andrew1593571/RCETLaserArcade/Documentation/Fall_2024/Images/IMG_5609.PNG

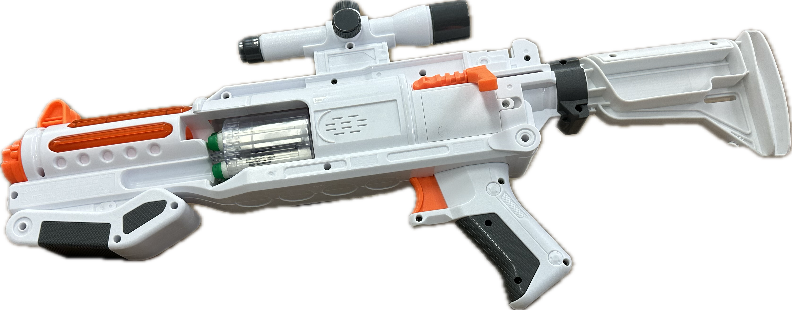
Documentation/Fall_2024/Images/IMG_5609.PNG
