andrew1593571/RCETLaserArcade/Documentation/Fall_2024/Images/Nerf Arcade.jpg

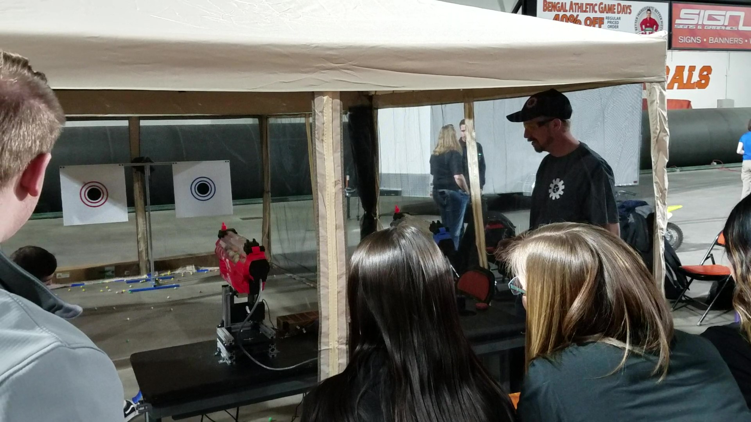
Documentation/Fall_2024/Images/Nerf Arcade.jpg
