andrew1593571/RCETLaserArcade/README.md

# Laser-Arcade-Project
All documentation of the Laser Arcade Project
