andrew1593571/RCETLaserArcade/KiCad/Target_Master/Target Back.png

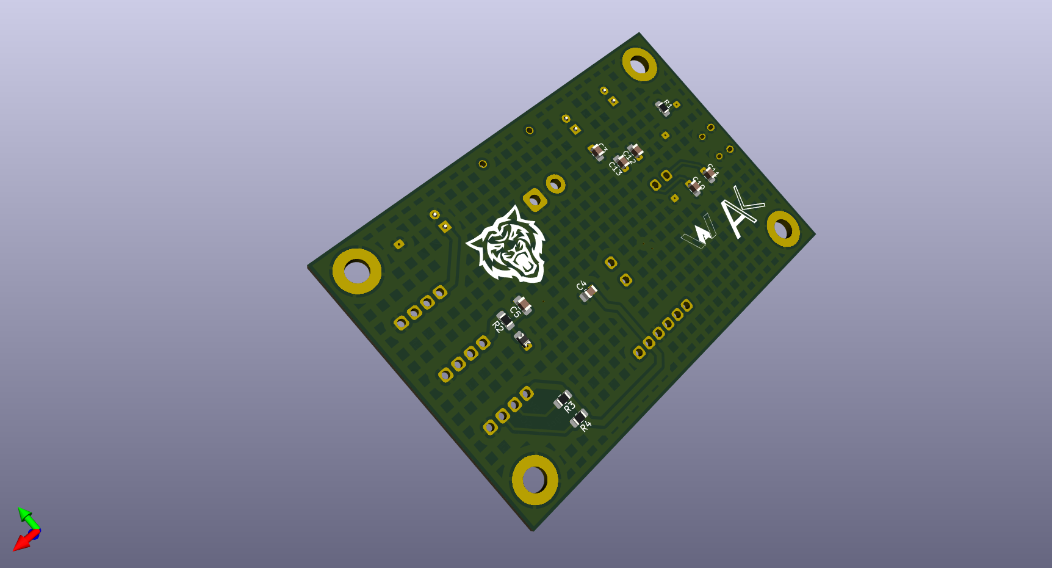
KiCad/Target_Master/Target Back.png
