andrew1593571/RCETLaserArcade/KiCad/Target_Master/Target.png

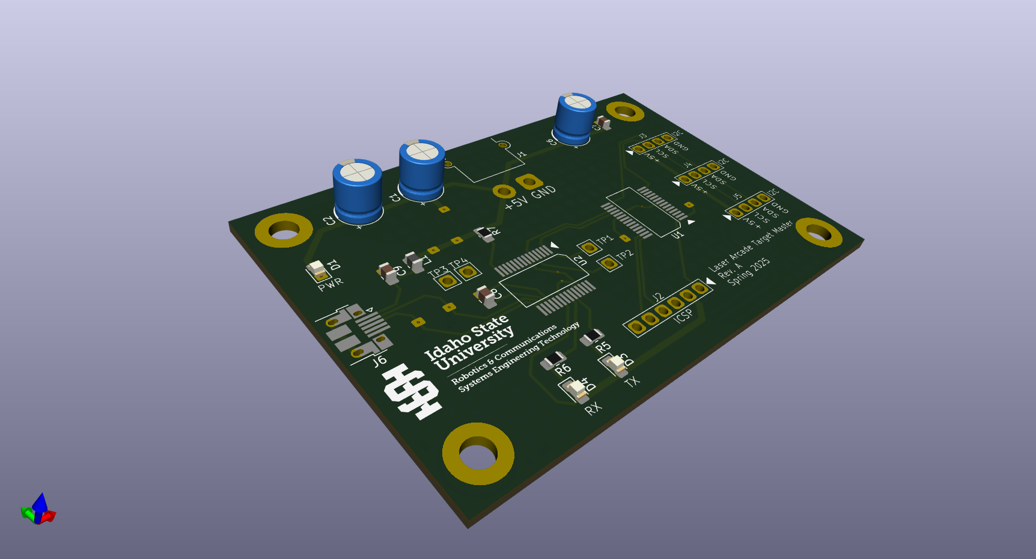
KiCad/Target_Master/Target.png
