andrew1593571/RCETLaserArcade/VBArcadeControl/VBArcadeControl/Resources/serial-port.png

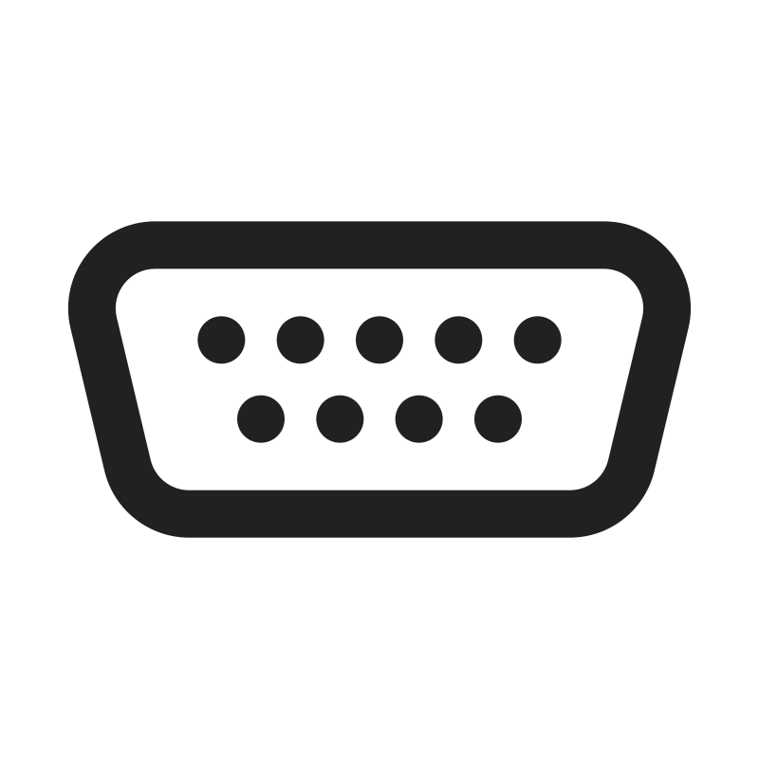
VBArcadeControl/VBArcadeControl/Resources/serial-port.png
