andrew1593571/RCETLaserArcade/Documentation/Fall_2024/Project BOMs.xlsx

Sheet: Blaster
Item Number | Quantity | Component Type | Value | Project Component(s) Included: | Package | Supplier | Part Number | Cost/Part(based on 100 QTY) | Cost for 100 PCB | Cost/PCB | Component Type | Value | Quantity | Part Number | Cost/Part(based on 100 QTY) | Cost/PCB
1 | 2 | Capacitor | 10uF | C1,C2 | 0805 | Mouser | 187-CL21A106MQFNNNE (https://www.mouser.com/ProductDetail/Samsung-Electro-Mechanics/CL21A106MQFNNNE) | $0.022 | $4.40 | $0.044 | Capacitor | 10uF | 2 | 187-CL21A106MQFNNNE (https://www.mouser.com/ProductDetail/Samsung-Electro-Mechanics/CL21A106MQFNNNE) | $0.022 | 0.044
2 | 3 | Capacitor | 1uF | C3,C5,C6 | 0805 | Mouser | 581-KAF21KR71E105KL (https://www.mouser.com/ProductDetail/KYOCERA-AVX/KAF21KR71E105KL) | $0.12 | $36.00 | $0.36 | Capacitor | 1uF | 3 | 581-KAF21KR71E105KL (https://www.mouser.com/ProductDetail/KYOCERA-AVX/KAF21KR71E105KL) | $0.12 | 0.36
3 | 1 | Capacitor | 50pF | C4 | 0805 | Mouser | 791-0805N500J250CT (https://www.mouser.com/ProductDetail/Walsin/0805N500J250CT?qs=ZrPdAQfJ6DN5LhW6Du3x9A%3D%3D) | $0.023 | $2.30 | $0.023 | Capacitor | 50pF | 1 | 791-0805N500J250CT (https://www.mouser.com/ProductDetail/Walsin/0805N500J250CT?qs=ZrPdAQfJ6DN5LhW6Du3x9A%3D%3D) | $0.023 | 0.023
4 | 1 | LED | Green | D1 | 0805 | Mouser | 710-150080GS75000 (https://www.mouser.com/ProductDetail/Wurth-Elektronik/150080GS75000?qs=2kOmHSv6VfQRoTEZVk1mGA%3D%3D) | $0.151 | $15.10 | $0.151 | LED | Green | 1 | 710-150080GS75000 (https://www.mouser.com/ProductDetail/Wurth-Elektronik/150080GS75000?qs=2kOmHSv6VfQRoTEZVk1mGA%3D%3D) | $0.151 | 0.151
5 | 1 | Diode | 1N4148 | D2 | SOD-123F | Mouser | 637-1N4148W (https://www.mouser.com/ProductDetail/Diotec-Semiconductor/1N4148W?qs=OlC7AqGiEDmsbkbAeXQtXg%3D%3D) | $0.031 | $3.10 | $0.031 | Diode | 1N4148 | 1 | 637-1N4148W (https://www.mouser.com/ProductDetail/Diotec-Semiconductor/1N4148W?qs=OlC7AqGiEDmsbkbAeXQtXg%3D%3D) | $0.031 | 0.031
6 | 1 | Pin Header | 1x5 | J1 | 1x5 Vertical Pin Header (P2.54mm) | Mouser | M20-9990546 (https://www.mouser.com/ProductDetail/Harwin/M20-9990546?qs=ulE8k0yEMYY8EKyDN9ic6A%3D%3D) | $0.133 | $13.30 | $0.133 | Pin Header | 1x5 | 1 | M20-9990546 (https://www.mouser.com/ProductDetail/Harwin/M20-9990546?qs=ulE8k0yEMYY8EKyDN9ic6A%3D%3D) | $0.133 | 0.133
7 | 2 | Pin Header | 1x2 | LD1/S1 | 1x2 Vertical Pin Header (P2.54mm) | Mouser | M20-9990246 (https://www.mouser.com/ProductDetail/Harwin/M20-9990246?qs=Jph8NoUxIfWjw4WmyRvzag%3D%3D) | $0.062 | $12.40 | $0.124 | Pin Header | 1x2 | 2 | M20-9990246 (https://www.mouser.com/ProductDetail/Harwin/M20-9990246?qs=Jph8NoUxIfWjw4WmyRvzag%3D%3D) | $0.062 | 0.124
8 | 1 | Laser | Laser Diode | LD1 | N/A | eBay | N/A (https://www.ebay.com/itm/134783770111?chn=ps&google_free_listing_action=view_item) | $3.001 | $300.10 | $3.001 | Laser | Laser Diode | 1 | N/A (https://www.ebay.com/itm/134783770111?chn=ps&google_free_listing_action=view_item) | $3.001 | 3.001
9 | 2 | Transistor | 2N3904 | Q1,Q2 | TO-92 | Mouser | 512-2N3904TA (https://www.mouser.com/ProductDetail/onsemi-Fairchild/2N3904TA?qs=ljbEvF4DwOOn1Ev%2FzRYaoA%3D%3D) | $0.064 | $12.80 | $0.128 | Transistor | 2N3904 | 2 | 512-2N3904TA (https://www.mouser.com/ProductDetail/onsemi-Fairchild/2N3904TA?qs=ljbEvF4DwOOn1Ev%2FzRYaoA%3D%3D) | $0.064 | 0.128
10 | 1 | Transistor | TIP41 | Q3 | TO-220 | Mouser | 511-TIP41C (https://www.mouser.com/ProductDetail/STMicroelectronics/TIP41C?qs=ljbEvF4DwOPALsfJVTZHww%3D%3D) | $0.449 | $44.90 | $0.449 | Transistor | TIP41 | 1 | 511-TIP41C (https://www.mouser.com/ProductDetail/STMicroelectronics/TIP41C?qs=ljbEvF4DwOPALsfJVTZHww%3D%3D) | $0.449 | 0.449
11 | 1 | Resistor | 2.2KΩ | R1 | 0805 | Mouser | 71-CRCW080522K0JNEAC (https://www.mouser.com/ProductDetail/Vishay-Dale/CRCW080522K0JNEAC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) | $0.01 | $1.00 | $0.01 | Resistor | 2.2KΩ | 1 | 71-CRCW080522K0JNEAC (https://www.mouser.com/ProductDetail/Vishay-Dale/CRCW080522K0JNEAC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) | $0.01 | 0.01
12 | 4 | Resistor | 330Ω | R2,R3,R4,R5 | 0805 | Mouser | 603-RC0805JR-13330RL (https://www.mouser.com/ProductDetail/YAGEO/RC0805JR-13330RL) | $0.009 | $3.60 | $0.036 | Resistor | 330Ω | 4 | 603-RC0805JR-13330RL (https://www.mouser.com/ProductDetail/YAGEO/RC0805JR-13330RL) | $0.009 | 0.036
13 | 1 | Resistor | 1kΩ | R6 | 0805 | Mouser | 667-ERA-6APB102V (https://www.mouser.com/ProductDetail/Panasonic/ERA-6APB102V?qs=sGAEpiMZZMtlubZbdhIBIJiMSTY83nT4MhkwRno9TZY%3D) | $0.266 | $26.60 | $0.266 | Resistor | 1kΩ | 1 | 667-ERA-6APB102V (https://www.mouser.com/ProductDetail/Panasonic/ERA-6APB102V?qs=sGAEpiMZZMtlubZbdhIBIJiMSTY83nT4MhkwRno9TZY%3D) | $0.266 | 0.266
14 | 1 | Resistor | 40kΩ | R7 | 0805 | Mouser | 71-CRCW080540K0FKEA (https://www.mouser.com/ProductDetail/Vishay-Dale/CRCW080540K0FKEA) | $0.018 | $1.80 | $0.018 | Resistor | 40kΩ | 1 | 71-CRCW080540K0FKEA (https://www.mouser.com/ProductDetail/Vishay-Dale/CRCW080540K0FKEA) | $0.018 | 0.018
15 | 1 | Resistor | 10kΩ | R8 | 0805 | Mouser | 791-RMC1/10K1002FTP (https://www.mouser.com/ProductDetail/Kamaya/RMC1-10K1002FTP) | $0.008 | $0.80 | $0.008 | Resistor | 10kΩ | 1 | 791-RMC1/10K1002FTP (https://www.mouser.com/ProductDetail/Kamaya/RMC1-10K1002FTP) | $0.008 | 0.008
16 | 1 | Solenoid | 12V | S1 | N/A | Amazon | BM-0530B (https://www.amazon.com/Baomain-Solenoid-Electromagnet-JF-0530B-PushPull/dp/B01K41EZAU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) | $7.49 | $749.00 | $7.49 | Solenoid | 12V | 1 | BM-0530B (https://www.amazon.com/Baomain-Solenoid-Electromagnet-JF-0530B-PushPull/dp/B01K41EZAU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) | $7.49 | 7.49
17 | 1 | Switch | Momentary | SW1 | N/A | Amazon | TS-D001 (https://www.amazon.com/Momentary-Pushbutton-Switches-Breadboard-Electronic/dp/B09R47N37H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) | $0.05 | $5.00 | $0.05 | Switch | Momentary | 1 | TS-D001 (https://www.amazon.com/Momentary-Pushbutton-Switches-Breadboard-Electronic/dp/B09R47N37H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) | $0.05 | 0.05
18 | 1 | Switch | Toggle | SW2 | N/A | Mouser | 612-EG1215AA (https://www.mouser.com/ProductDetail/E-Switch/EG1215AA?qs=lc2O%252BfHJPVZHH%2F6aw0qQrA%3D%3D&mgh=1) | $0.683 | $68.30 | $0.683 | Switch | Toggle | 1 | 612-EG1215AA (https://www.mouser.com/ProductDetail/E-Switch/EG1215AA?qs=lc2O%252BfHJPVZHH%2F6aw0qQrA%3D%3D&mgh=1) | $0.683 | 0.683
19 | 1 | Switch | SP3T | SW3 | N/A | Jameco | 2236244 (https://www.jameco.com/z/SR2513-43NS-Taiwan-Alpha-4-Poles-3-Positions-Rotary-Switch-300mA-125VAC-Non-Shorting_2236244.html) | $0.35 | $35.00 | $0.35 | Switch | SP3T | 1 | 2236244 (https://www.jameco.com/z/SR2513-43NS-Taiwan-Alpha-4-Poles-3-Positions-Rotary-Switch-300mA-125VAC-Non-Shorting_2236244.html) | $0.35 | 0.35
20 | 1 | Voltage Regulator | AMS1117-5.0 | U1 | SOT-223 | Mouser | 926-LM1117MPX5.0NOPB (https://www.mouser.com/ProductDetail/Texas-Instruments/LM1117MPX-5.0-NOPB?qs=X1J7HmVL2ZE1O12Qsl7F9g%3D%3D) | $0.543 | $54.30 | $0.543 | Voltage Regulator | AMS1117-5.0 | 1 | 926-LM1117MPX5.0NOPB (https://www.mouser.com/ProductDetail/Texas-Instruments/LM1117MPX-5.0-NOPB?qs=X1J7HmVL2ZE1O12Qsl7F9g%3D%3D) | $0.543 | 0.543
21 | 1 | Microcontroller | PIC16F1788 | U2 | SSOP-28 | Mouser | 579-PIC16F1788T-I/SS (https://www.mouser.com/ProductDetail/Microchip-Technology/PIC16F1788T-I-SS?qs=7DhvGWG6CteZbh5vjho%2Fqg%3D%3D) | $2.25 | $225.00 | $2.25 | Microcontroller | PIC16F1788 | 1 | 579-PIC16F1788T-I/SS (https://www.mouser.com/ProductDetail/Microchip-Technology/PIC16F1788T-I-SS?qs=7DhvGWG6CteZbh5vjho%2Fqg%3D%3D) | $2.25 | 2.25
 |  |  |  |  |  |  |  |  | Total: | $16.15 |  |  |  |  | Total: | $16.15
 |  |  |  |  |  |  |  |  | Total per 100: | $1614.80

Sheet: Master
Item Number | Quantity | Component Type | Value | Project Component(s) Included: | Package | Supplier | Part Number | Cost/Part(based on 100 QTY) | Cost for 100 PCB | Cost/PCB | Component Type | Value | Quantity | Part Number | Cost/Part(based on 100 QTY) | Cost/PCB
1 | 2 | Capacitor | 10uF | C1,C2 | 0805 | Mouser | 187-CL21A106MQFNNNE (https://www.mouser.com/ProductDetail/Samsung-Electro-Mechanics/CL21A106MQFNNNE) | $0.022 | $4.40 | $0.04 | Capacitor | 10uF | 2 | 187-CL21A106MQFNNNE (https://www.mouser.com/ProductDetail/Samsung-Electro-Mechanics/CL21A106MQFNNNE) | $0.022 | $0.04
2 | 3 | Capacitor | 1uF | C3,C4,C5 | 0805 | Mouser | 581-KAF21KR71E105KL (https://www.mouser.com/ProductDetail/KYOCERA-AVX/KAF21KR71E105KL) | $0.12 | $36.00 | $0.36 | Capacitor | 1uF | 3 | 581-KAF21KR71E105KL (https://www.mouser.com/ProductDetail/KYOCERA-AVX/KAF21KR71E105KL) | $0.12 | $0.36
3 | 1 | LED | Green | D1 | 0805 | Mouser | 710-150080GS75000 (https://www.mouser.com/ProductDetail/Wurth-Elektronik/150080GS75000?qs=2kOmHSv6VfQRoTEZVk1mGA%3D%3D) | $0.151 | $15.10 | $0.151 | LED | Green | 1 | 710-150080GS75000 (https://www.mouser.com/ProductDetail/Wurth-Elektronik/150080GS75000?qs=2kOmHSv6VfQRoTEZVk1mGA%3D%3D) | $0.151 | $0.15
4 | 1 | Diode | 1N4148 | D2 | SOD-123F | Mouser | 637-1N4148W (https://www.mouser.com/ProductDetail/Diotec-Semiconductor/1N4148W?qs=OlC7AqGiEDmsbkbAeXQtXg%3D%3D) | $0.031 | $3.10 | $0.031 | Diode | 1N4148 | 1 | 637-1N4148W (https://www.mouser.com/ProductDetail/Diotec-Semiconductor/1N4148W?qs=OlC7AqGiEDmsbkbAeXQtXg%3D%3D) | $0.031 | $0.03
5 | 1 | LCD Display | LK204-25 | DS1 | N/A | Mouser | 891-LK204-25-E (https://www.mouser.com/ProductDetail/Matrix-Orbital/LK204-25-E?qs=sBNdiSg%2FL5WqFSFQuSy%2FbQ%3D%3D) | $67.72 | $6772.00 | $67.72 | LCD Display | LK204-25 | 1 | 891-LK204-25-E (https://www.mouser.com/ProductDetail/Matrix-Orbital/LK204-25-E?qs=sBNdiSg%2FL5WqFSFQuSy%2FbQ%3D%3D) | $67.72 | $67.72
6 | 1 | Connector | RJ11 Header | J1 | Female | Mouser | 649-54601-906001WPLF (https://www.mouser.com/ProductDetail/Amphenol-FCI/54601-906001WPLF?qs=A%252Bwkq3FTowXIf3bXQPL90g%3D%3D) | $0.104 | $10.40 | $0.104 | Connector | RJ11 Header | 1 | 649-54601-906001WPLF (https://www.mouser.com/ProductDetail/Amphenol-FCI/54601-906001WPLF?qs=A%252Bwkq3FTowXIf3bXQPL90g%3D%3D) | $0.104 | $0.10
7 | 1 | Pin Header | 1x5 | J2 | 1x5 Vertical Pin Header (P2.54mm) | Mouser | M20-9990546 (https://www.mouser.com/ProductDetail/Harwin/M20-9990546?qs=ulE8k0yEMYY8EKyDN9ic6A%3D%3D) | $0.133 | $13.30 | $0.133 | Pin Header | 1x5 | 1 | M20-9990546 (https://www.mouser.com/ProductDetail/Harwin/M20-9990546?qs=ulE8k0yEMYY8EKyDN9ic6A%3D%3D) | $0.133 | $0.13
8 | 1 | Resistor | 2.2KΩ | R1 | 0805 | Mouser | 71-CRCW080522K0JNEAC (https://www.mouser.com/ProductDetail/Vishay-Dale/CRCW080522K0JNEAC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) | $0.01 | $1.00 | $0.01 | Resistor | 2.2KΩ | 1 | 71-CRCW080522K0JNEAC (https://www.mouser.com/ProductDetail/Vishay-Dale/CRCW080522K0JNEAC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) | $0.01 | $0.01
9 | 1 | Resistor | 10kΩ | R2 | 0805 | Mouser | 791-RMC1/10K1002FTP (https://www.mouser.com/ProductDetail/Kamaya/RMC1-10K1002FTP) | $0.008 | $0.80 | $0.008 | Resistor | 10kΩ | 1 | 791-RMC1/10K1002FTP (https://www.mouser.com/ProductDetail/Kamaya/RMC1-10K1002FTP) | $0.008 | $0.01
10 | 2 | Resistor | 4.7kΩ | R3,R4 | 0805 | Mouser | 603-AC0805DR-074K7L (https://www.mouser.com/ProductDetail/YAGEO/AC0805DR-074K7L) | $0.023 | $4.60 | $0.05 | Resistor | 4.7kΩ | 2 | 603-AC0805DR-074K7L (https://www.mouser.com/ProductDetail/YAGEO/AC0805DR-074K7L) | $0.023 | $0.05
11 | 1 | Voltage Regulator | AMS1117-5.0 | U1 | SOT-223 | Mouser | 926-LM1117MPX5.0NOPB (https://www.mouser.com/ProductDetail/Texas-Instruments/LM1117MPX-5.0-NOPB?qs=X1J7HmVL2ZE1O12Qsl7F9g%3D%3D) | $0.543 | $54.30 | $0.543 | Voltage Regulator | AMS1117-5.0 | 1 | 926-LM1117MPX5.0NOPB (https://www.mouser.com/ProductDetail/Texas-Instruments/LM1117MPX-5.0-NOPB?qs=X1J7HmVL2ZE1O12Qsl7F9g%3D%3D) | $0.543 | $0.54
12 | 1 | Microcontroller | PIC16F1788 | U2 | SSOP-28 | Mouser | 579-PIC16F1788T-I/SS (https://www.mouser.com/ProductDetail/Microchip-Technology/PIC16F1788T-I-SS?qs=7DhvGWG6CteZbh5vjho%2Fqg%3D%3D) | $2.25 | $225.00 | $2.25 | Microcontroller | PIC16F1788 | 1 | 579-PIC16F1788T-I/SS (https://www.mouser.com/ProductDetail/Microchip-Technology/PIC16F1788T-I-SS?qs=7DhvGWG6CteZbh5vjho%2Fqg%3D%3D) | $2.25 | $2.25
 |  |  |  |  |  |  |  |  | Total: | $71.40 |  |  |  |  | Total: | $71.40 | $0.00 | $0.00
 |  |  |  |  |  |  |  |  | Total per 100: | $7140.00

Sheet: Slave
Item Number | Quantity | Component Type | Value | Project Component(s) Included: | Package | Supplier | Part Number | Cost/Part(based on 100 QTY) | Cost for 100 PCB | Cost/PCB
1 | 4 | Capacitor | 1uF | C1,C2,C3,C4 | 0805 | Mouser | 581-KAF21KR71E105KL (https://www.mouser.com/ProductDetail/KYOCERA-AVX/KAF21KR71E105KL) | $0.12 | $48.00 | $0.48
2 | 1 | Diode | 1N4148 | D1 | SOD-123F | Mouser | 637-1N4148W (https://www.mouser.com/ProductDetail/Diotec-Semiconductor/1N4148W?qs=OlC7AqGiEDmsbkbAeXQtXg%3D%3D) | $0.031 | $3.10 | $0.031
3 | 16 | LED | Red | D2,D3,D4,D5,D6,D7,D8,D9,D10,D11,D12,D13,D14,D15,D16,D17 | 0805 | Mouser | 710-150080RS75000 (https://www.mouser.com/ProductDetail/Wurth-Elektronik/150080RS75000?qs=LlUlMxKIyB2jdCo7bnfgew%3D%3D) | $0.151 | $241.60 | $2.416
4 | 1 | Pin Header | 1x5 | J1 | 1x5 Vertical Pin Header (P2.54mm) | Mouser | M20-9990546 (https://www.mouser.com/ProductDetail/Harwin/M20-9990546?qs=ulE8k0yEMYY8EKyDN9ic6A%3D%3D) | $0.133 | $13.30 | $0.133
5 | 2 | Connector | RJ11 Header | J2,J3 | Female | Mouser | 649-54601-906001WPLF (https://www.mouser.com/ProductDetail/Amphenol-FCI/54601-906001WPLF?qs=A%252Bwkq3FTowXIf3bXQPL90g%3D%3D) | $0.104 | $20.80 | $0.208
6 | 1 | Transistor | STN851 | Q1 | SOT-223-4 | Mouser | 511-STN851-A (https://www.mouser.com/ProductDetail/STMicroelectronics/STN851-A?qs=ZGWq6n3A68IcJvqLg9%252BYsA%3D%3D) | $0.453 | $45.30 | $0.453
7 | 1 | Resistor | 10kΩ | R1 | 0805 | Mouser | 791-RMC1/10K1002FTP (https://www.mouser.com/ProductDetail/Kamaya/RMC1-10K1002FTP) | $0.008 | $0.80 | $0.008
8 | 16 | Resistor | 330Ω | R2,R3,R4,R5,R6,R7,R8,R10,R11,R12,R13,R14,R15,R16,R17,R18 | 0805 | Mouser | 603-RC0805JR-13330RL (https://www.mouser.com/ProductDetail/YAGEO/RC0805JR-13330RL) | $0.009 | $14.40 | $0.144
9 | 1 | Resistor | 4.7kΩ | R9 | 0805 | Mouser | 603-AC0805DR-074K7L (https://www.mouser.com/ProductDetail/YAGEO/AC0805DR-074K7L) | $0.023 | $2.30 | $0.023 | Component Type | Value | Quantity | Part Number | Cost/Part(based on 100 QTY) | Cost/PCB | Cost/PCB
10 | 1 | IR Receiver | TSOP32238 | U1 | N/A | Mouser | 782-TSOP32238 (https://www.mouser.com/ProductDetail/Vishay-Semiconductors/TSOP32238?qs=EABMROi2%2FsKT2FOMevD8qg%3D%3D) | $0.549 | $54.90 | $0.55 | Capacitor | 1uF | 4 | 581-KAF21KR71E105KL (https://www.mouser.com/ProductDetail/KYOCERA-AVX/KAF21KR71E105KL) | $0.12 | $0.48 | $0.48
11 | 1 | IR Receiver | TSOP53456 | U2 | N/A | Mouser | 78-TSOP53456 (https://www.mouser.com/ProductDetail/Vishay-Semiconductors/TSOP53456?qs=Zedt2TSEyhhZyPG8LSxNcg%3D%3D) | $0.39 | $39.40 | $0.394 | Diode | 1N4148 | 1 | 637-1N4148W (https://www.mouser.com/ProductDetail/Diotec-Semiconductor/1N4148W?qs=OlC7AqGiEDmsbkbAeXQtXg%3D%3D) | $0.031 | $0.03 | $0.03
12 | 1 | Microcontroller | PIC16F1788 | U3 | SSOP-28 | Mouser | 579-PIC16F1788T-I/SS (https://www.mouser.com/ProductDetail/Microchip-Technology/PIC16F1788T-I-SS?qs=7DhvGWG6CteZbh5vjho%2Fqg%3D%3D) | $2.25 | $225.00 | $2.25 | LED | Red | 16 | 710-150080RS75000 (https://www.mouser.com/ProductDetail/Wurth-Elektronik/150080RS75000?qs=LlUlMxKIyB2jdCo7bnfgew%3D%3D) | $0.151 | $2.42 | $2.42
 |  |  |  |  |  |  |  |  |  |  | Pin Header | 1x5 | 1 | M20-9990546 (https://www.mouser.com/ProductDetail/Harwin/M20-9990546?qs=ulE8k0yEMYY8EKyDN9ic6A%3D%3D) | $0.133 | $0.13 | $0.13
 |  |  |  |  |  |  |  |  | Total: | $7.09 | Connector | RJ11 Header | 2 | 649-54601-906001WPLF (https://www.mouser.com/ProductDetail/Amphenol-FCI/54601-906001WPLF?qs=A%252Bwkq3FTowXIf3bXQPL90g%3D%3D) | $0.104 | $0.21 | $0.21
 |  |  |  |  |  |  |  |  | Total per 100: | $701.00 | Transistor | STN851 | 1 | 511-STN851-A (https://www.mouser.com/ProductDetail/STMicroelectronics/STN851-A?qs=ZGWq6n3A68IcJvqLg9%252BYsA%3D%3D) | $0.453 | $0.45 | $0.45
 |  |  |  |  |  |  |  |  |  |  | Resistor | 10kΩ | 1 | 791-RMC1/10K1002FTP (https://www.mouser.com/ProductDetail/Kamaya/RMC1-10K1002FTP) | $0.008 | $0.01 | $0.01
 |  |  | Component Type | Value | Quantity | Cost/Part(based on 100 QTY) | Cost for 100 PCB | Cost/PCB |  |  | Resistor | 330Ω | 16 | 603-RC0805JR-13330RL (https://www.mouser.com/ProductDetail/YAGEO/RC0805JR-13330RL) | $0.009 | $0.14 | $0.14
 |  |  | Capacitor | 1uF | 4 | $0.12 | $12.00 | $0.12 |  |  | Resistor | 4.7kΩ | 1 | 603-AC0805DR-074K7L (https://www.mouser.com/ProductDetail/YAGEO/AC0805DR-074K7L) | $0.023 | $0.02 | $0.02
 |  |  | Diode | 1N4148 | 1 | $0.031 | $3.10 | $0.031 |  |  | IR Receiver | TSOP32238 | 1 | 782-TSOP32238 (https://www.mouser.com/ProductDetail/Vishay-Semiconductors/TSOP32238?qs=EABMROi2%2FsKT2FOMevD8qg%3D%3D) | $0.549 | $0.55 | $0.55
 |  |  | LED | Red | 16 | $0.151 | $15.10 | $0.151 |  |  | IR Receiver | TSOP53456 | 1 | 78-TSOP53456 (https://www.mouser.com/ProductDetail/Vishay-Semiconductors/TSOP53456?qs=Zedt2TSEyhhZyPG8LSxNcg%3D%3D) | $0.39 | $0.39 | $0.39
 |  |  | Pin Header | 1x5 | 1 | $0.133 | $13.30 | $0.133 |  |  | Microcontroller | PIC16F1788 | 1 | 579-PIC16F1788T-I/SS (https://www.mouser.com/ProductDetail/Microchip-Technology/PIC16F1788T-I-SS?qs=7DhvGWG6CteZbh5vjho%2Fqg%3D%3D) | $2.25 | $2.25 | $2.25
 |  |  | Connector | RJ11 Header | 2 | $0.104 | $10.40 | $0.104
 |  |  | Transistor | STN851 | 1 | $0.453 | $45.30 | $0.453 |  |  |  |  |  |  | Total: | $7.09 | $7.09 | Total: | $0.00
 |  |  | Resistor | 10kΩ | 1 | $0.008 | $0.80 | $0.008 |  |  |  |  |  |  |  |  |  | Total per 100: | $701.00
 |  |  | Resistor | 330Ω | 16 | $0.009 | $0.90 | $0.009
 |  |  | Resistor | 4.7kΩ | 1 | $0.023 | $2.30 | $0.023
 |  |  | IR Receiver | TSOP32238 | 1 | $0.549 | $54.90 | $0.55
 |  |  | IR Receiver | TSOP53456 | 1 | $0.39 | $39.40 | $0.394
 |  |  | Microcontroller | PIC16F1788 | 1 | $2.25 | $225.00 | $2.25
