andrew1593571/RCETLaserArcade/Documentation/Fall_2024/Project.xlsx

Reference | Value | Datasheet | Footprint | Qty | DNP
BT1 | 12V | ~ |  | 1
C1,C2 | 10uF | ~ | Capacitor_SMD:C_0805_2012Metric_Pad1.18x1.45mm_HandSolder | 2
C3,C5,C6 | 1uF | ~ | Capacitor_SMD:C_0805_2012Metric_Pad1.18x1.45mm_HandSolder | 3
C4 | 50pF | ~ | Capacitor_SMD:C_0805_2012Metric_Pad1.18x1.45mm_HandSolder | 1
D1 | LED | ~ | LED_SMD:LED_0805_2012Metric_Pad1.15x1.40mm_HandSolder | 1
D2 | 1N4148 | https://assets.nexperia.com/documents/data-sheet/1N4148_1N4448.pdf | Diode_SMD:D_0805_2012Metric_Pad1.15x1.40mm_HandSolder | 1
J1 | ~ |  | Connector_PinHeader_2.54mm:PinHeader_1x05_P2.54mm_Vertical | 1
LD1 | Laser Diode | ~ | Connector_PinHeader_2.54mm:PinHeader_1x02_P2.54mm_Vertical | 1
Q1,Q2 | 2N3904 | https://www.onsemi.com/pub/Collateral/2N3903-D.PDF | Package_TO_SOT_THT:TO-92_Inline | 2
Q3 | TIP41 | https://www.centralsemi.com/get_document.php?cmp=1&mergetype=pd&mergepath=pd&pdf_id=tip41.PDF | Package_TO_SOT_THT:TO-220-3_Vertical | 1
R1 | 2.2KΩ | ~ | Resistor_SMD:R_0805_2012Metric_Pad1.20x1.40mm_HandSolder | 1
R1-R4,R2,R3,R4 | 330Ω | ~ | Resistor_SMD:R_0805_2012Metric_Pad1.20x1.40mm_HandSolder | 4
R5 | 1kΩ | ~ | Resistor_SMD:R_0805_2012Metric_Pad1.20x1.40mm_HandSolder | 1
R6 | 40kΩ | ~ | Resistor_SMD:R_0805_2012Metric_Pad1.20x1.40mm_HandSolder | 1
R7 | 10kΩ | ~ | Resistor_SMD:R_0805_2012Metric_Pad1.20x1.40mm_HandSolder | 1
S1 | Solenoid |  | Connector_PinHeader_2.54mm:PinHeader_1x02_P2.54mm_Vertical | 1
SW1 | SW_Push | ~ |  | 1
SW2 | SW_DIP_x01 | ~ |  | 1
SW3 | SW_SP3T | ~ |  | 1
TP1,TP2,TP3,TP4,TP5,TP6,TP7,TP8 | TestPoint | ~ | AlexWheelockFootprintLibrary:Test Point | 8
U1 | AMS1117-5 | http://www.advanced-monolithic.com/pdf/ds1117.pdf | Package_TO_SOT_SMD:SOT-223-3_TabPin2 | 1
U2 | PIC16F1788-IP |  |  | 1
