andrew1593571/RCETLaserArcade/3D_Models/Blaster/Laser_Arcade_Blaster_Barrel_v2.3mf

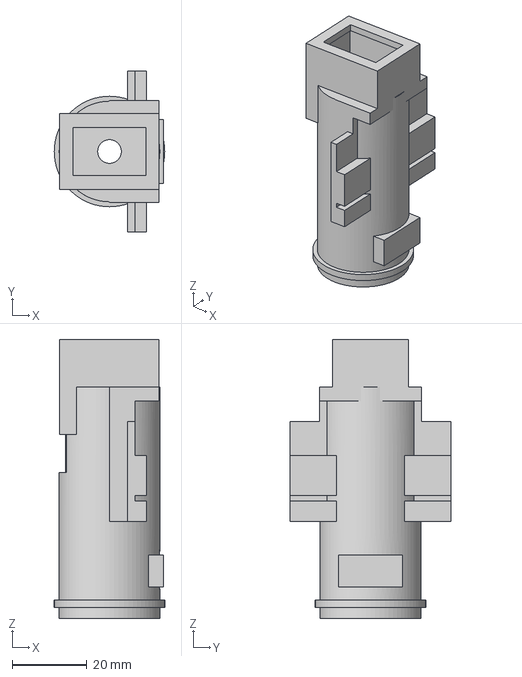
[picture p8: CAD file, 2025-04-29]
3D_Models/Blaster/Laser_Arcade_Blaster_Barrel_v2.3mf
29.6 x 43.1 x 74.7 mm
