andrew1593571/RCETLaserArcade/3D_Models/Targets/LA_4inTarget.stl

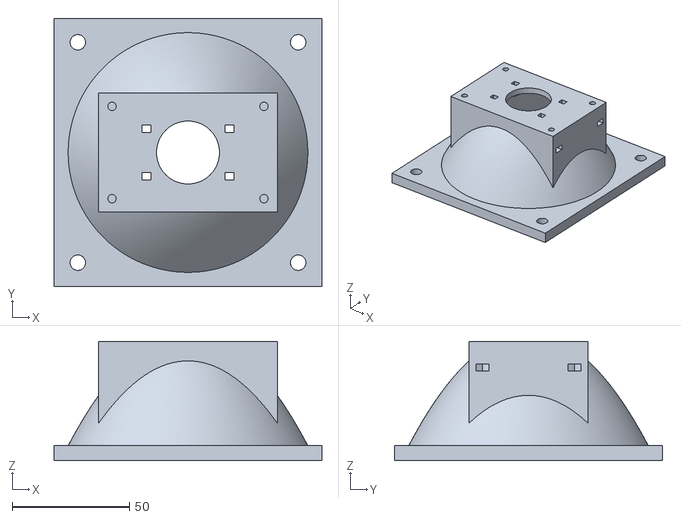
[picture p9: CAD file, 2025-05-08]
3D_Models/Targets/LA_4inTarget.stl
114.3 x 114.3 x 50.8
