andrew1593571/RCETLaserArcade/3D_Models/Blaster/Laser_Arcade_Blaster_Rear_Hook_v2.3mf

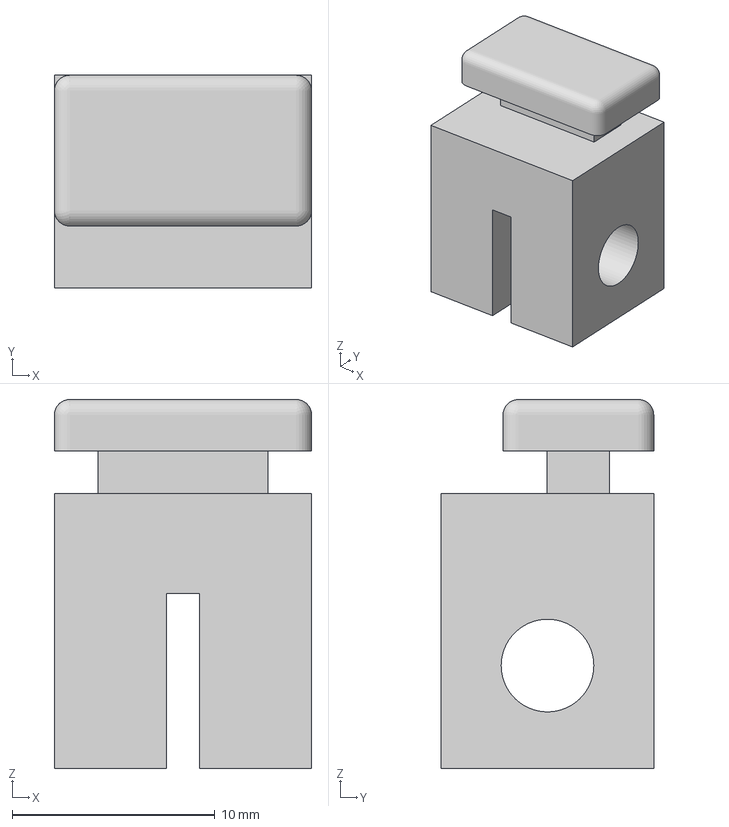
[picture p10: CAD file, 2025-04-29]
3D_Models/Blaster/Laser_Arcade_Blaster_Rear_Hook_v2.3mf
12.7 x 10.5 x 18.2 mm
