andrew1593571/RCETLaserArcade/3D_Models/Targets/LA_DIN Rail Mount.stl

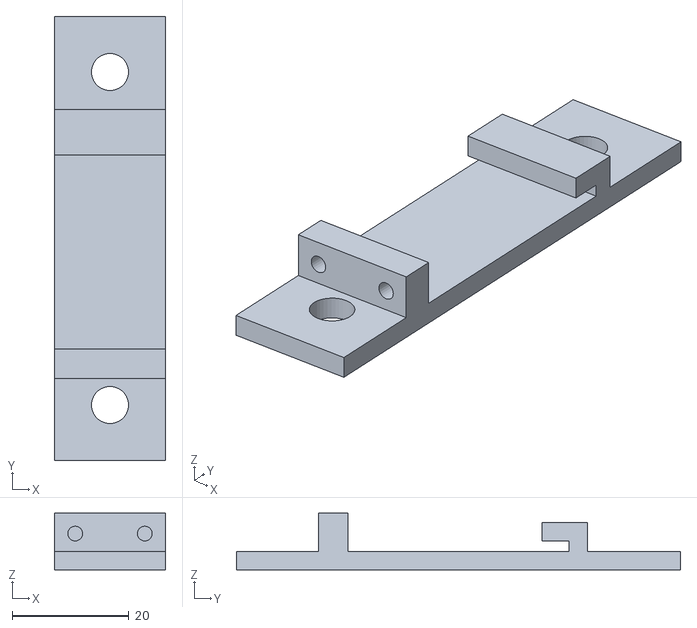
[picture p11: CAD file, 2025-05-08]
3D_Models/Targets/LA_DIN Rail Mount.stl
19.0 x 76.2 x 9.72
