andrew1593571/RCETLaserArcade/3D_Models/Targets/LA_Master DIN Rail Mount.stl

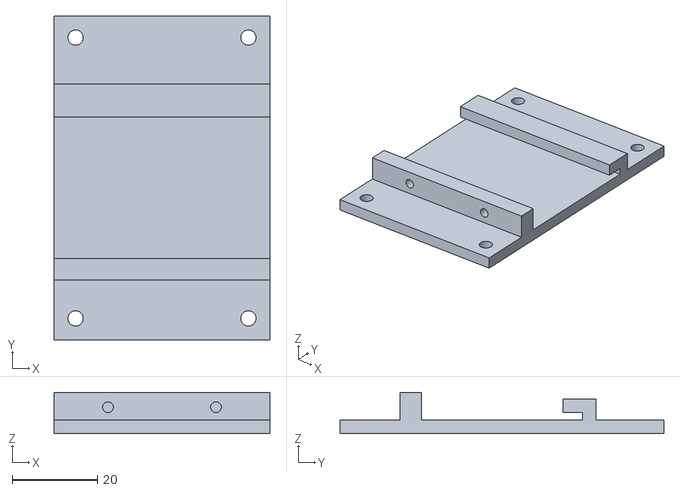
[picture p12: CAD file, 2025-05-08]
3D_Models/Targets/LA_Master DIN Rail Mount.stl
50.8 x 76.2 x 9.72
