andrew1593571/RCETLaserArcade/3D_Models/Blaster/Laser_Arcade_Blaster_Solenoid_Mount_v3.3mf

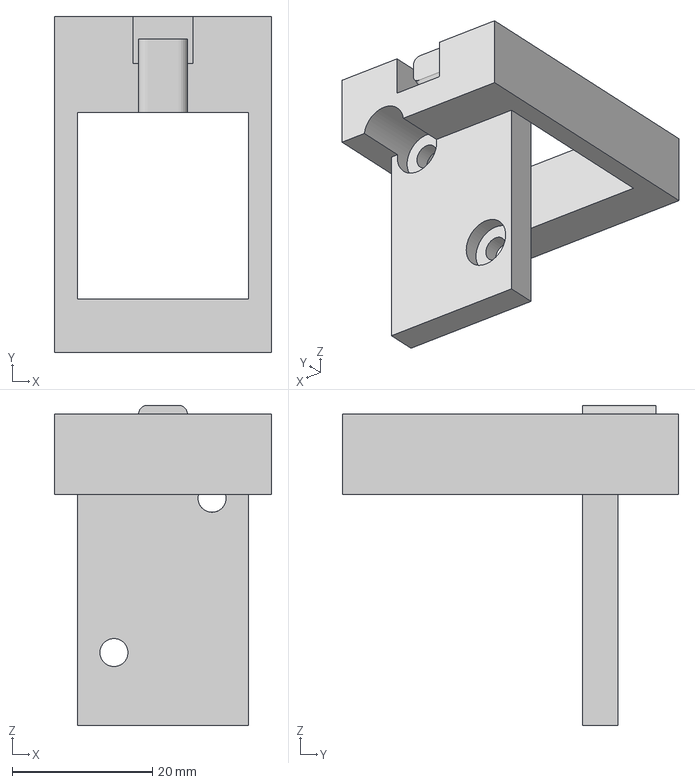
[picture p13: CAD file, 2025-04-29]
3D_Models/Blaster/Laser_Arcade_Blaster_Solenoid_Mount_v3.3mf
31.0 x 47.9 x 45.7 mm
