andrew1593571/RCETLaserArcade/3D_Models/Blaster/Laser_Arcade_Blaster_Speaker_Box_v2.3mf

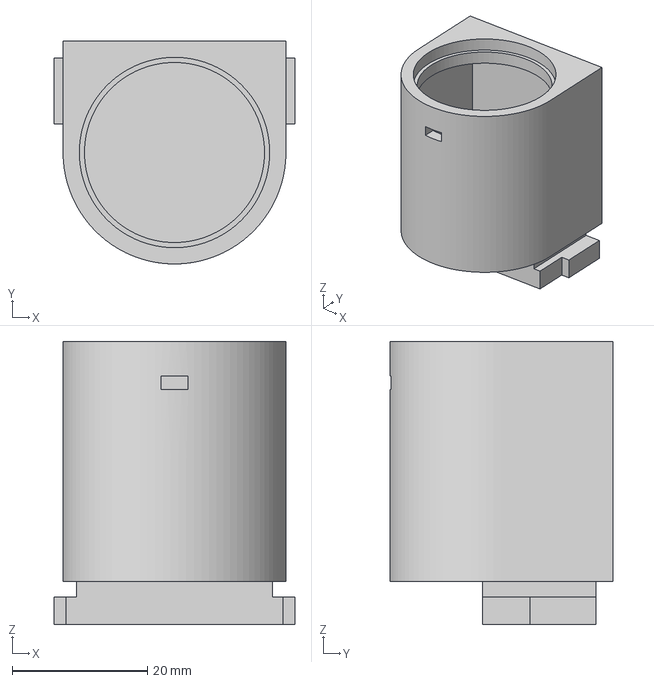
[picture p14: CAD file, 2025-04-24]
3D_Models/Blaster/Laser_Arcade_Blaster_Speaker_Box_v2.3mf
35.7 x 33.0 x 41.9 mm
