andrew1593571/RCETLaserArcade/3D_Models/Blaster/Laser_Arcade_Blaster_Solenoid_Mount_v2.3mf

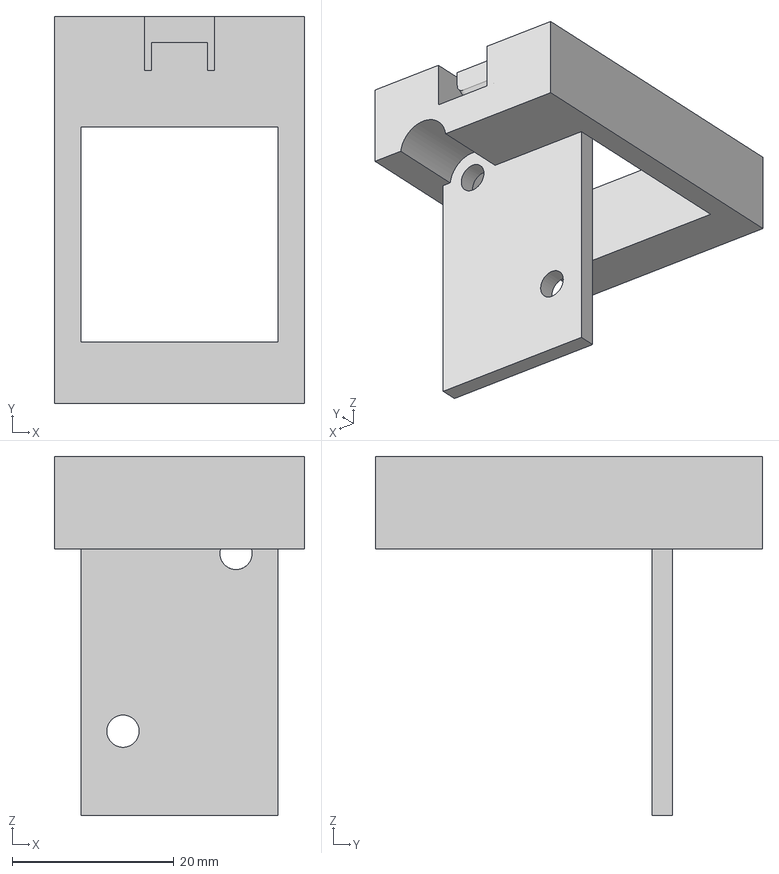
[picture p15: CAD file, 2025-04-29, an earlier design]
3D_Models/Blaster/Laser_Arcade_Blaster_Solenoid_Mount_v2.3mf
31.0 x 47.9 x 44.4 mm
