andrew1593571/RCETLaserArcade/KiCad/Target_Master/Laser Arcade Master Schematic.pdf

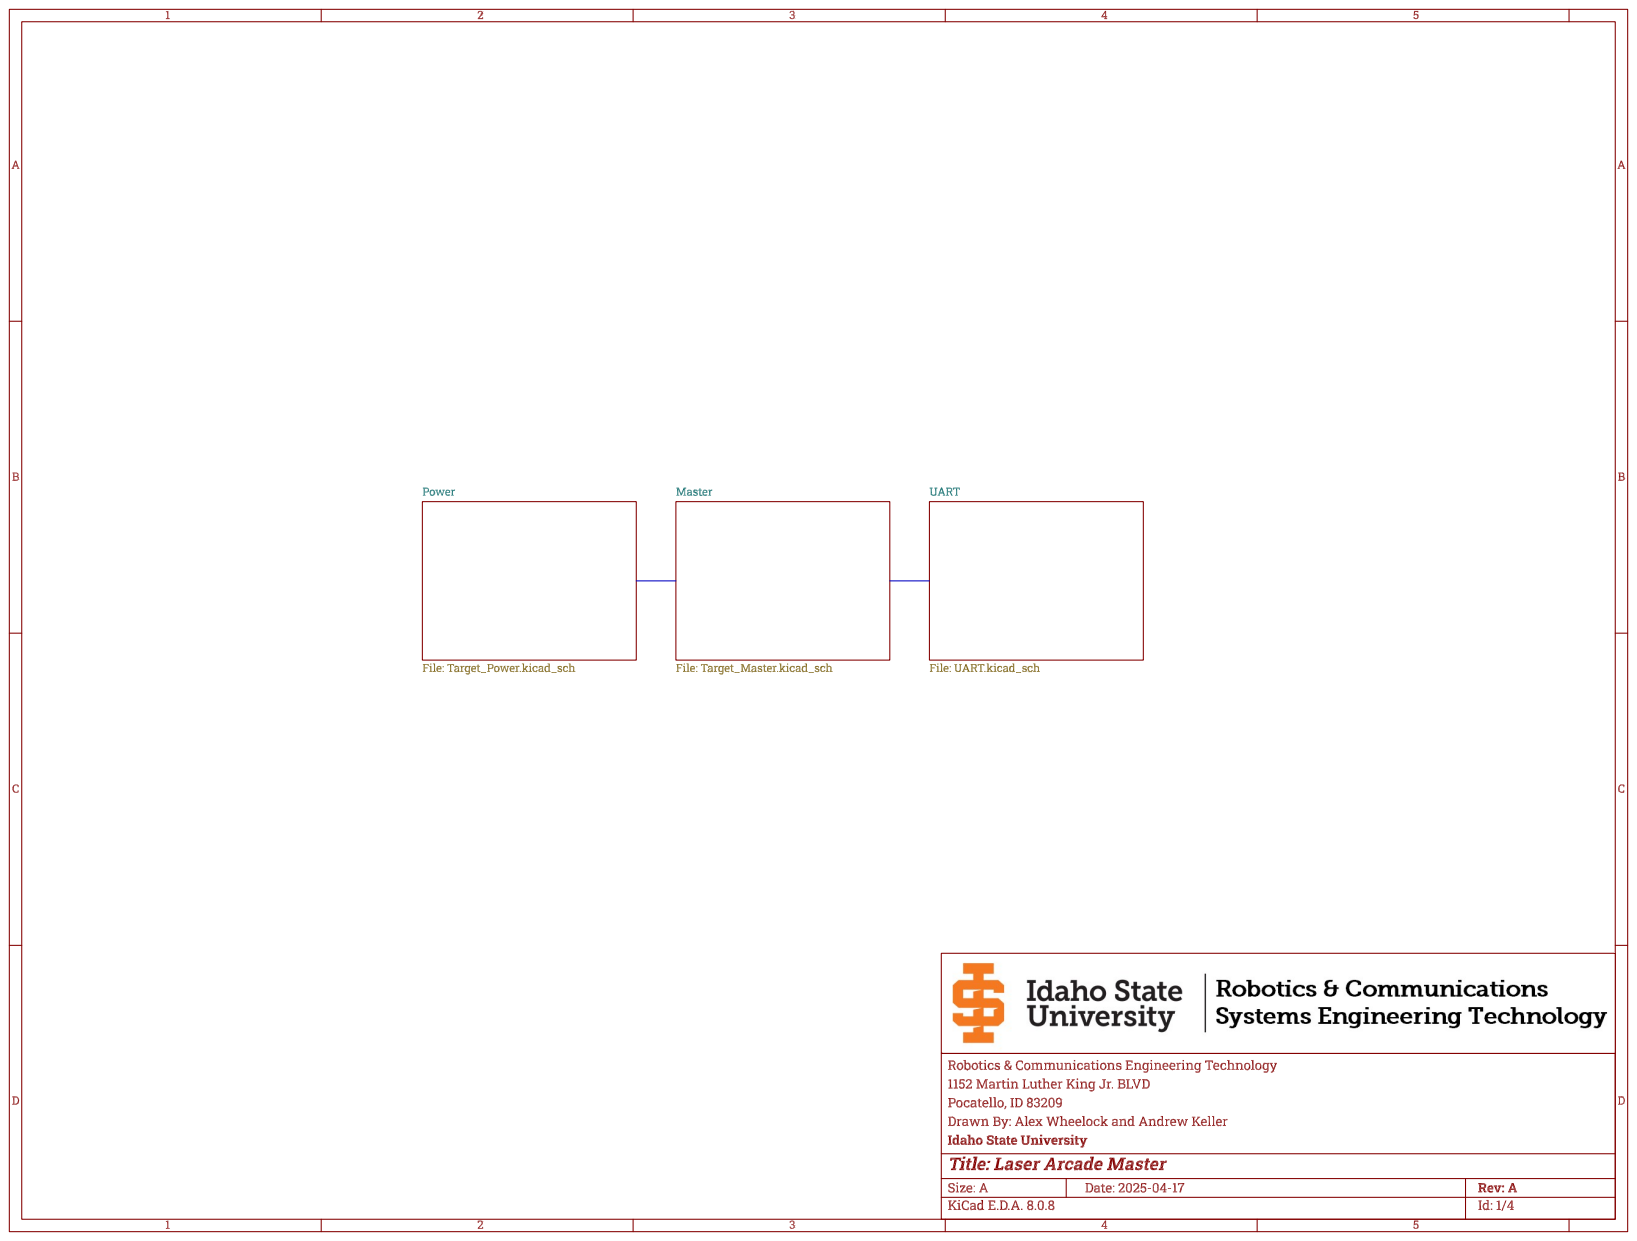
[picture p16: page 1]

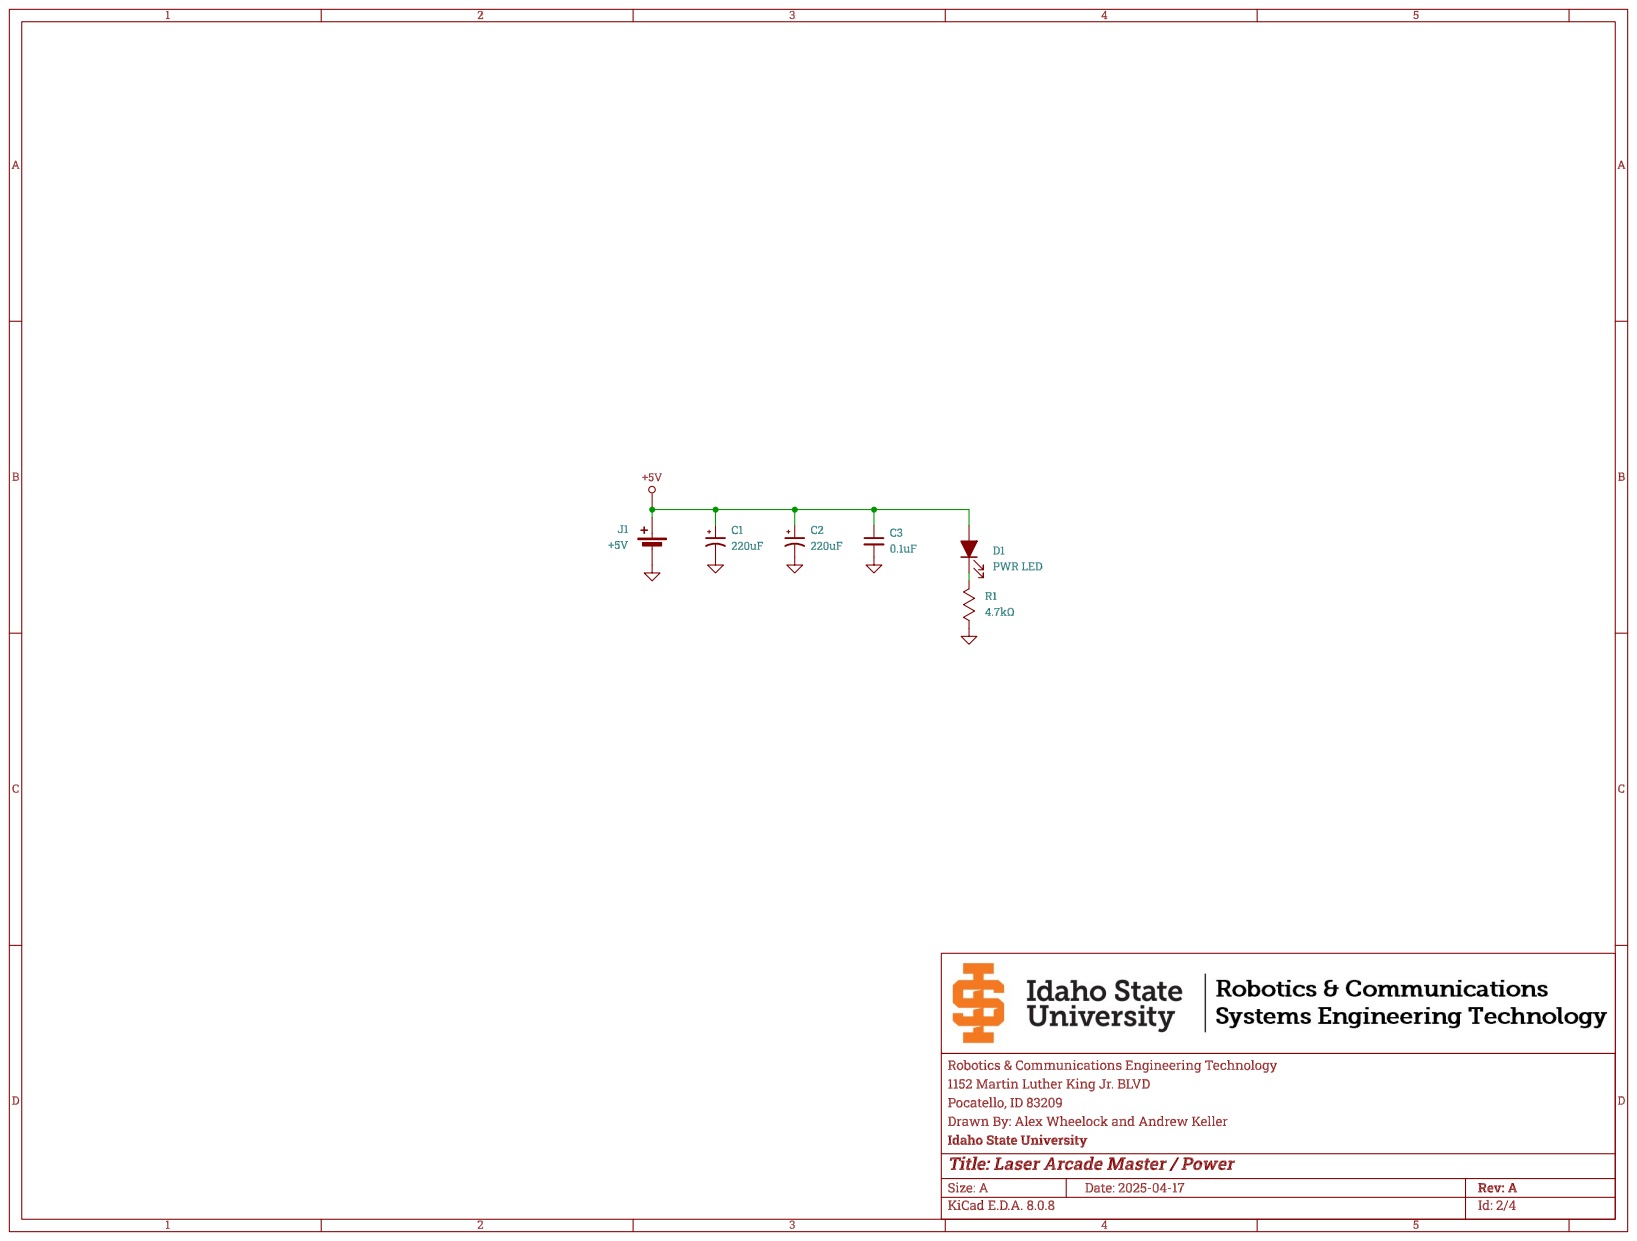
[picture p17: page 2]

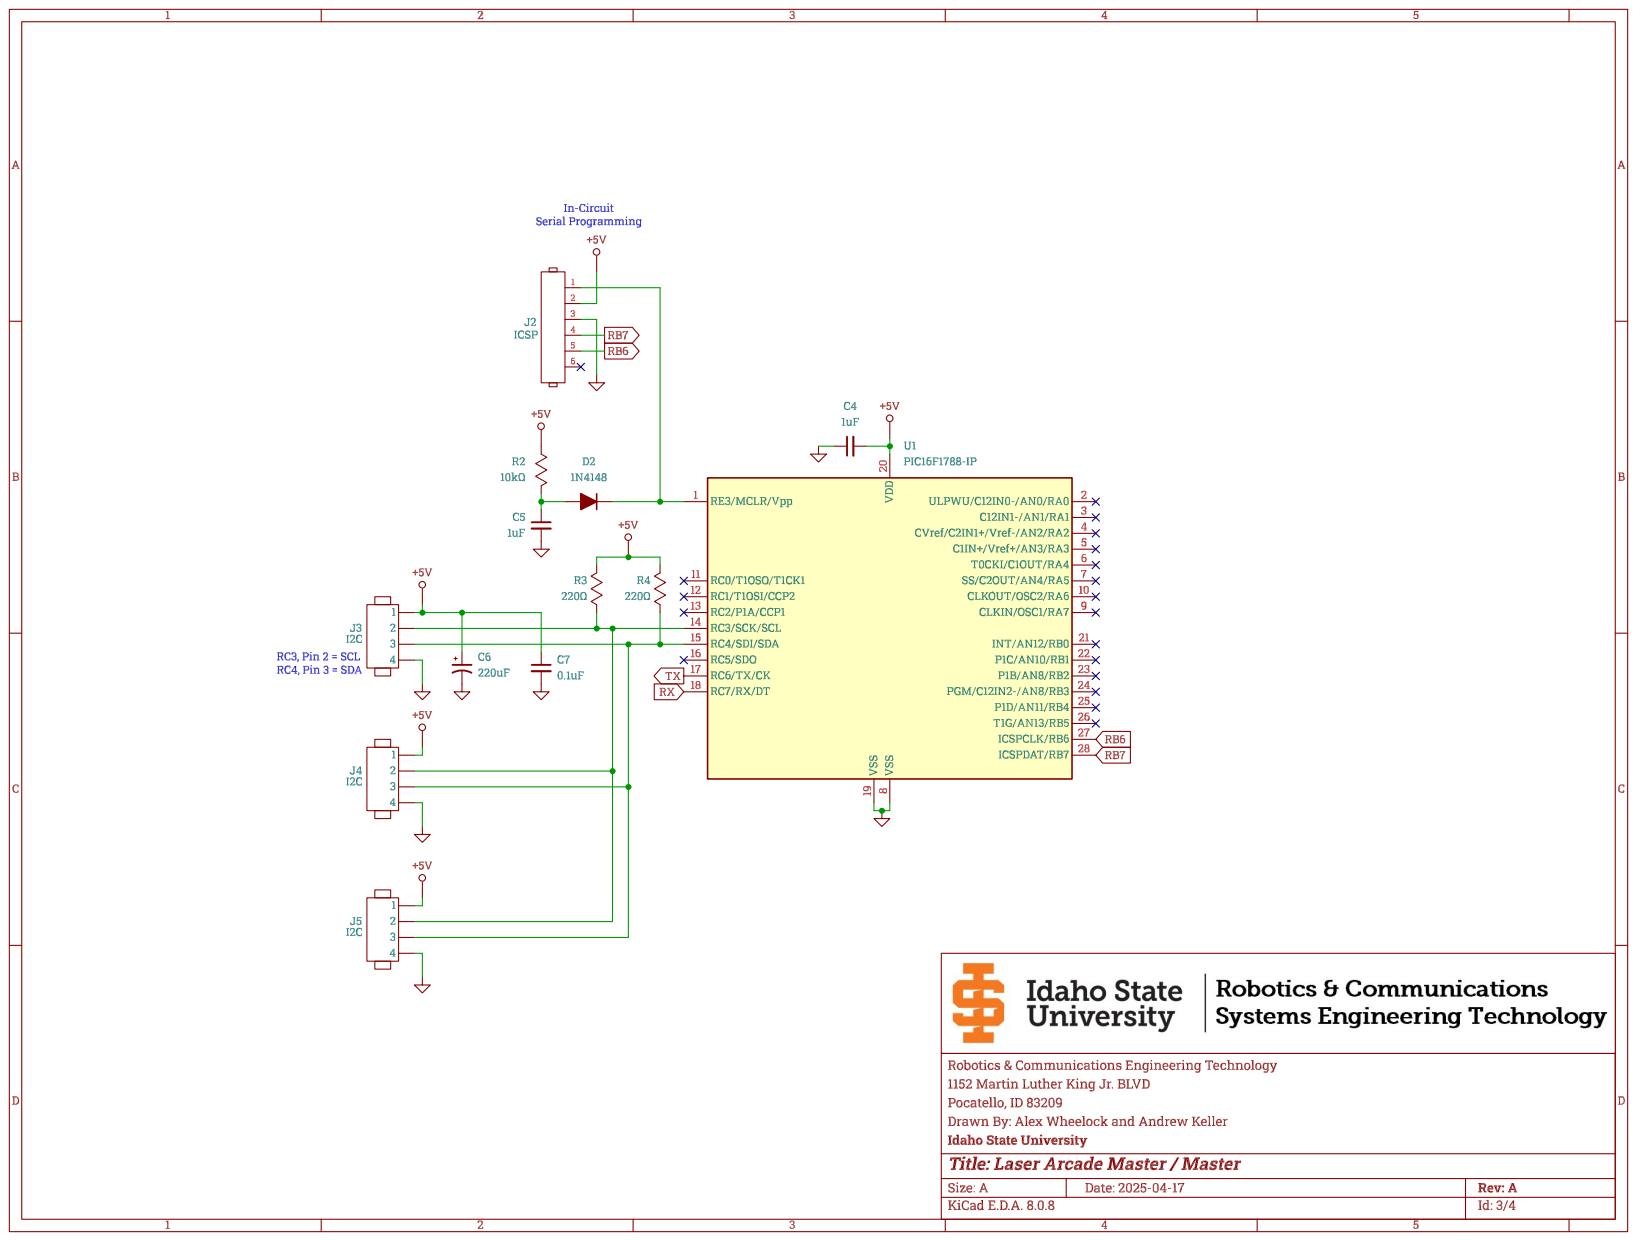
[picture p18: page 3]

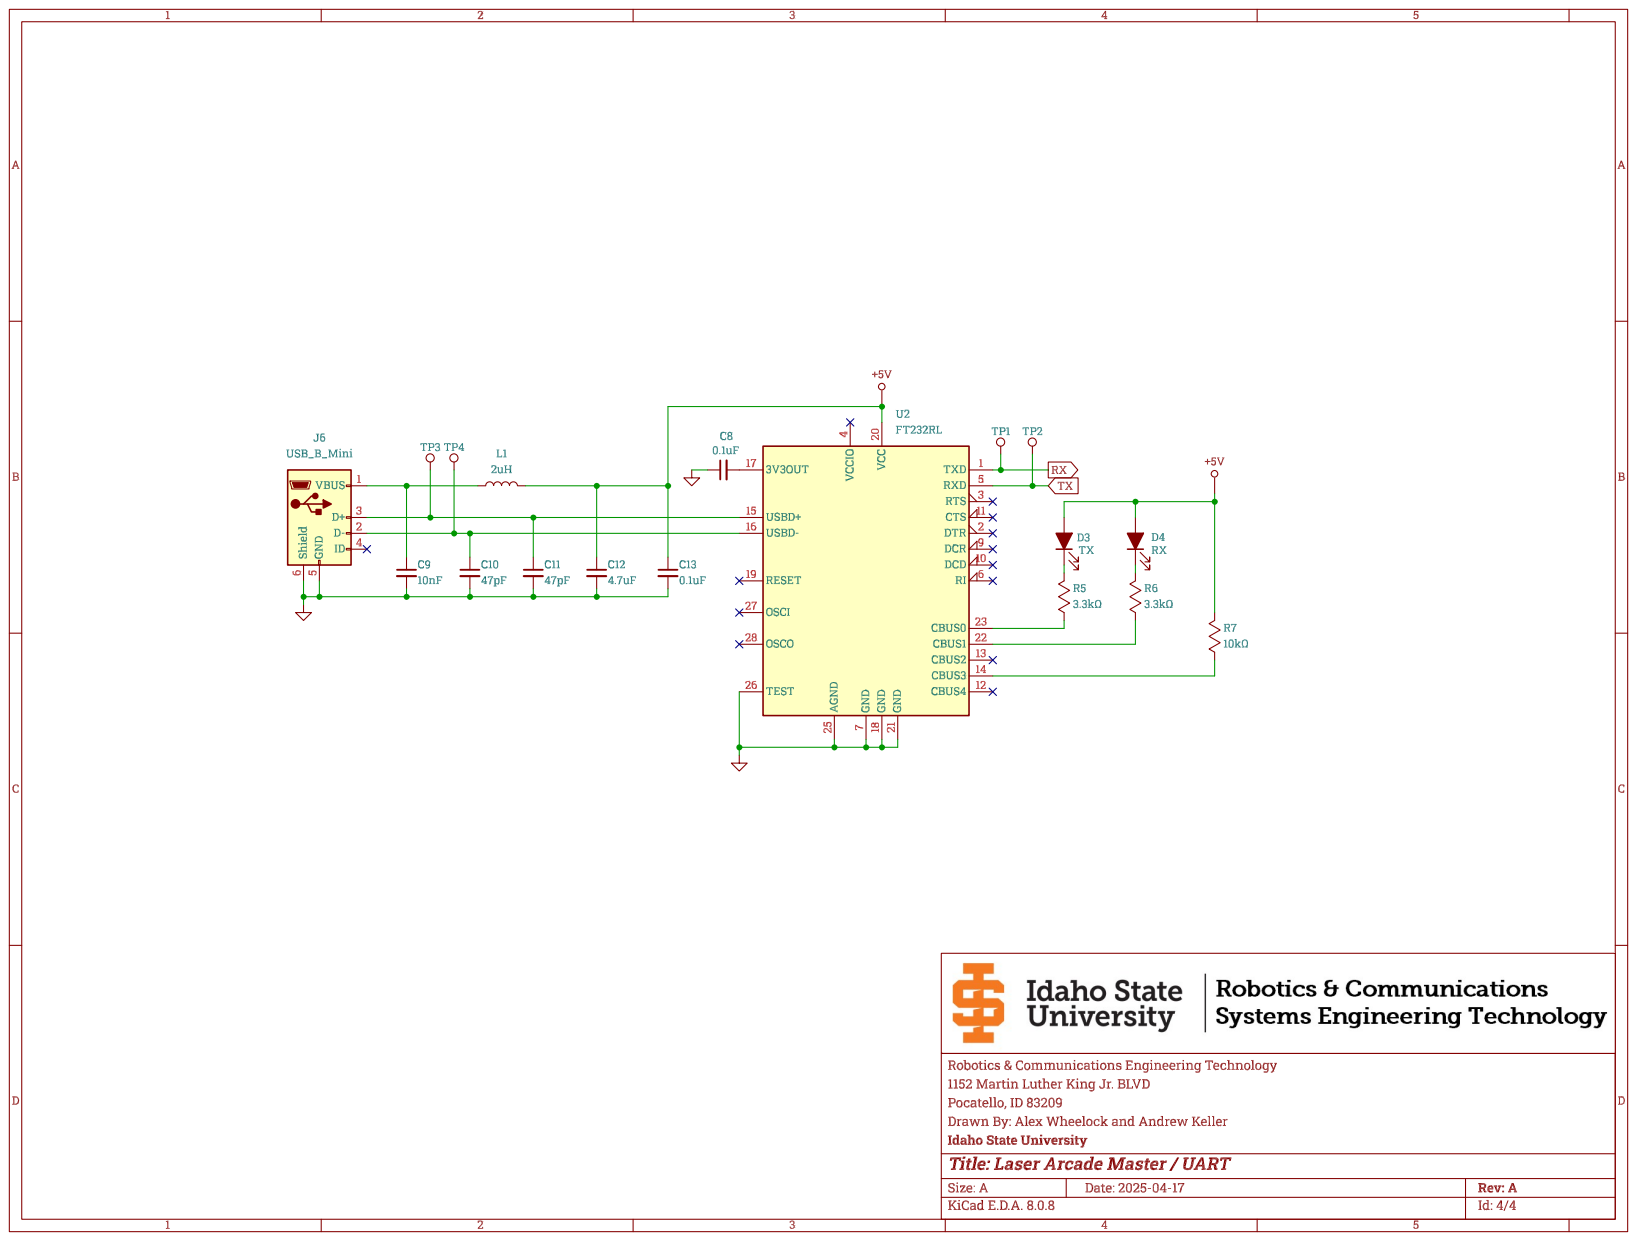
[picture p19: page 4]
