andrew1593571/RCETLaserArcade/KiCad/Target_Slave/Target_Slave_RevB/LA_TargetSlave_RevB_Schematic.pdf

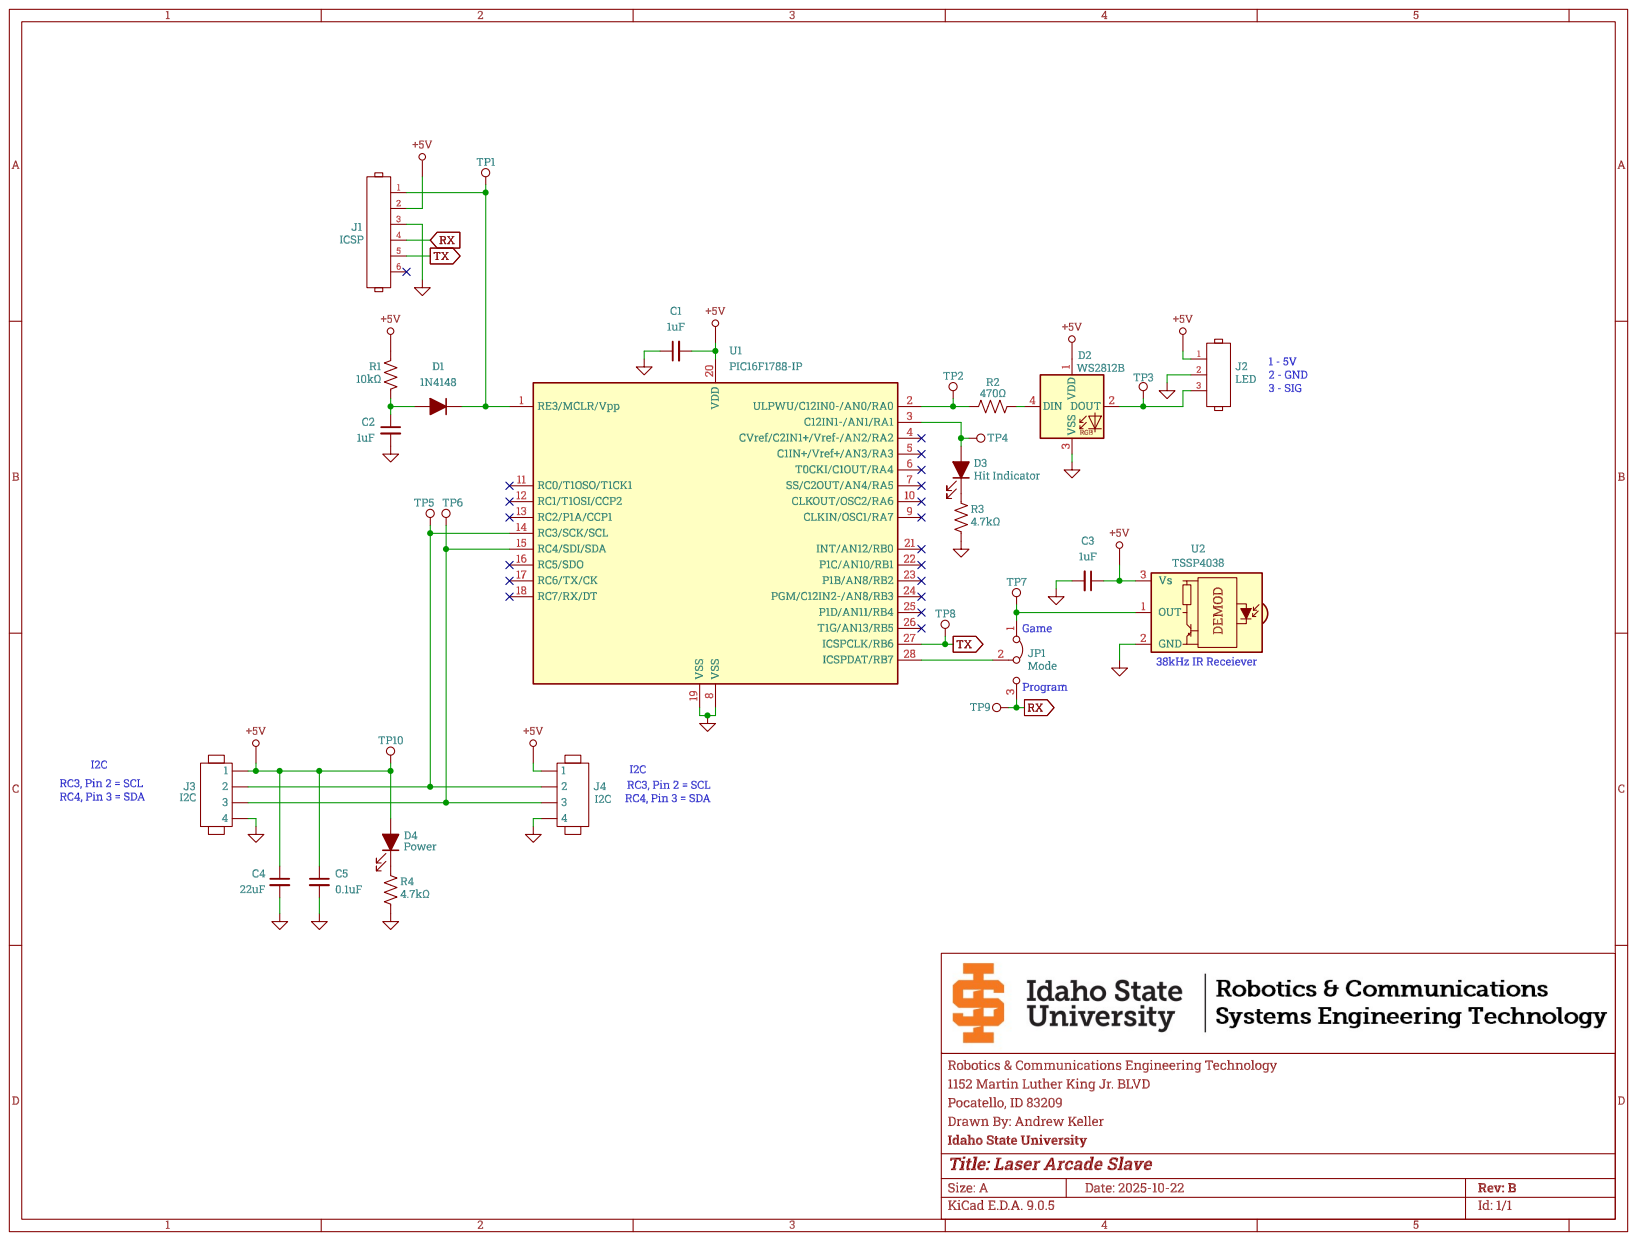
[picture p20: page 1]
