andrew1593571/RCETLaserArcade/KiCad/Blaster/LA_Blaster_RevA/Blaster PCB Mechanical.pdf

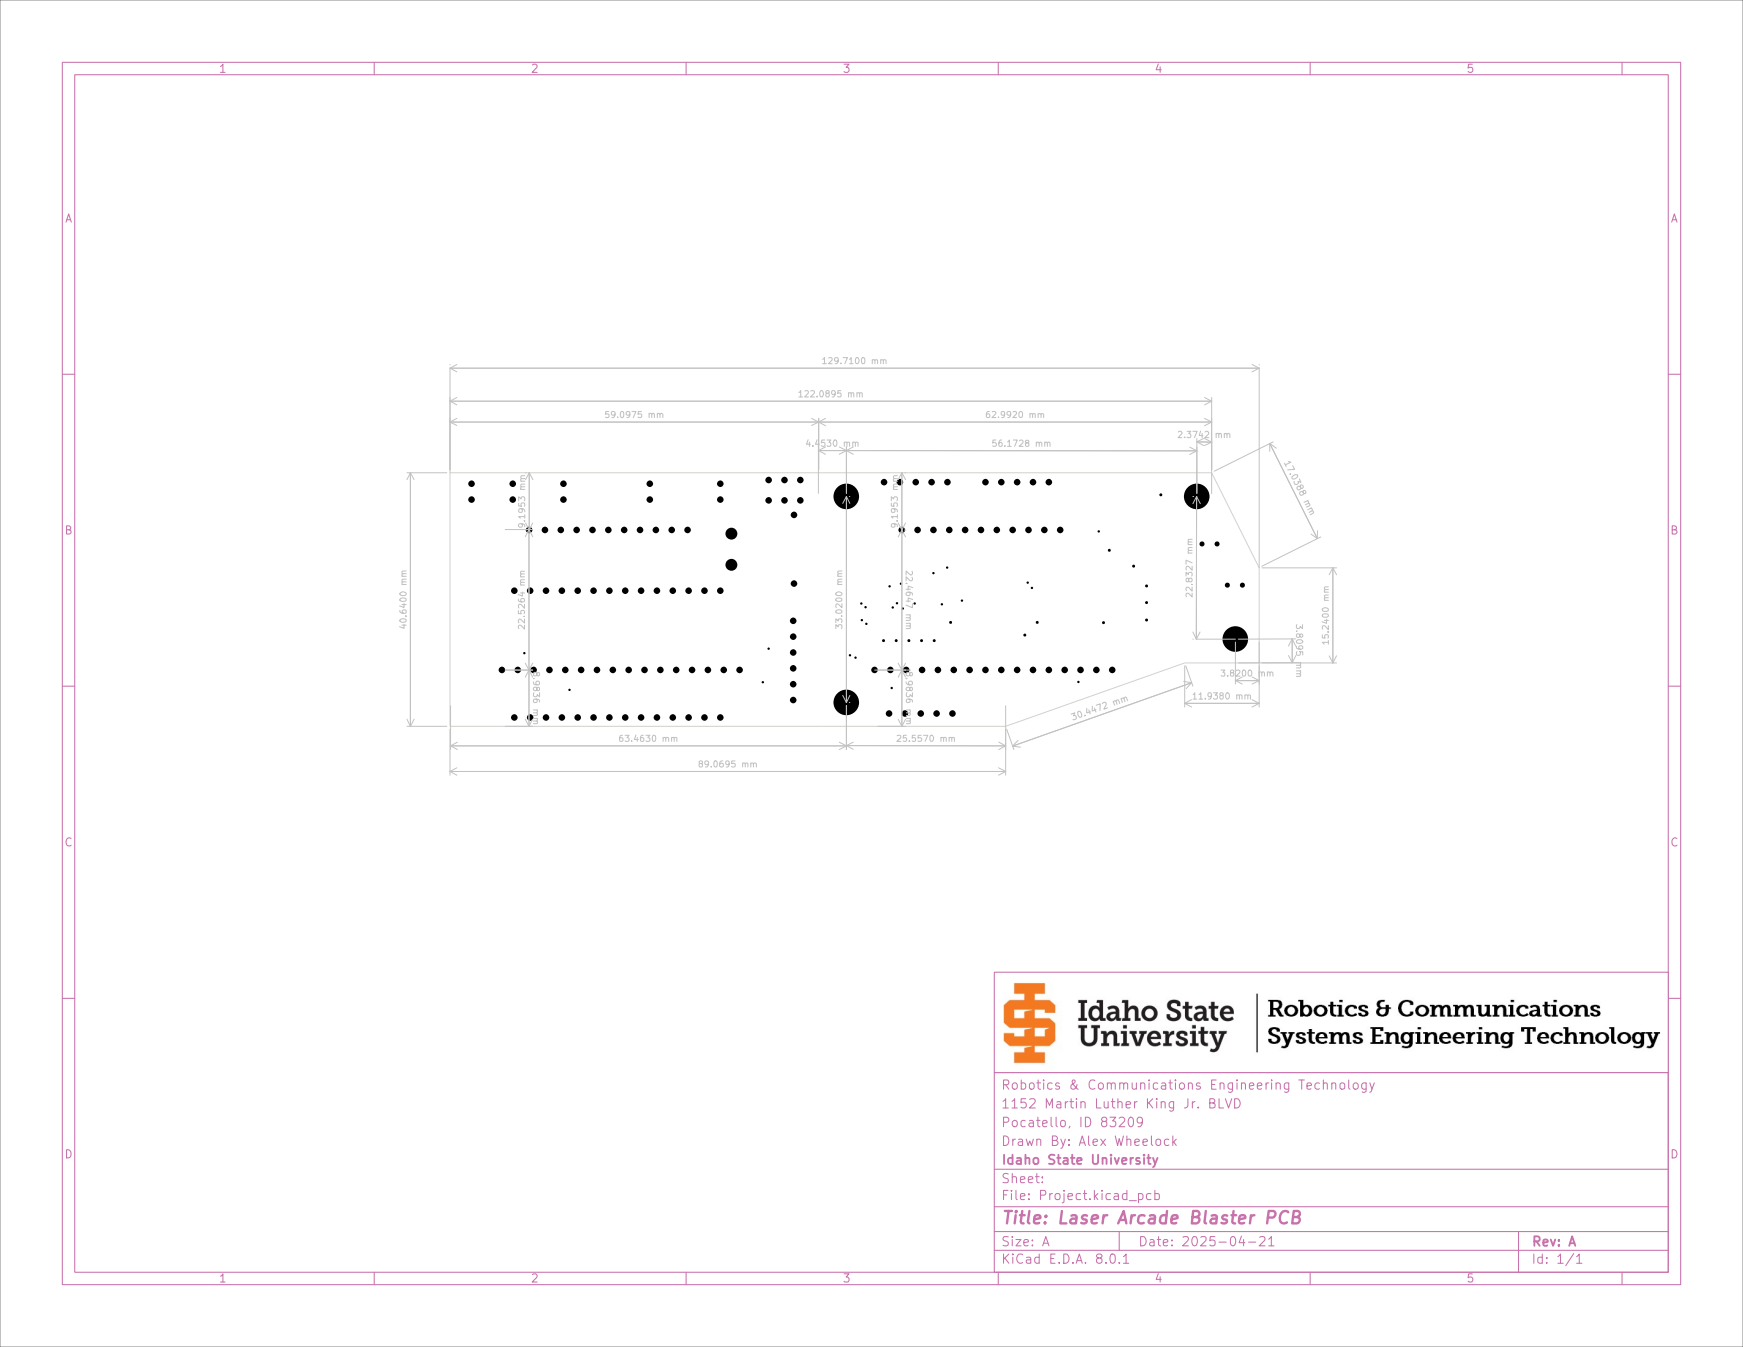
[picture p21: page 1]
