andrew1593571/RCETLaserArcade/KiCad/Blaster/LA_Blaster_RevA/Blaster Schematic.pdf

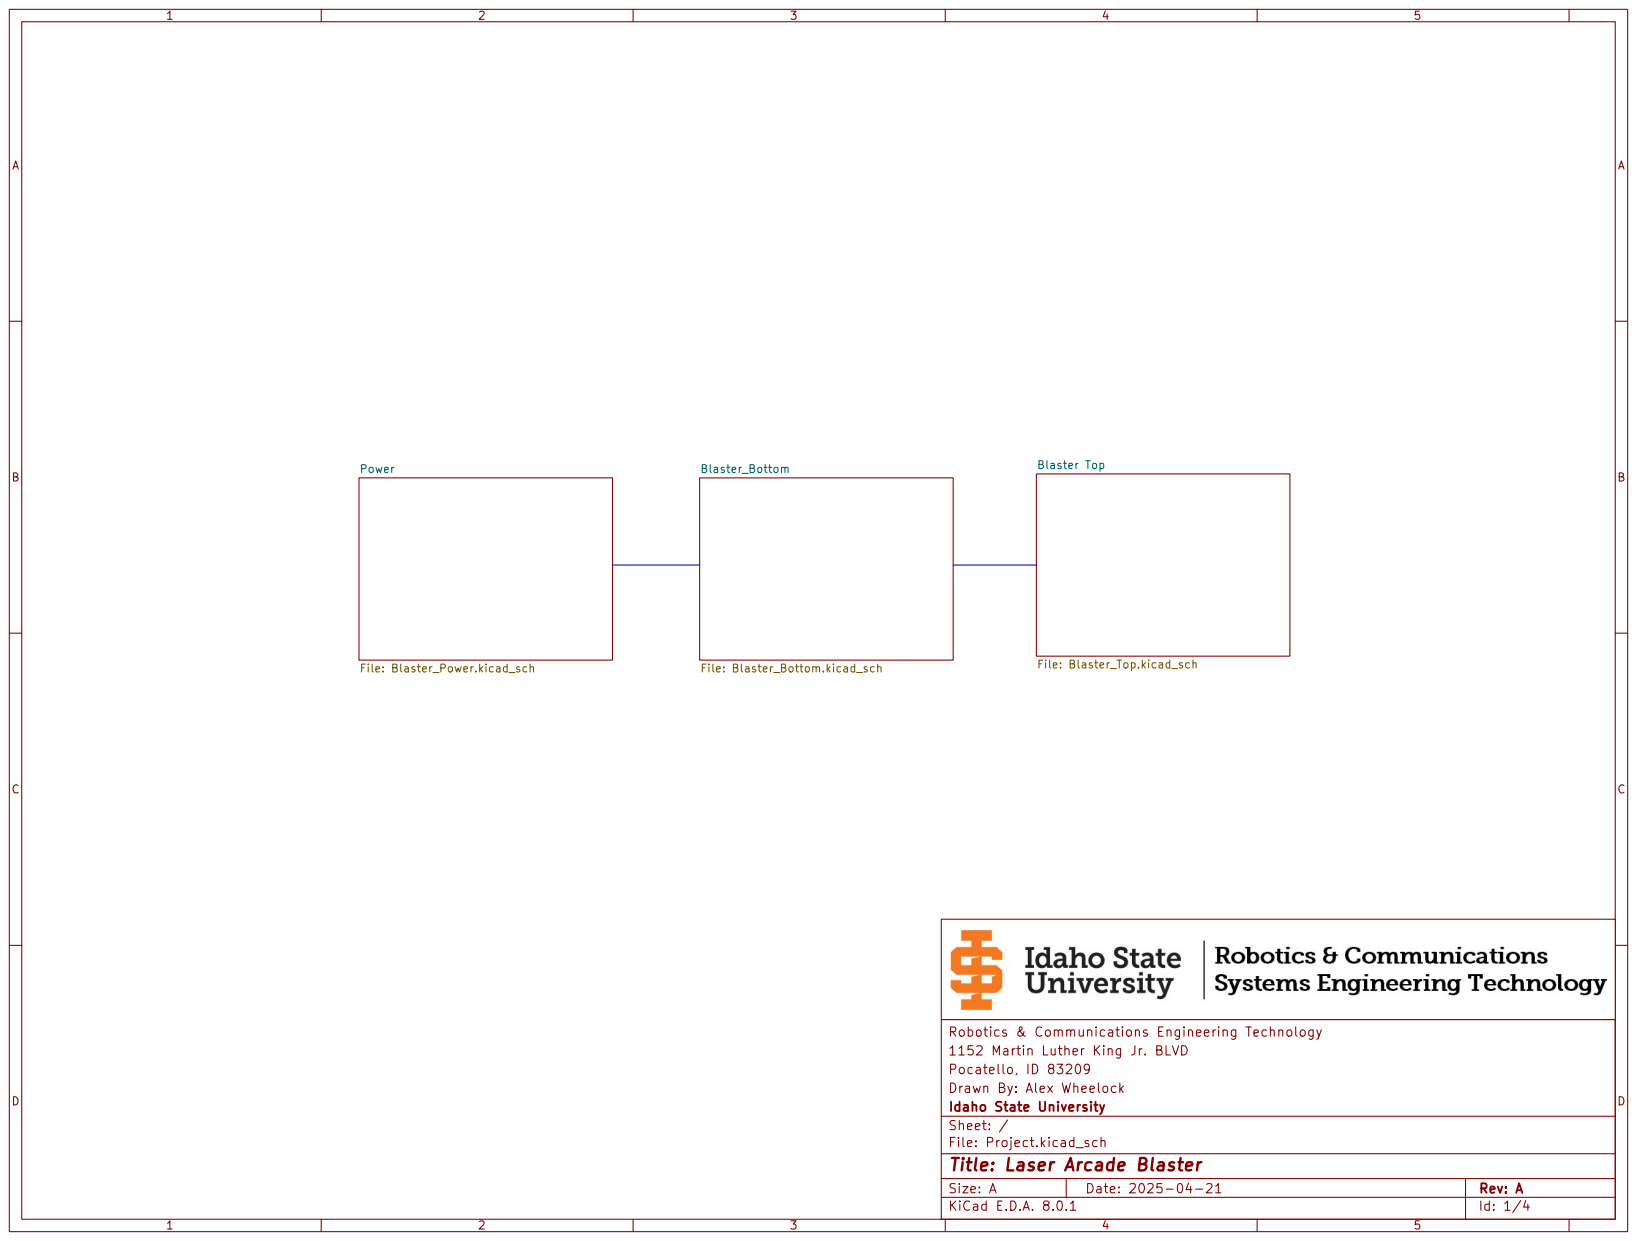
[picture p22: page 1]

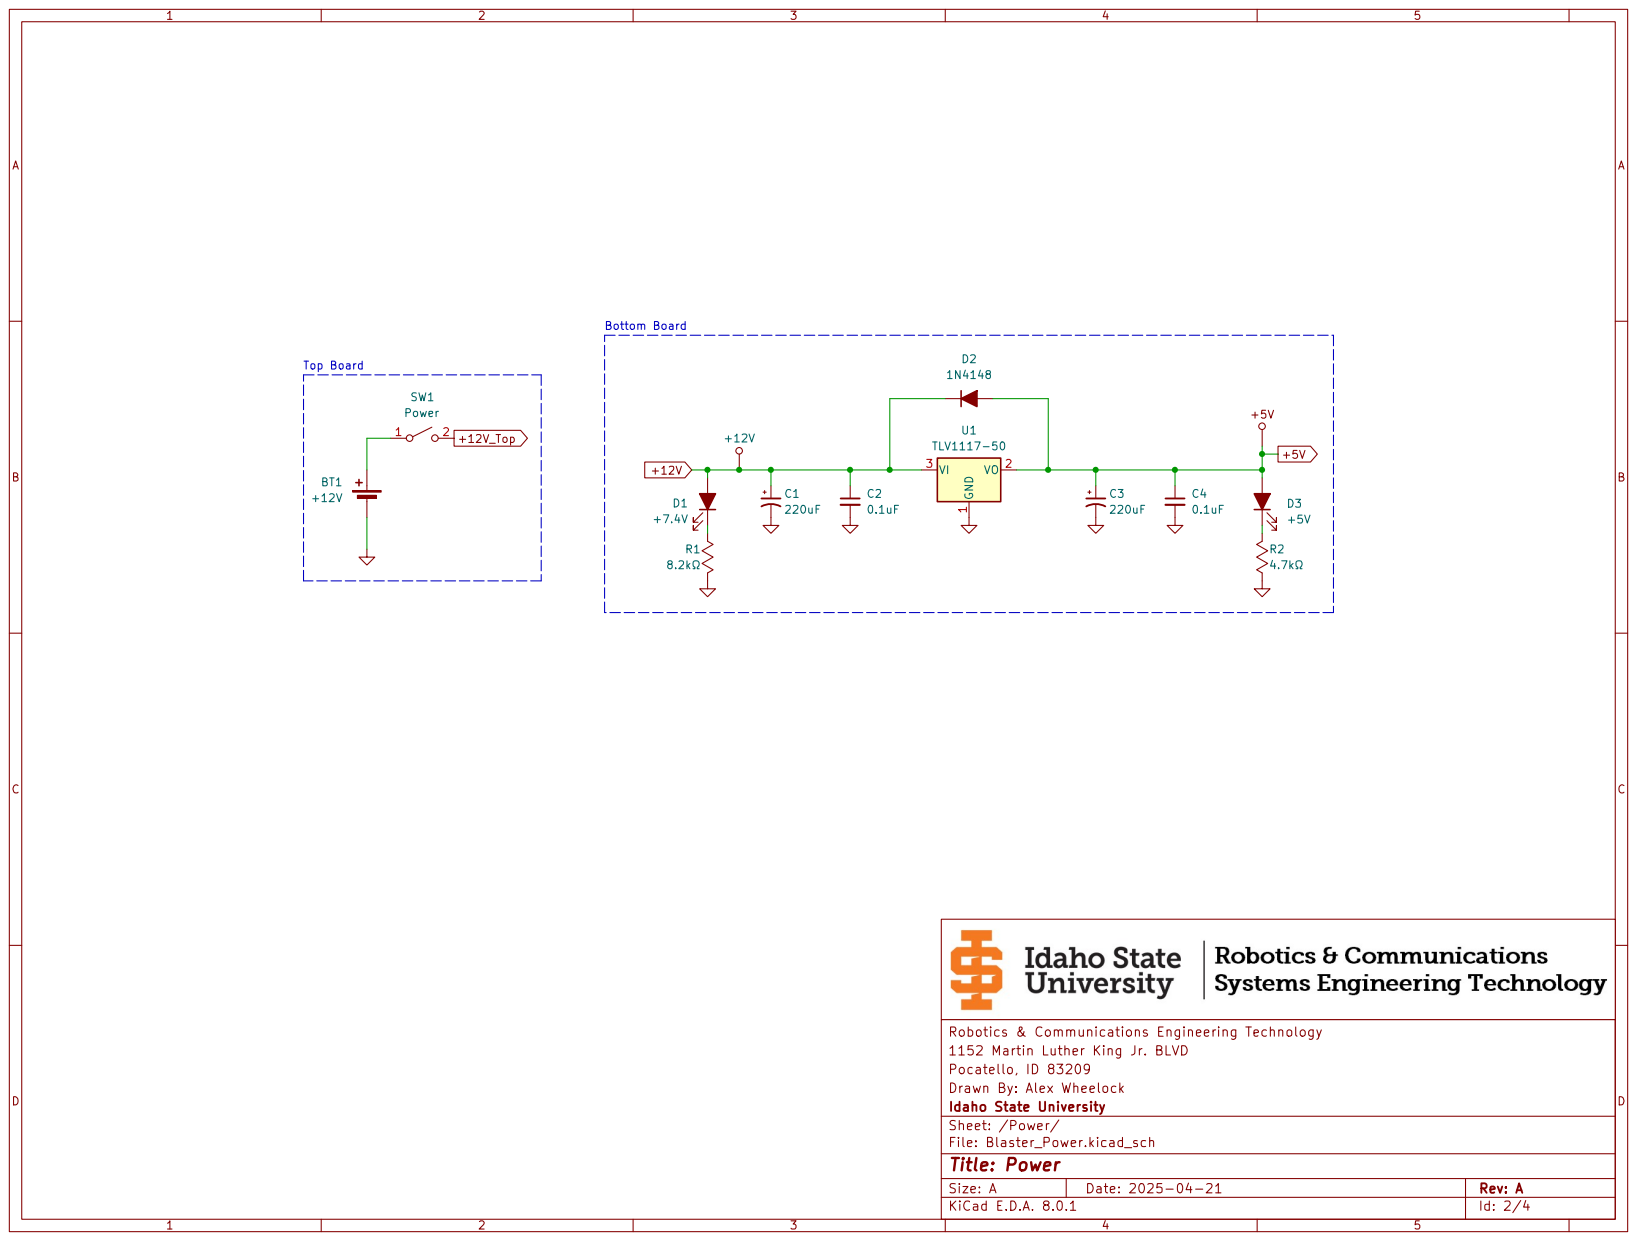
[picture p23: page 2]

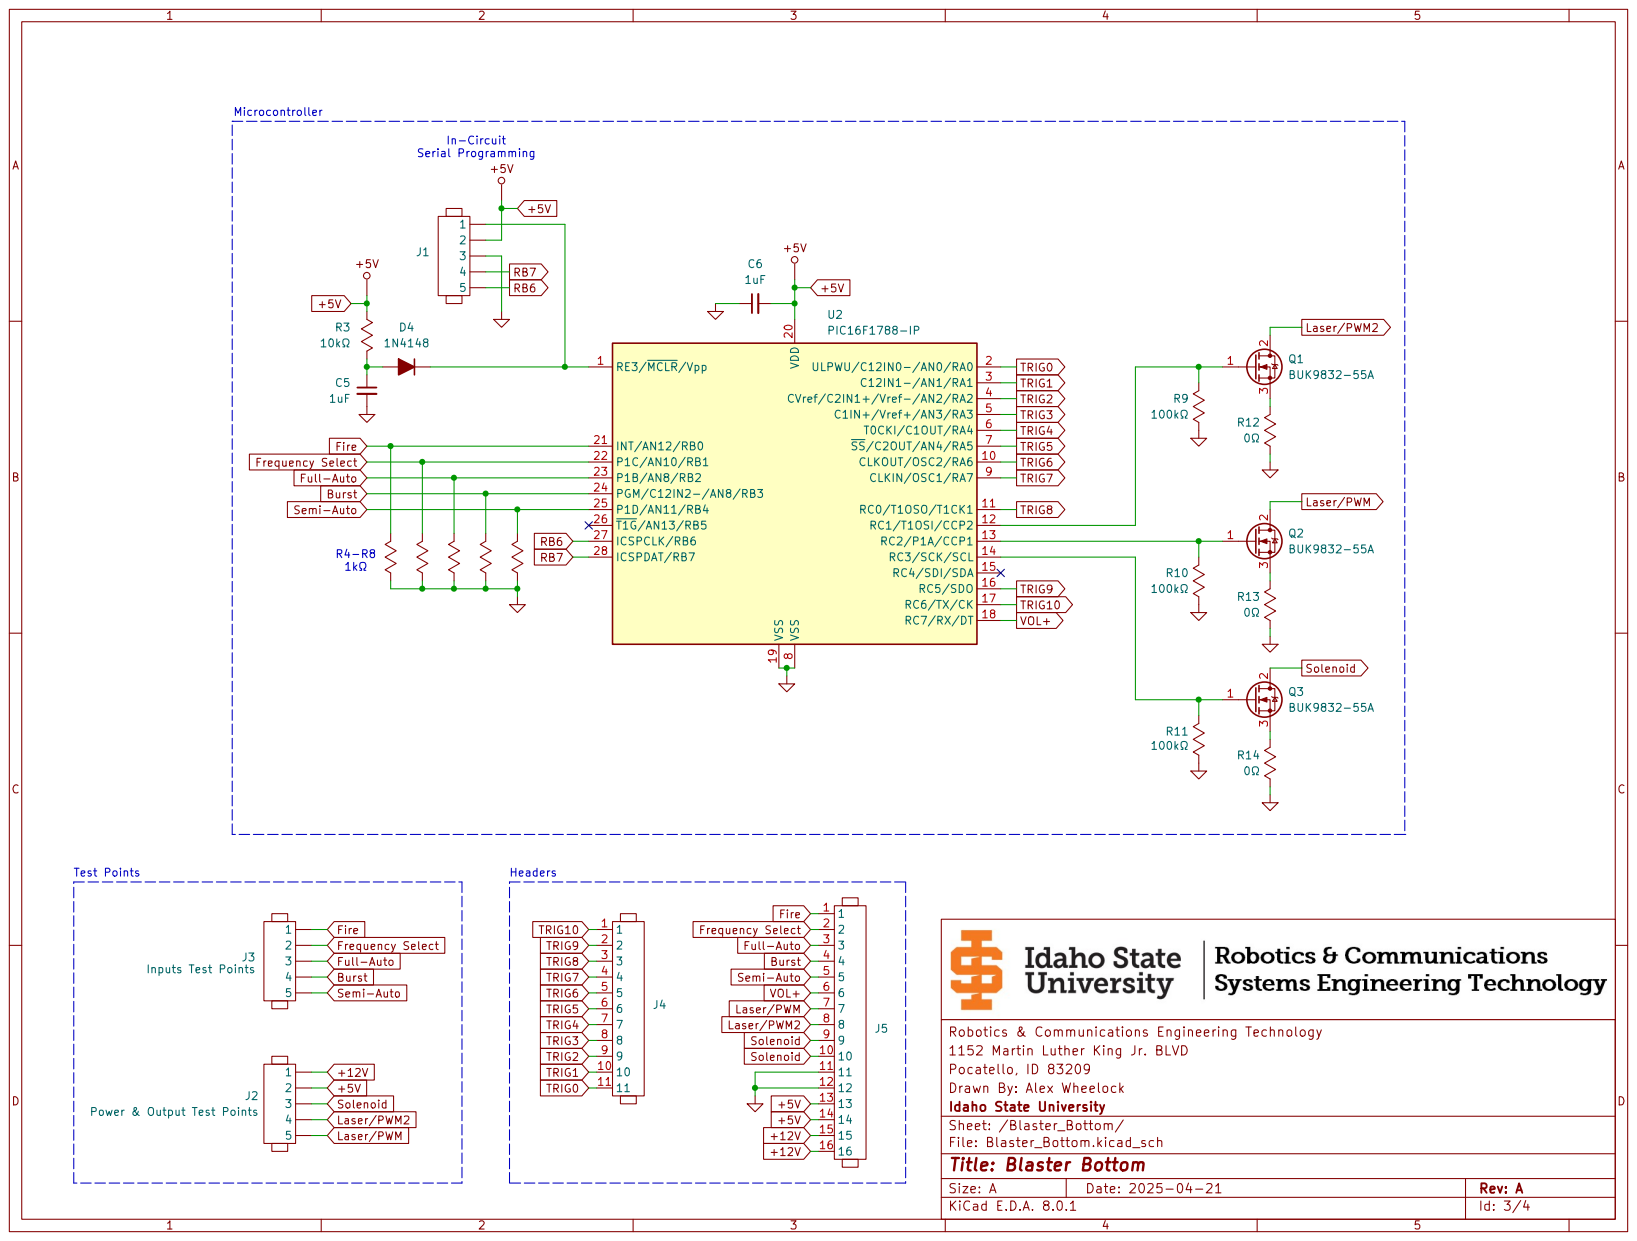
[picture p24: page 3]

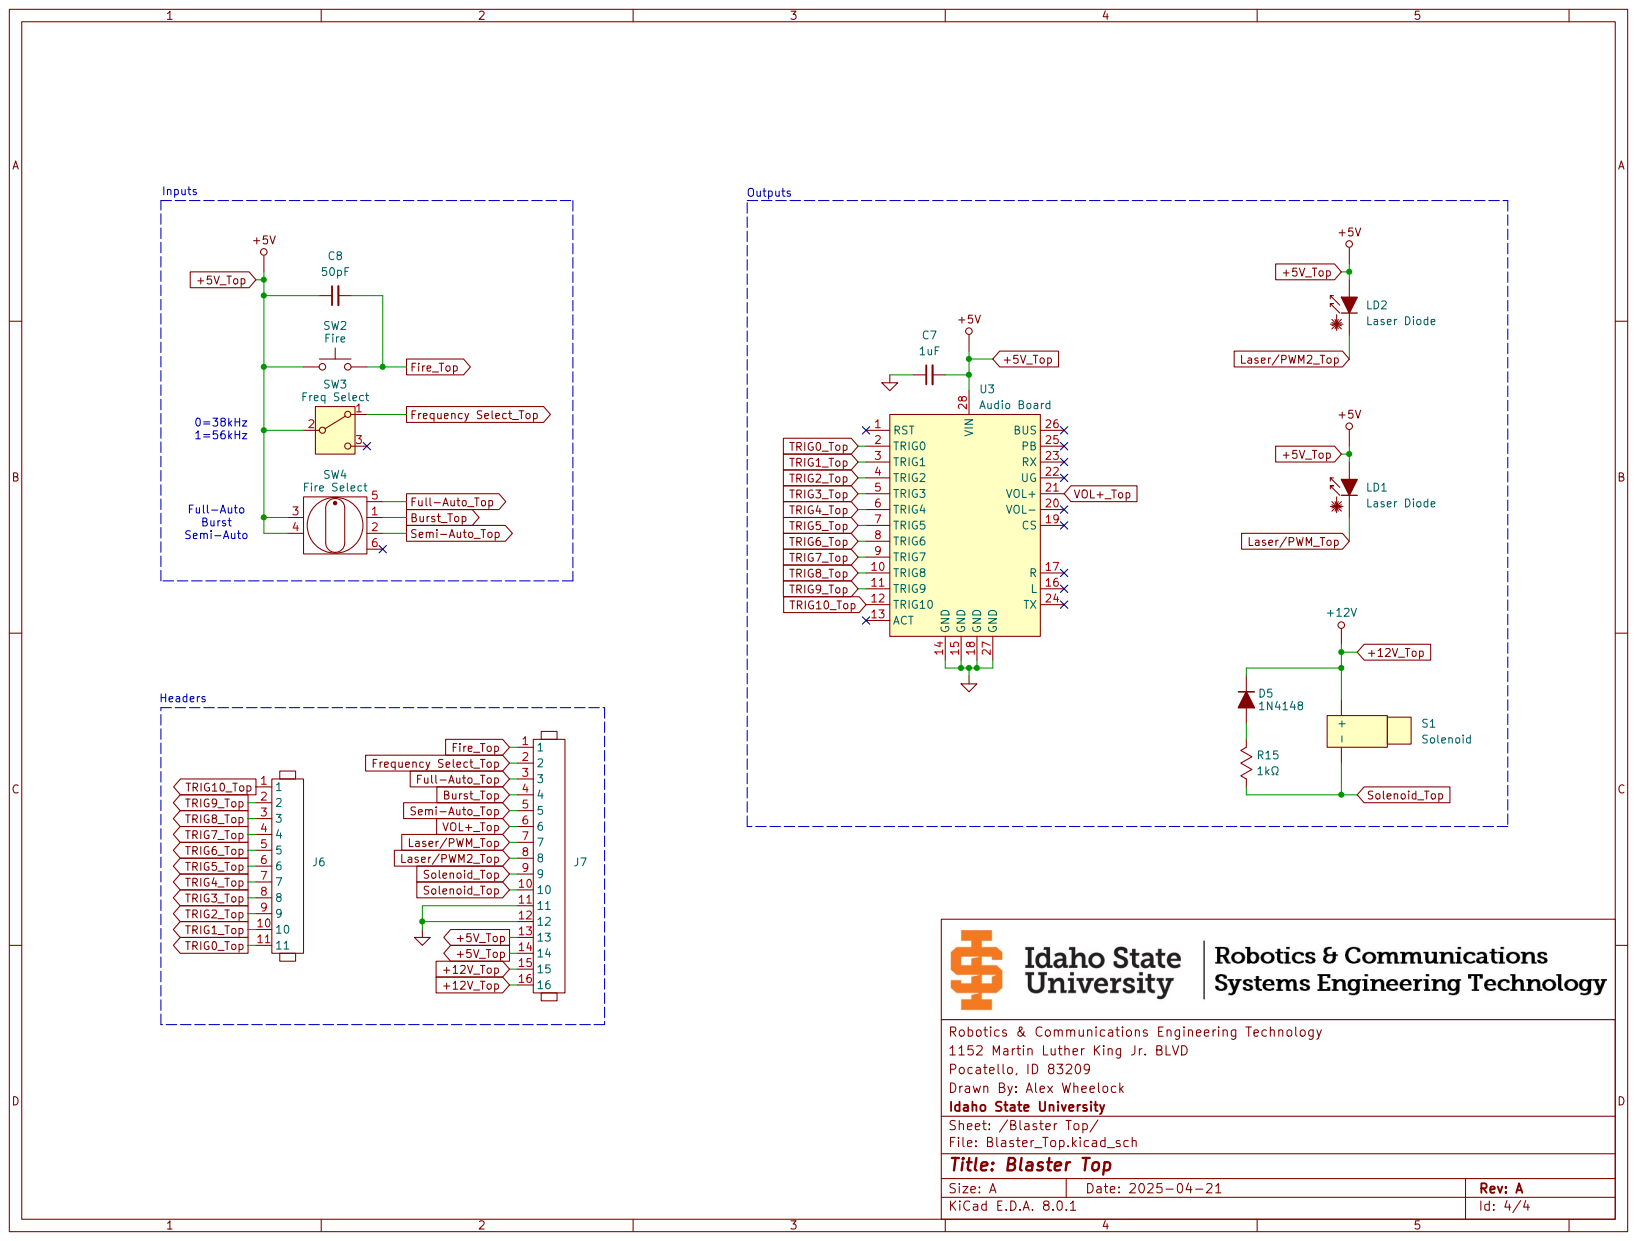
[picture p25: page 4]
