andrew1593571/RCETLaserArcade/KiCad/Target_Master/LA_Master Back Copper.pdf

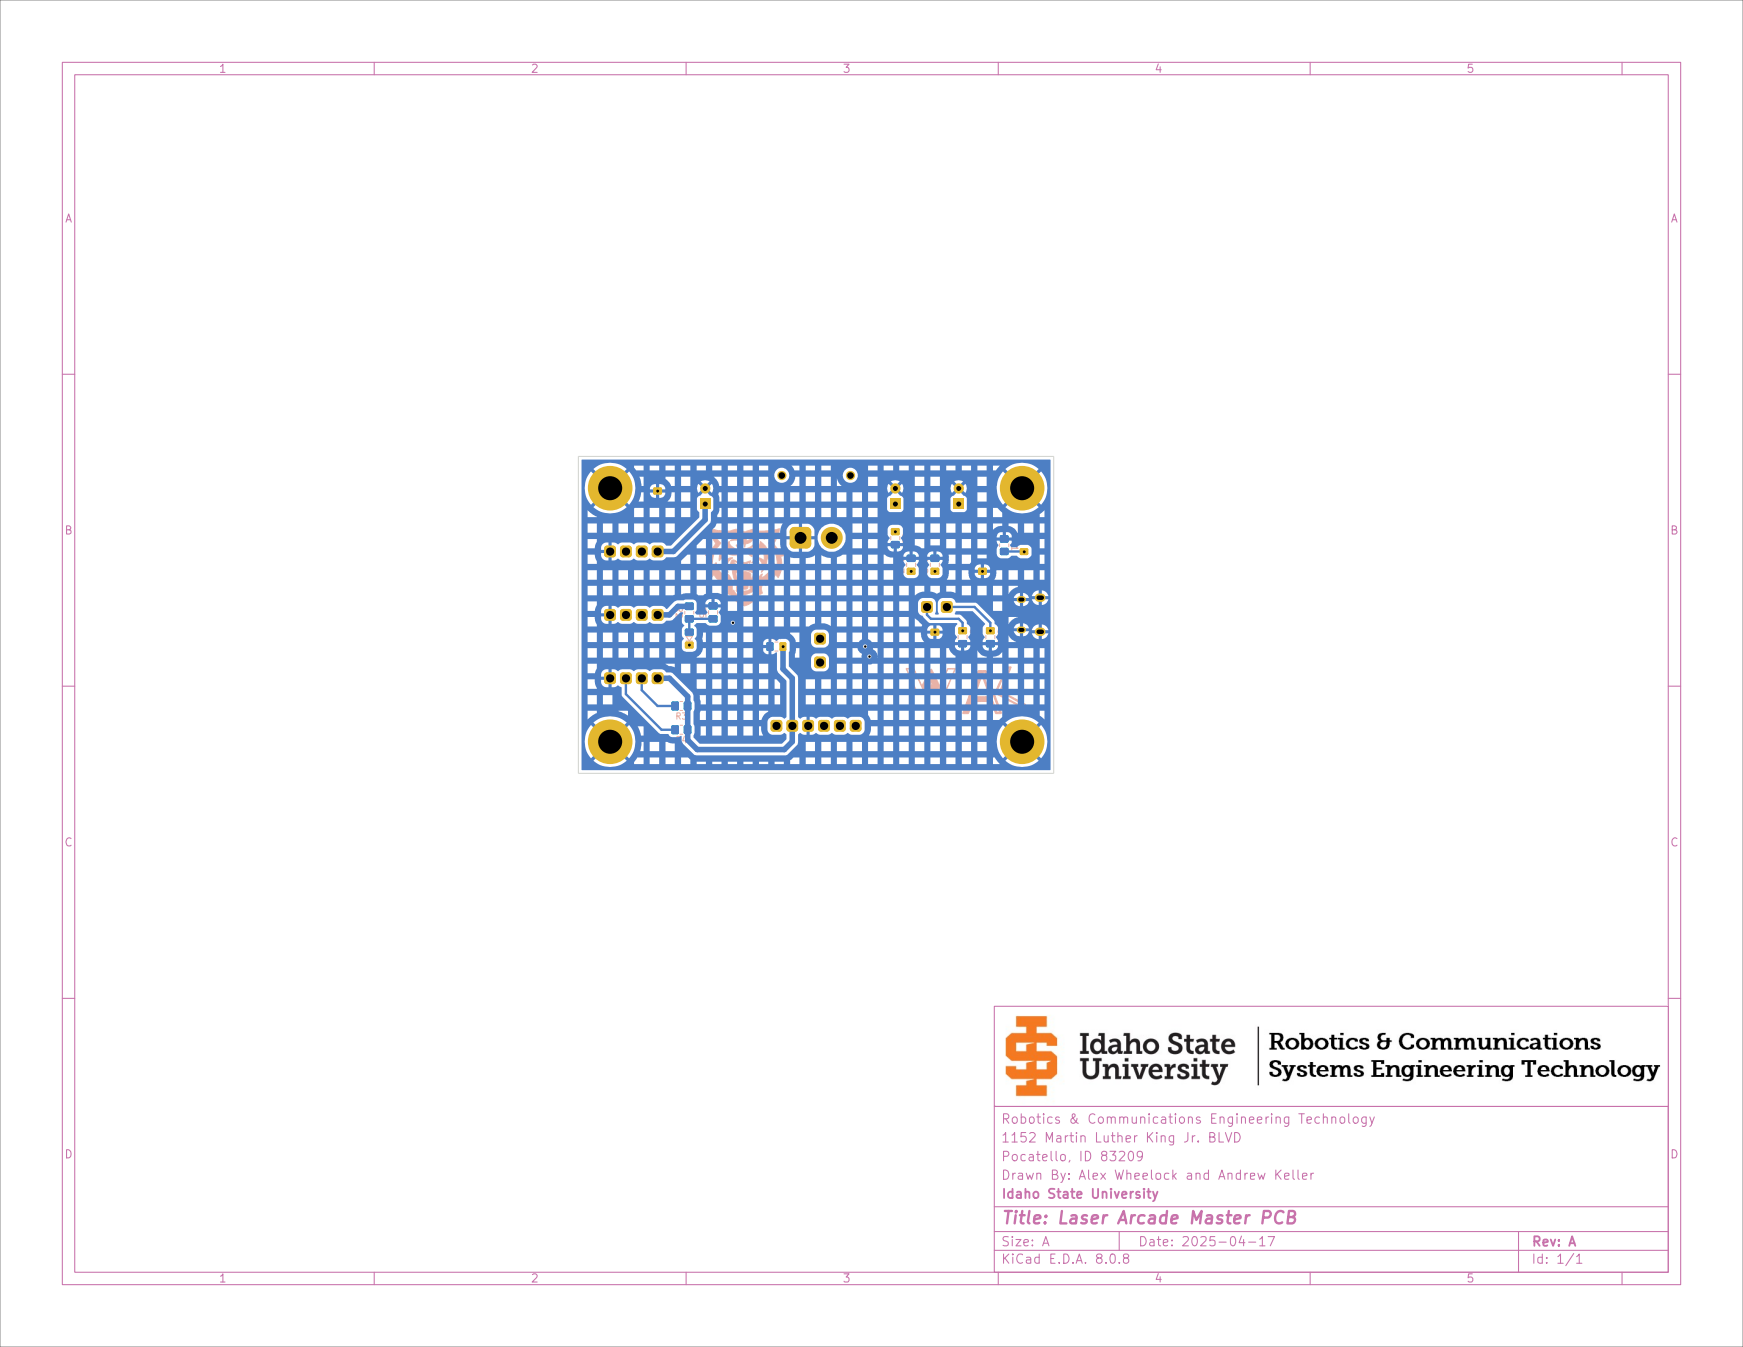
[picture p26: page 1]
