andrew1593571/RCETLaserArcade/KiCad/Target_Master/LA_Master Front Copper.pdf

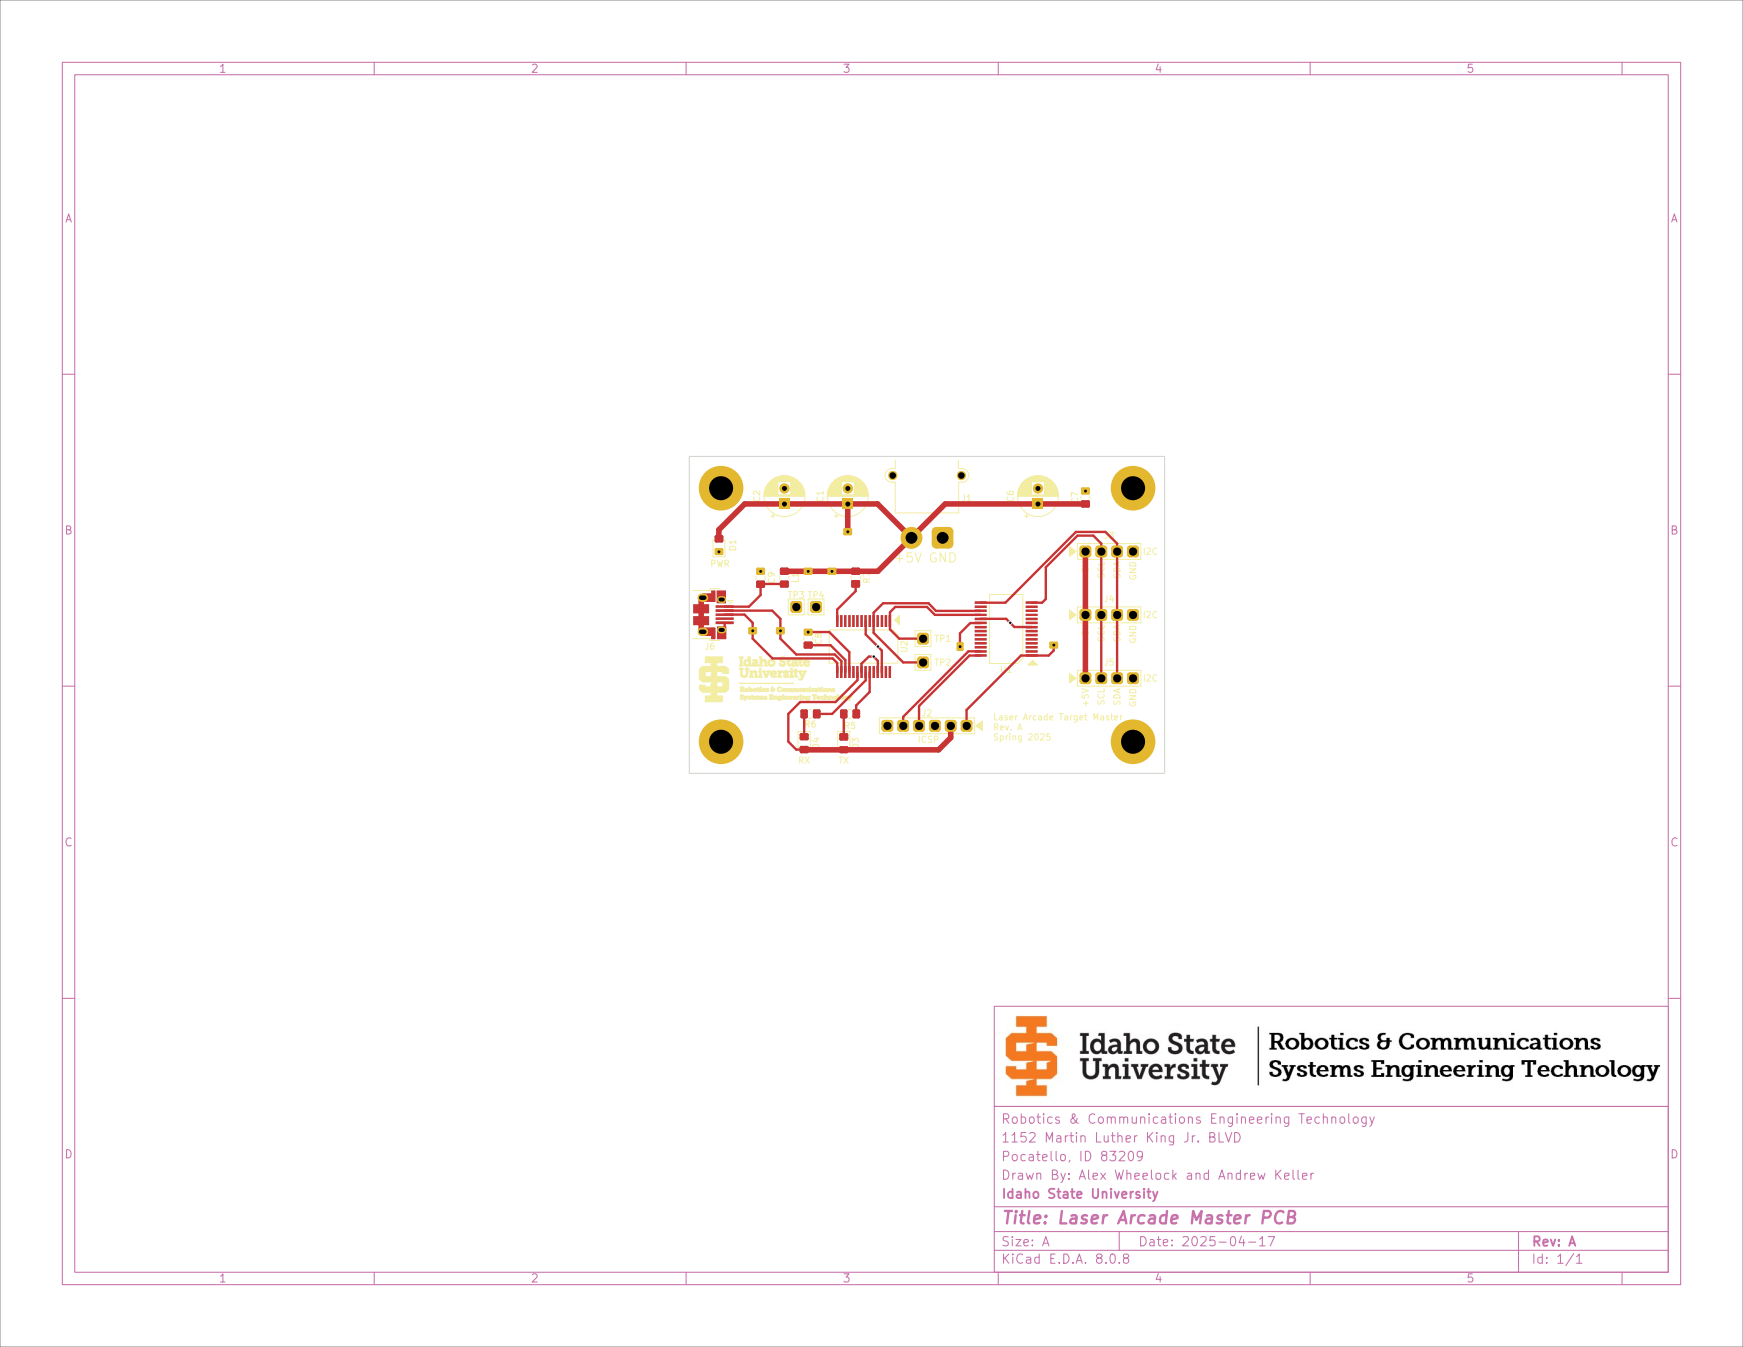
[picture p27: page 1]
