andrew1593571/RCETLaserArcade/KiCad/Target_Master/LA_Master Front Fab.pdf

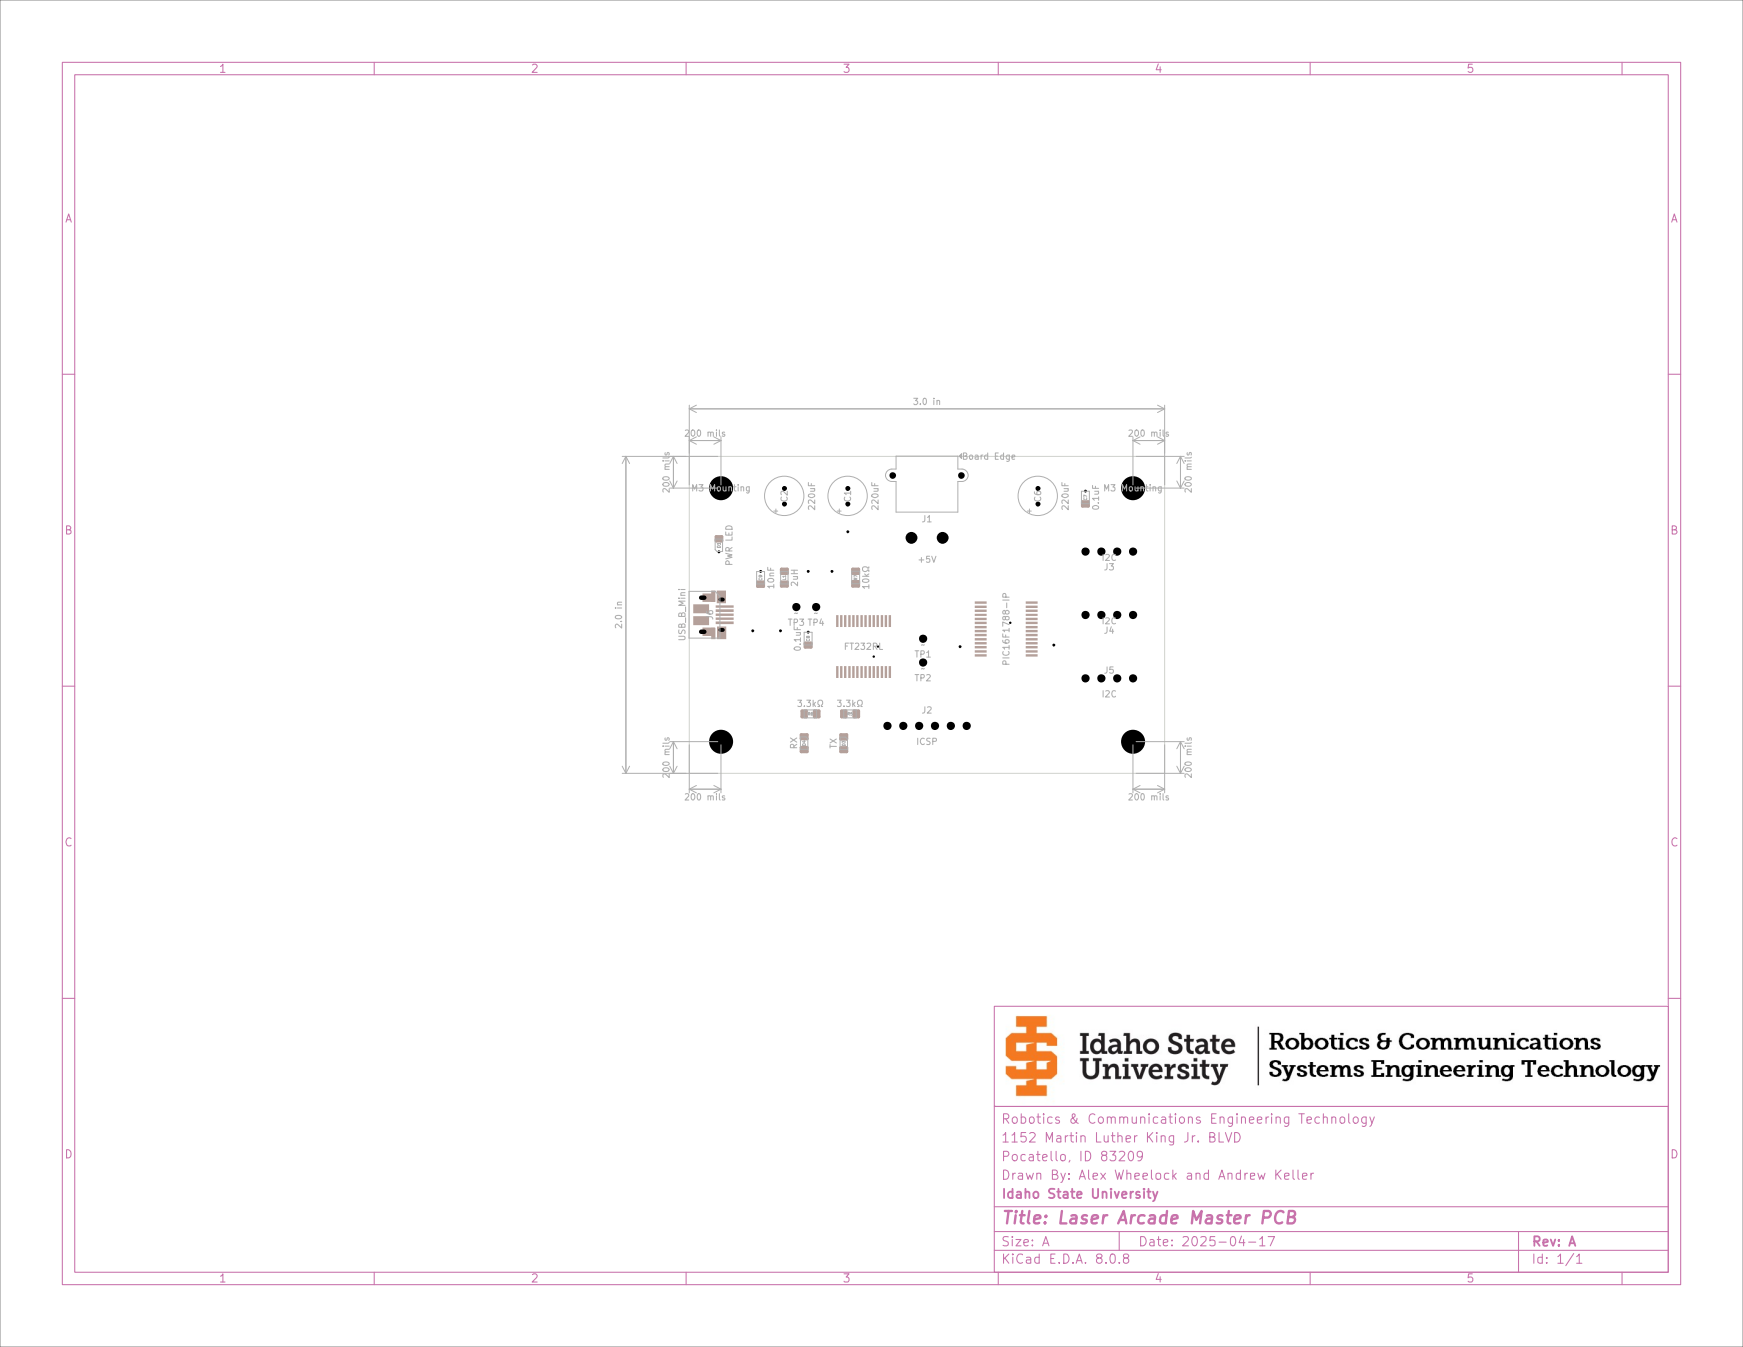
[picture p28: page 1]
