andrew1593571/RCETLaserArcade/Documentation/Fall_2024/Laser Game Feedback_4291a62e84d75e331da8b0adfc51032e.pdf

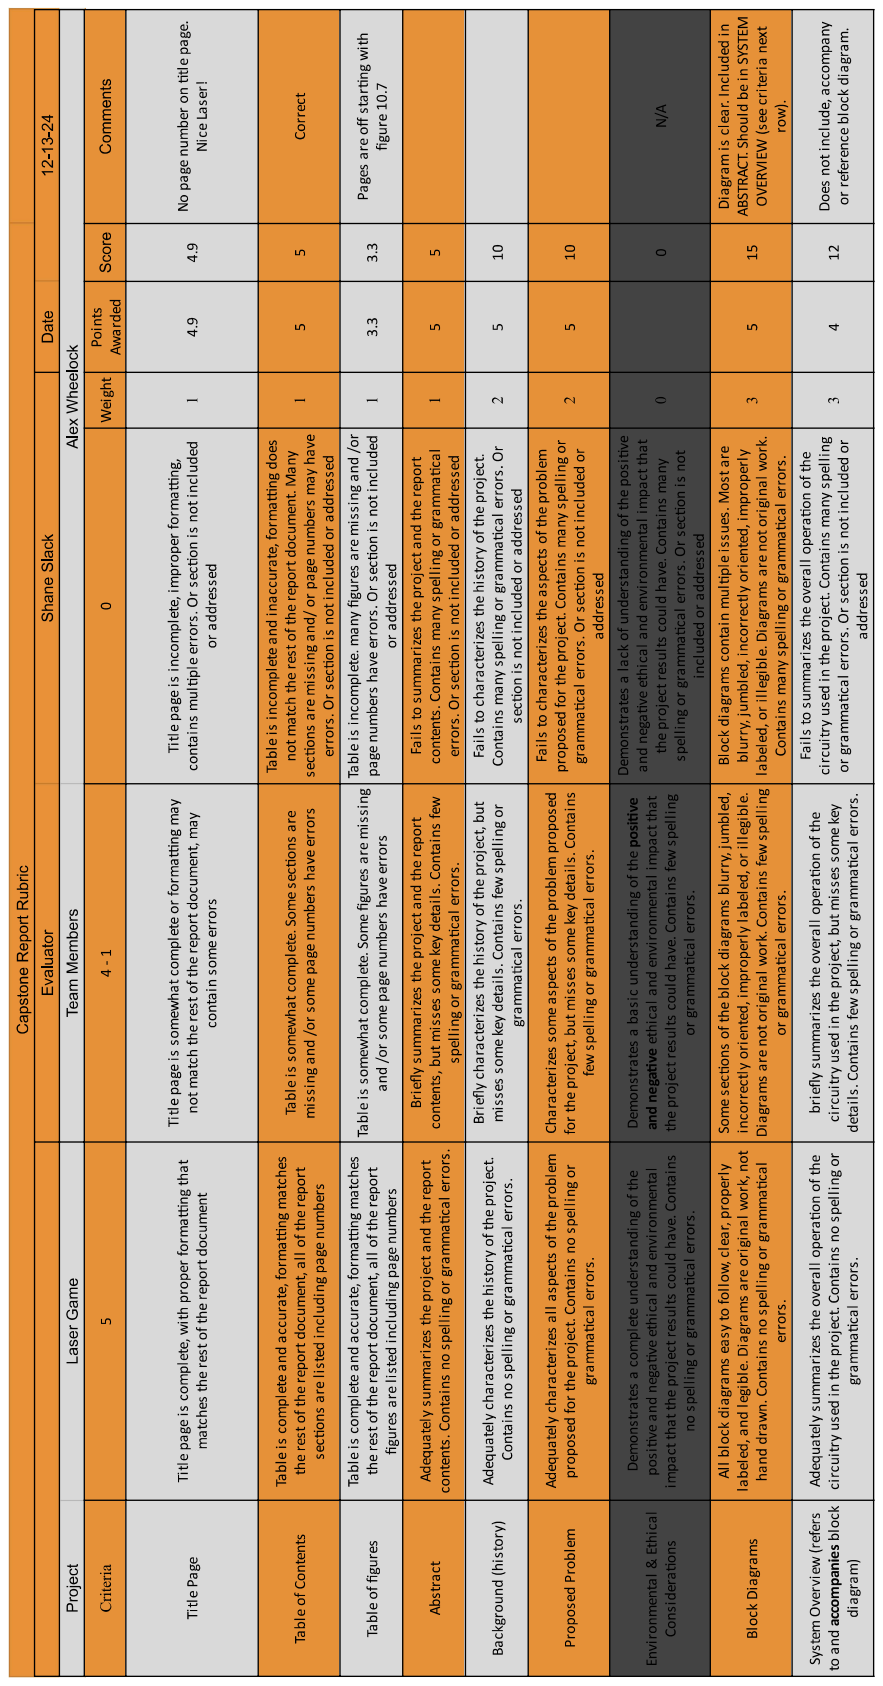
[picture p29: page 1]

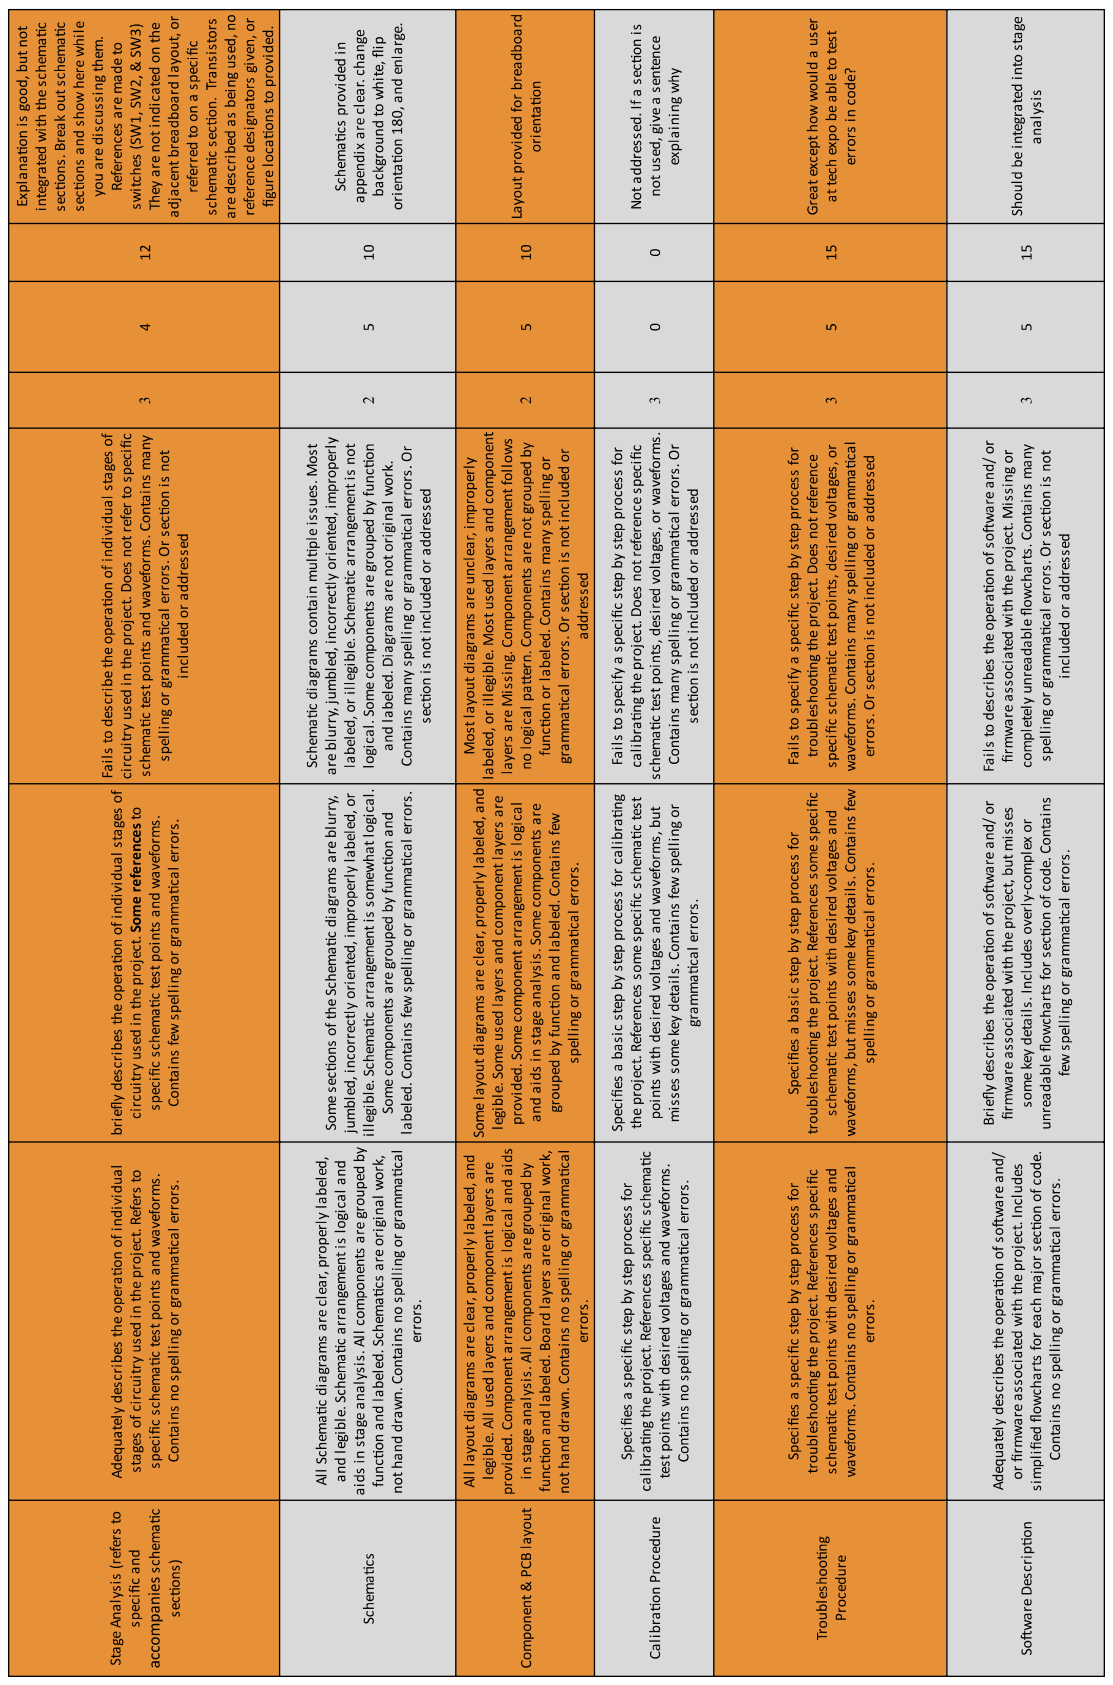
[picture p30: page 2]

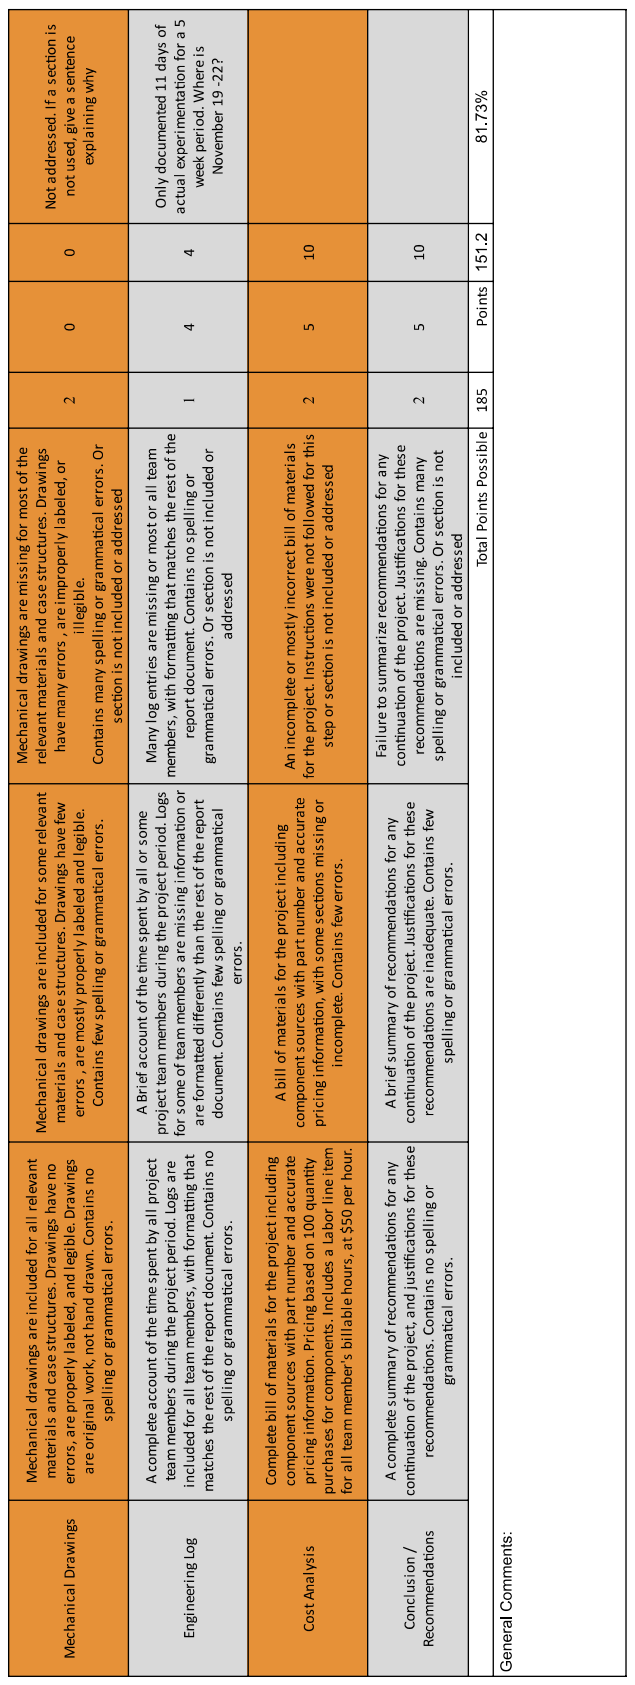
[picture p31: page 3]
