andrew1593571/RCETLaserArcade/KiCad/Blaster/LA_Blaster_RevA/Blaster PCB Back.pdf

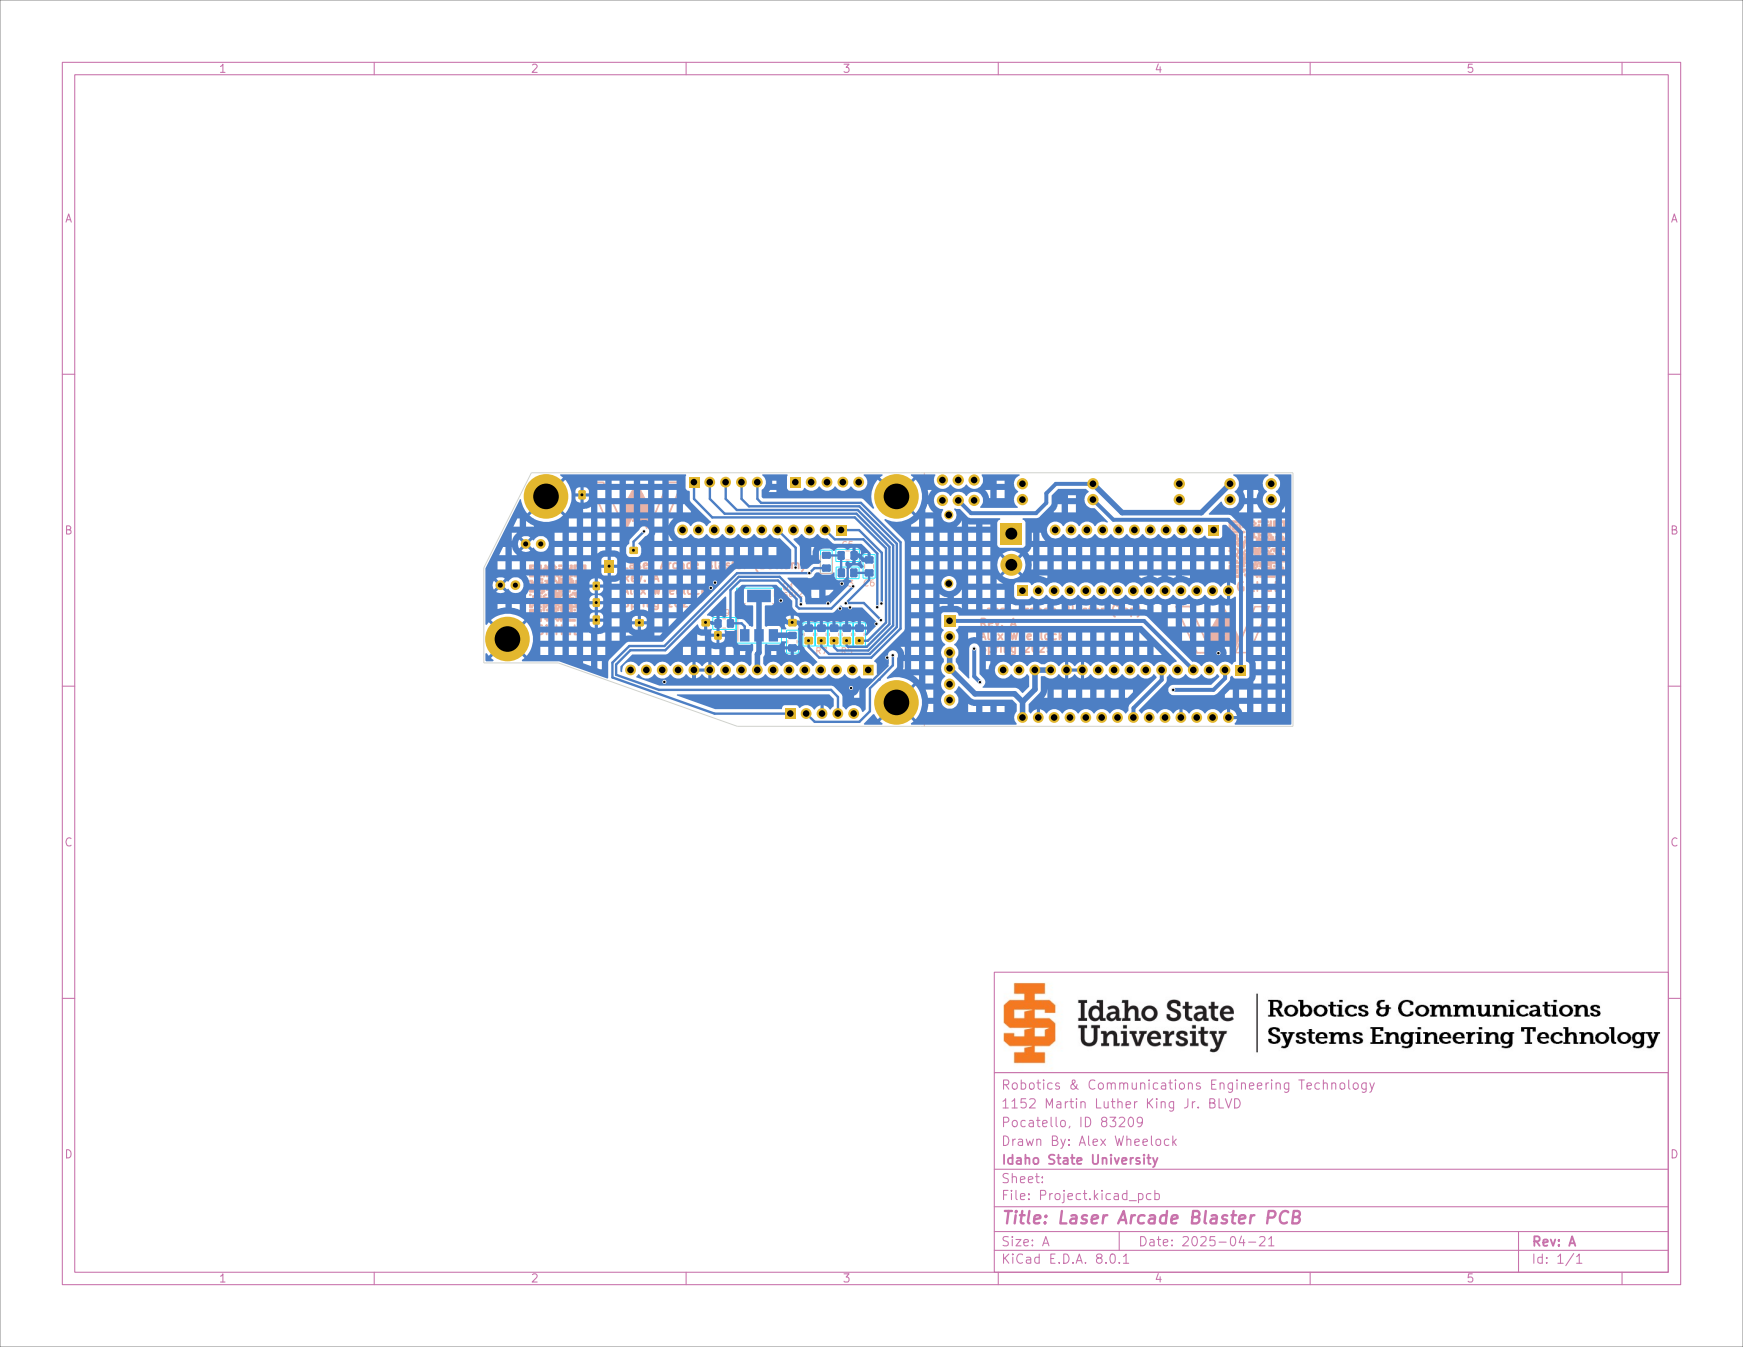
[picture p32: page 1]
