andrew1593571/RCETLaserArcade/KiCad/Blaster/LA_Blaster_RevA/Blaster PCB Front.pdf

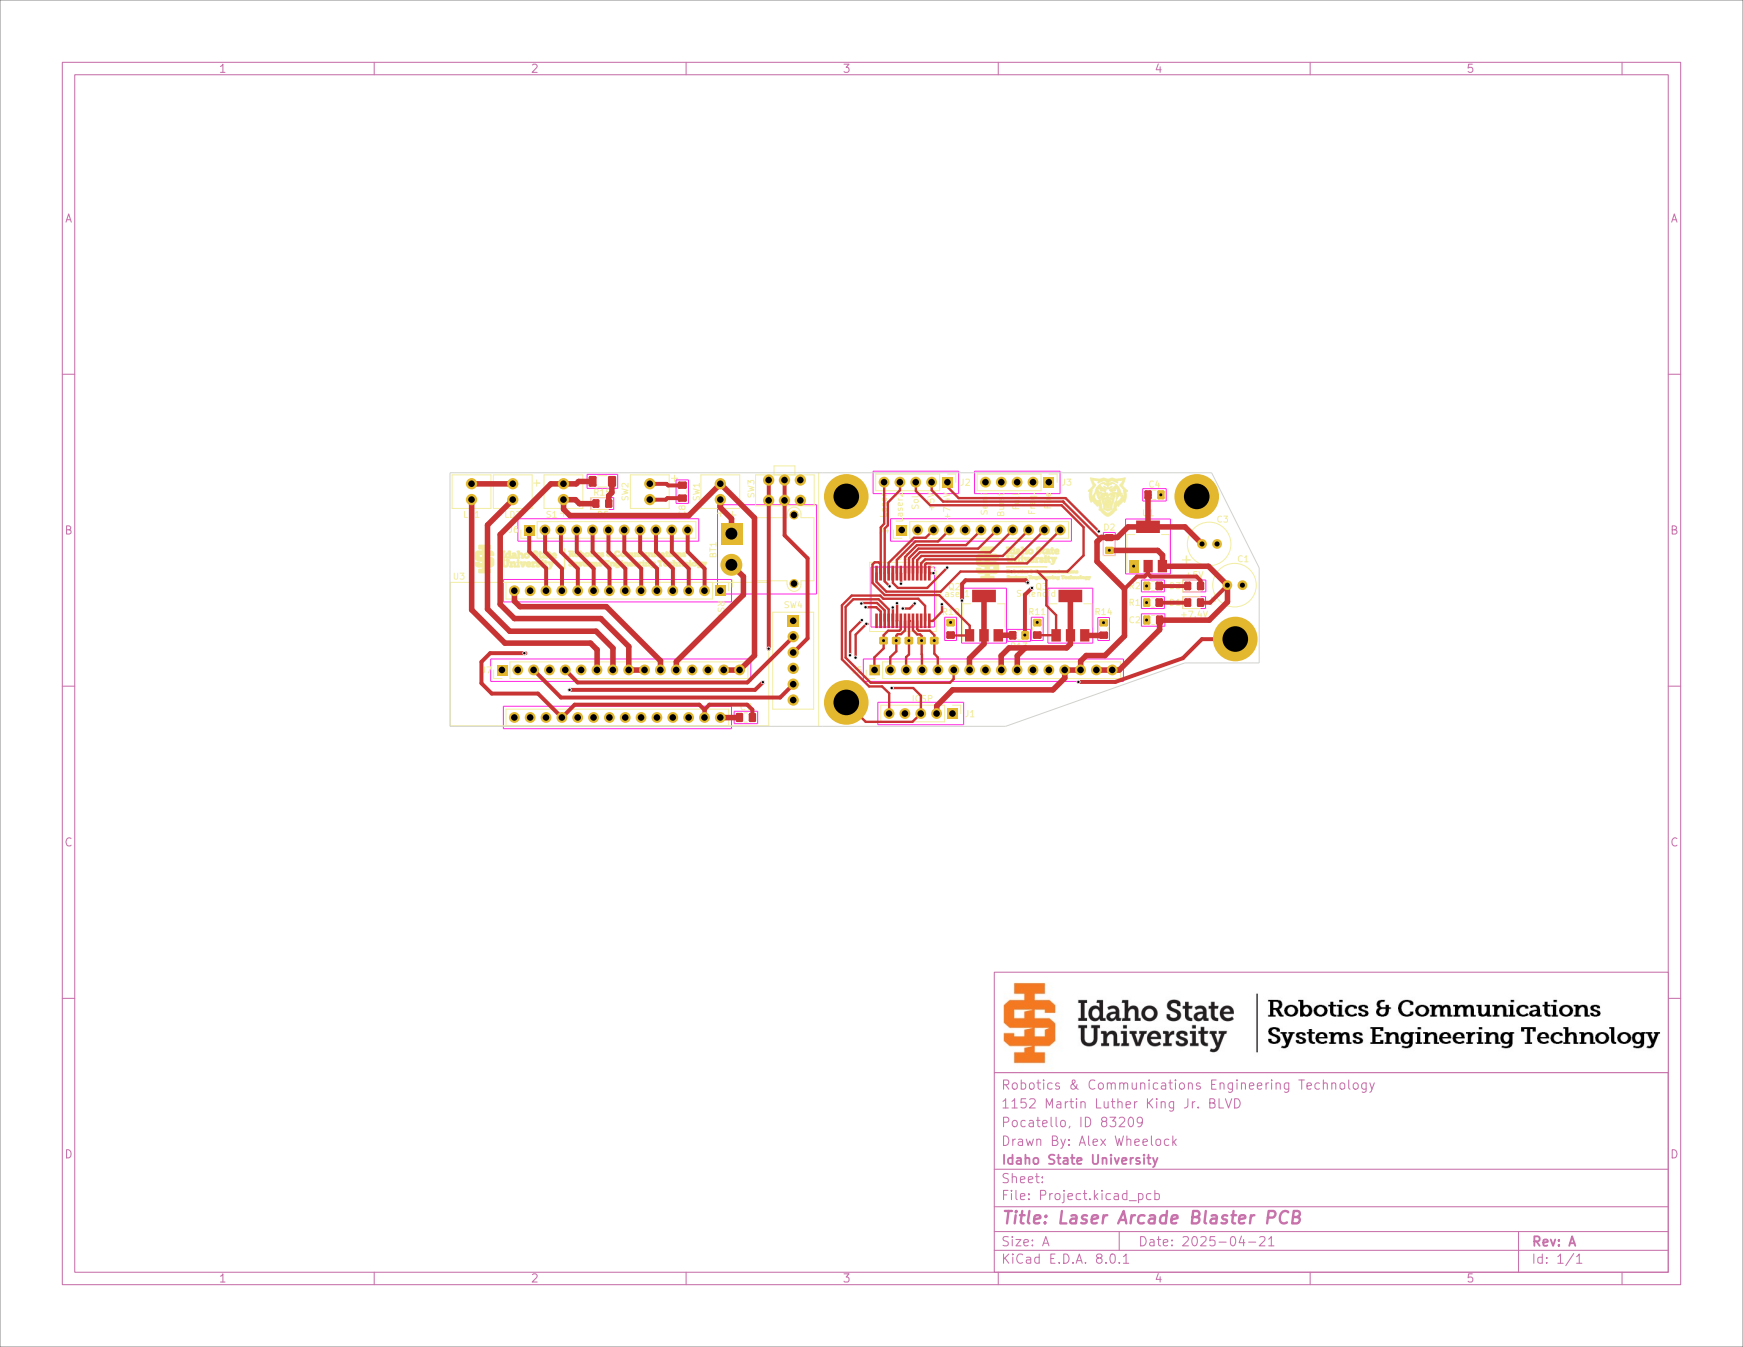
[picture p33: page 1]
