andrew1593571/RCETLaserArcade/KiCad/Target_Slave/Target_Slave_RevA/Laser Arcade Slave Schematic.pdf

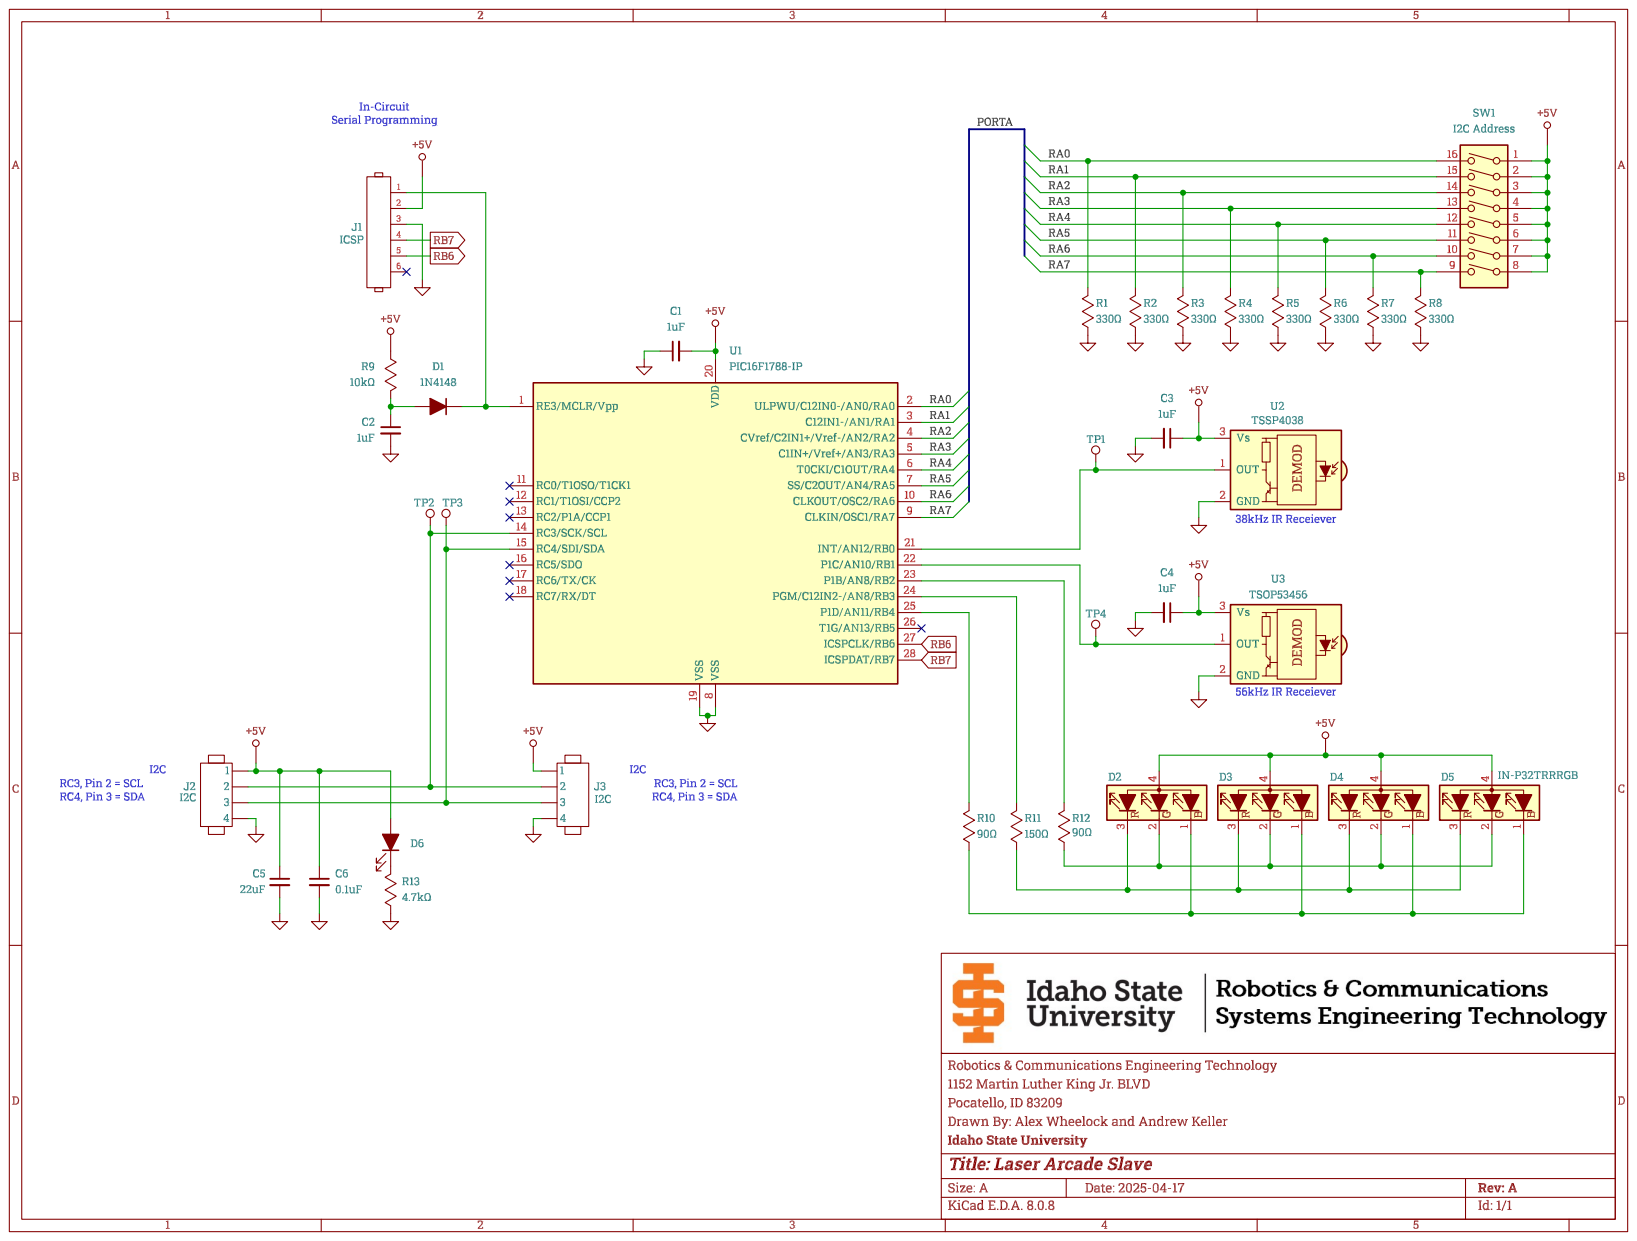
[picture p34: page 1]
