andrew1593571/RCETLaserArcade/KiCad/Target_Slave/Target_Slave_RevA/LA_Slave Back Copper.pdf

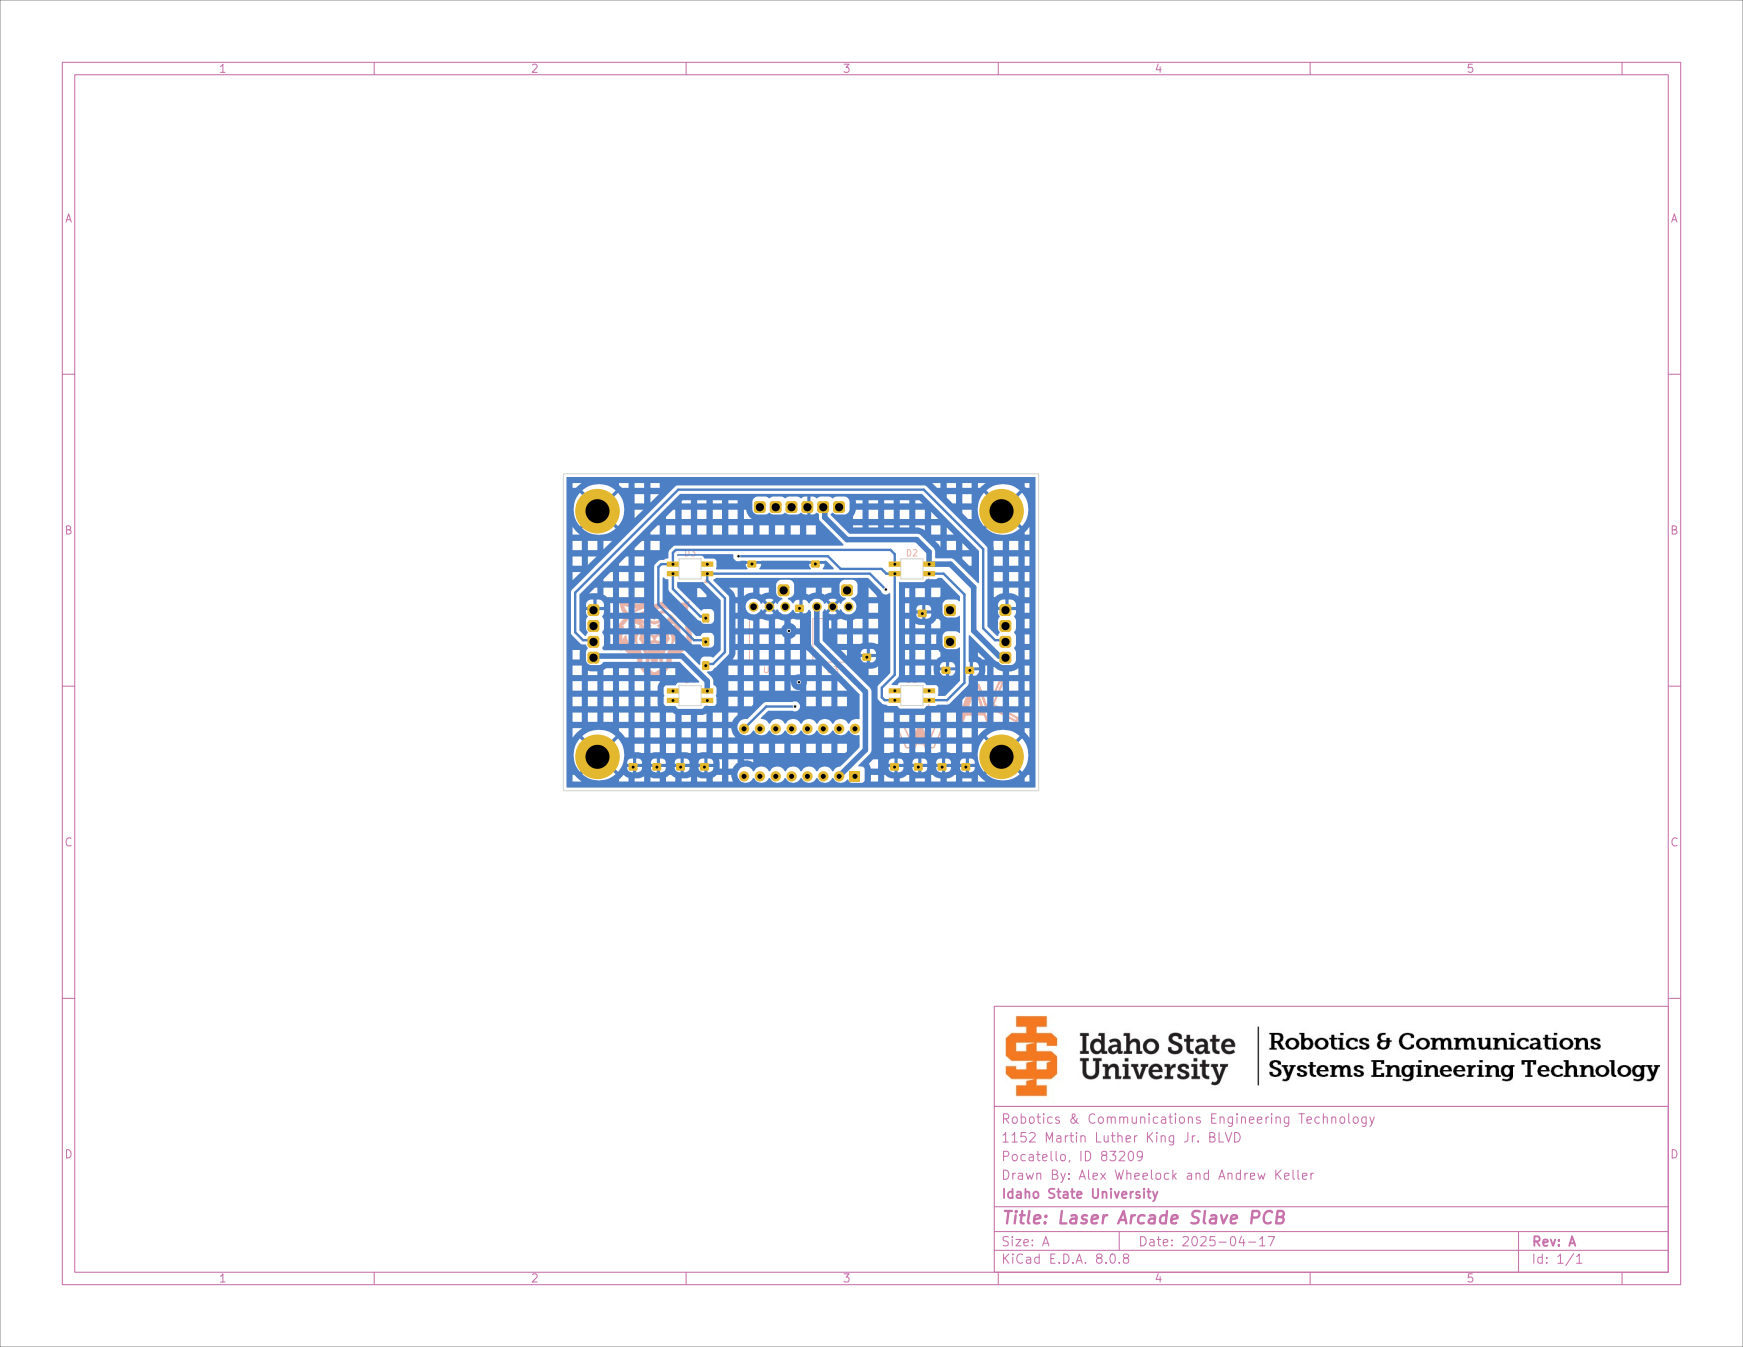
[picture p35: page 1]
