andrew1593571/RCETLaserArcade/KiCad/Target_Slave/Target_Slave_RevA/LA_Slave Front Copper.pdf

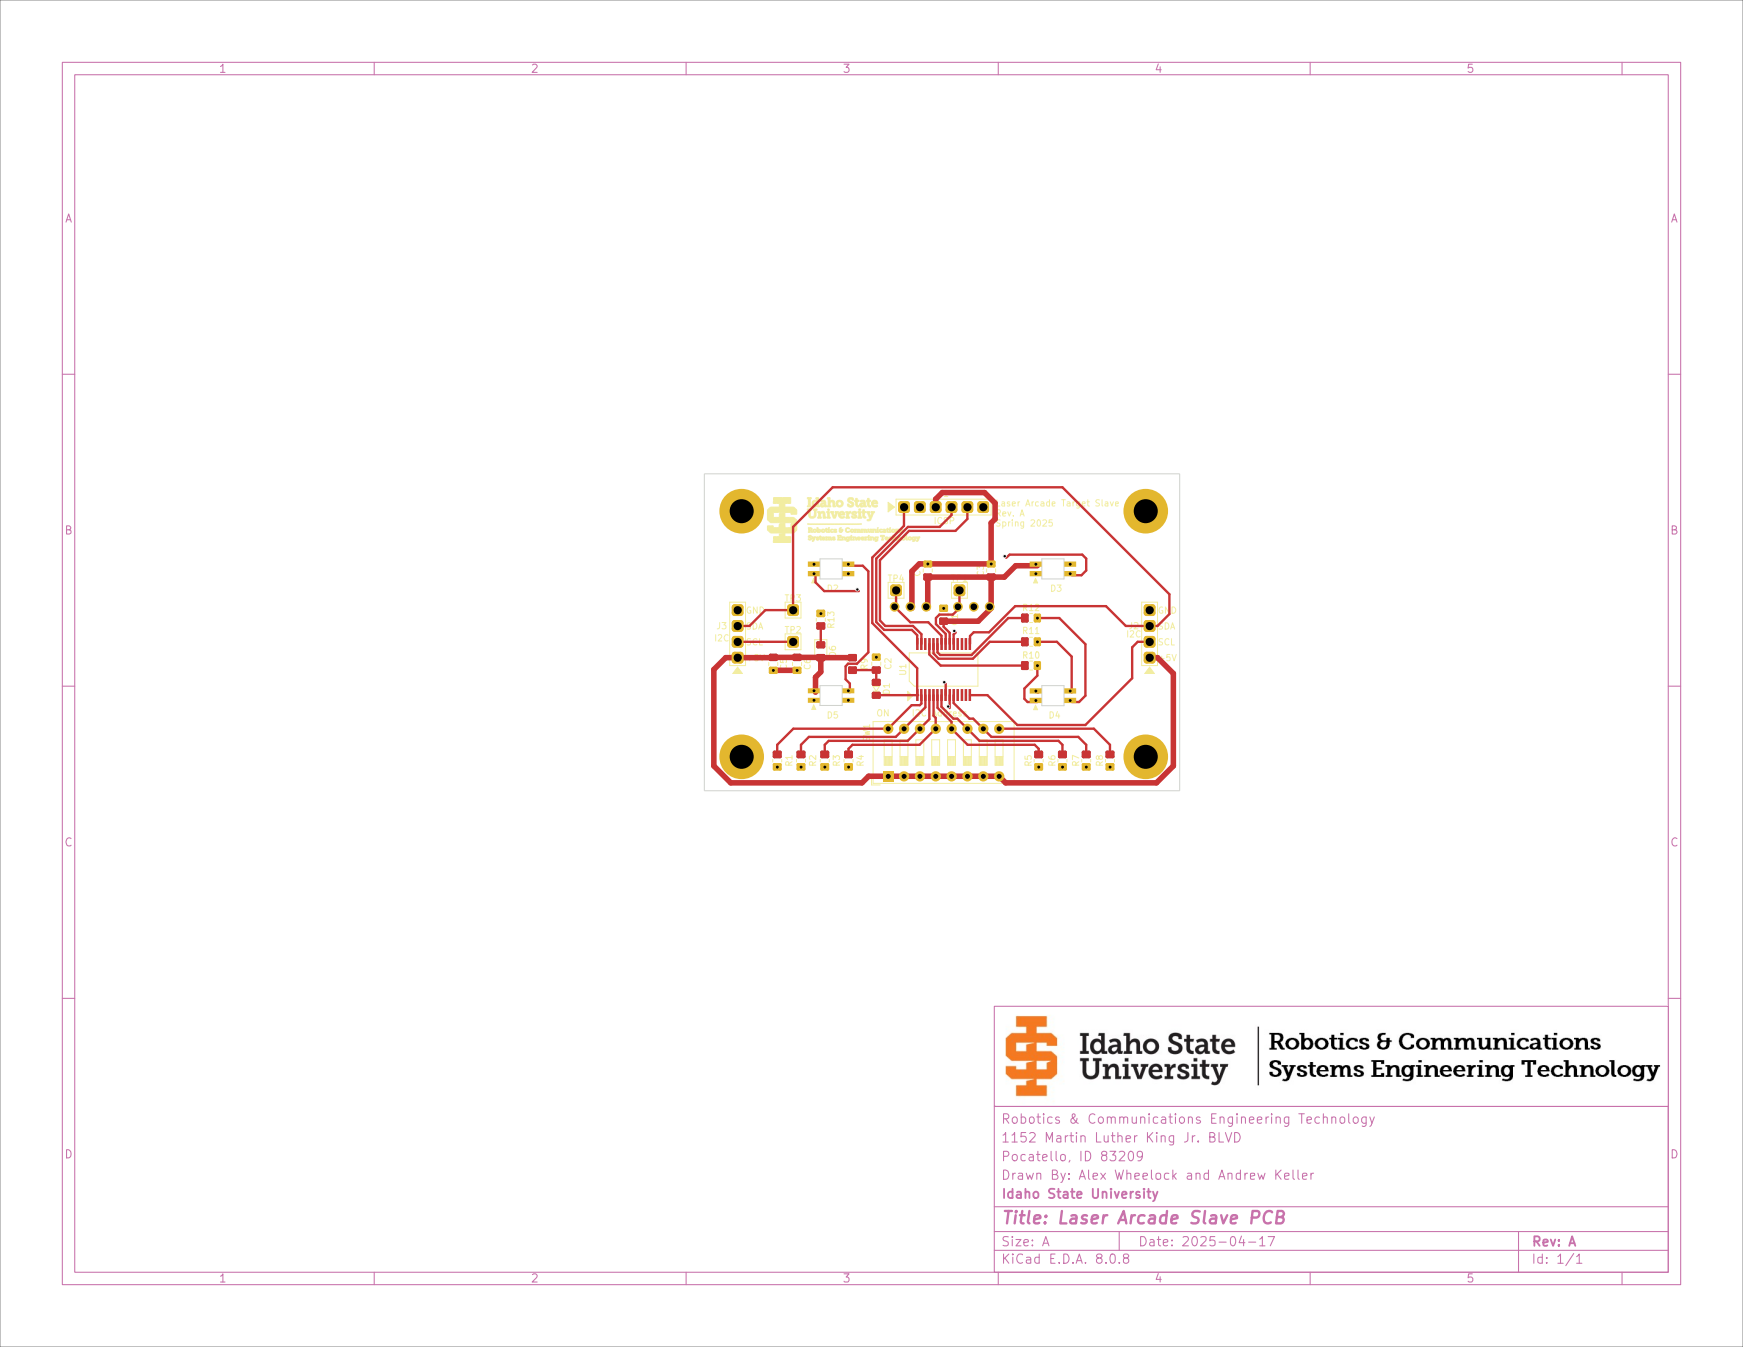
[picture p36: page 1]
