andrew1593571/RCETLaserArcade/KiCad/Target_Slave/Target_Slave_RevA/LA_Slave Front Fab.pdf

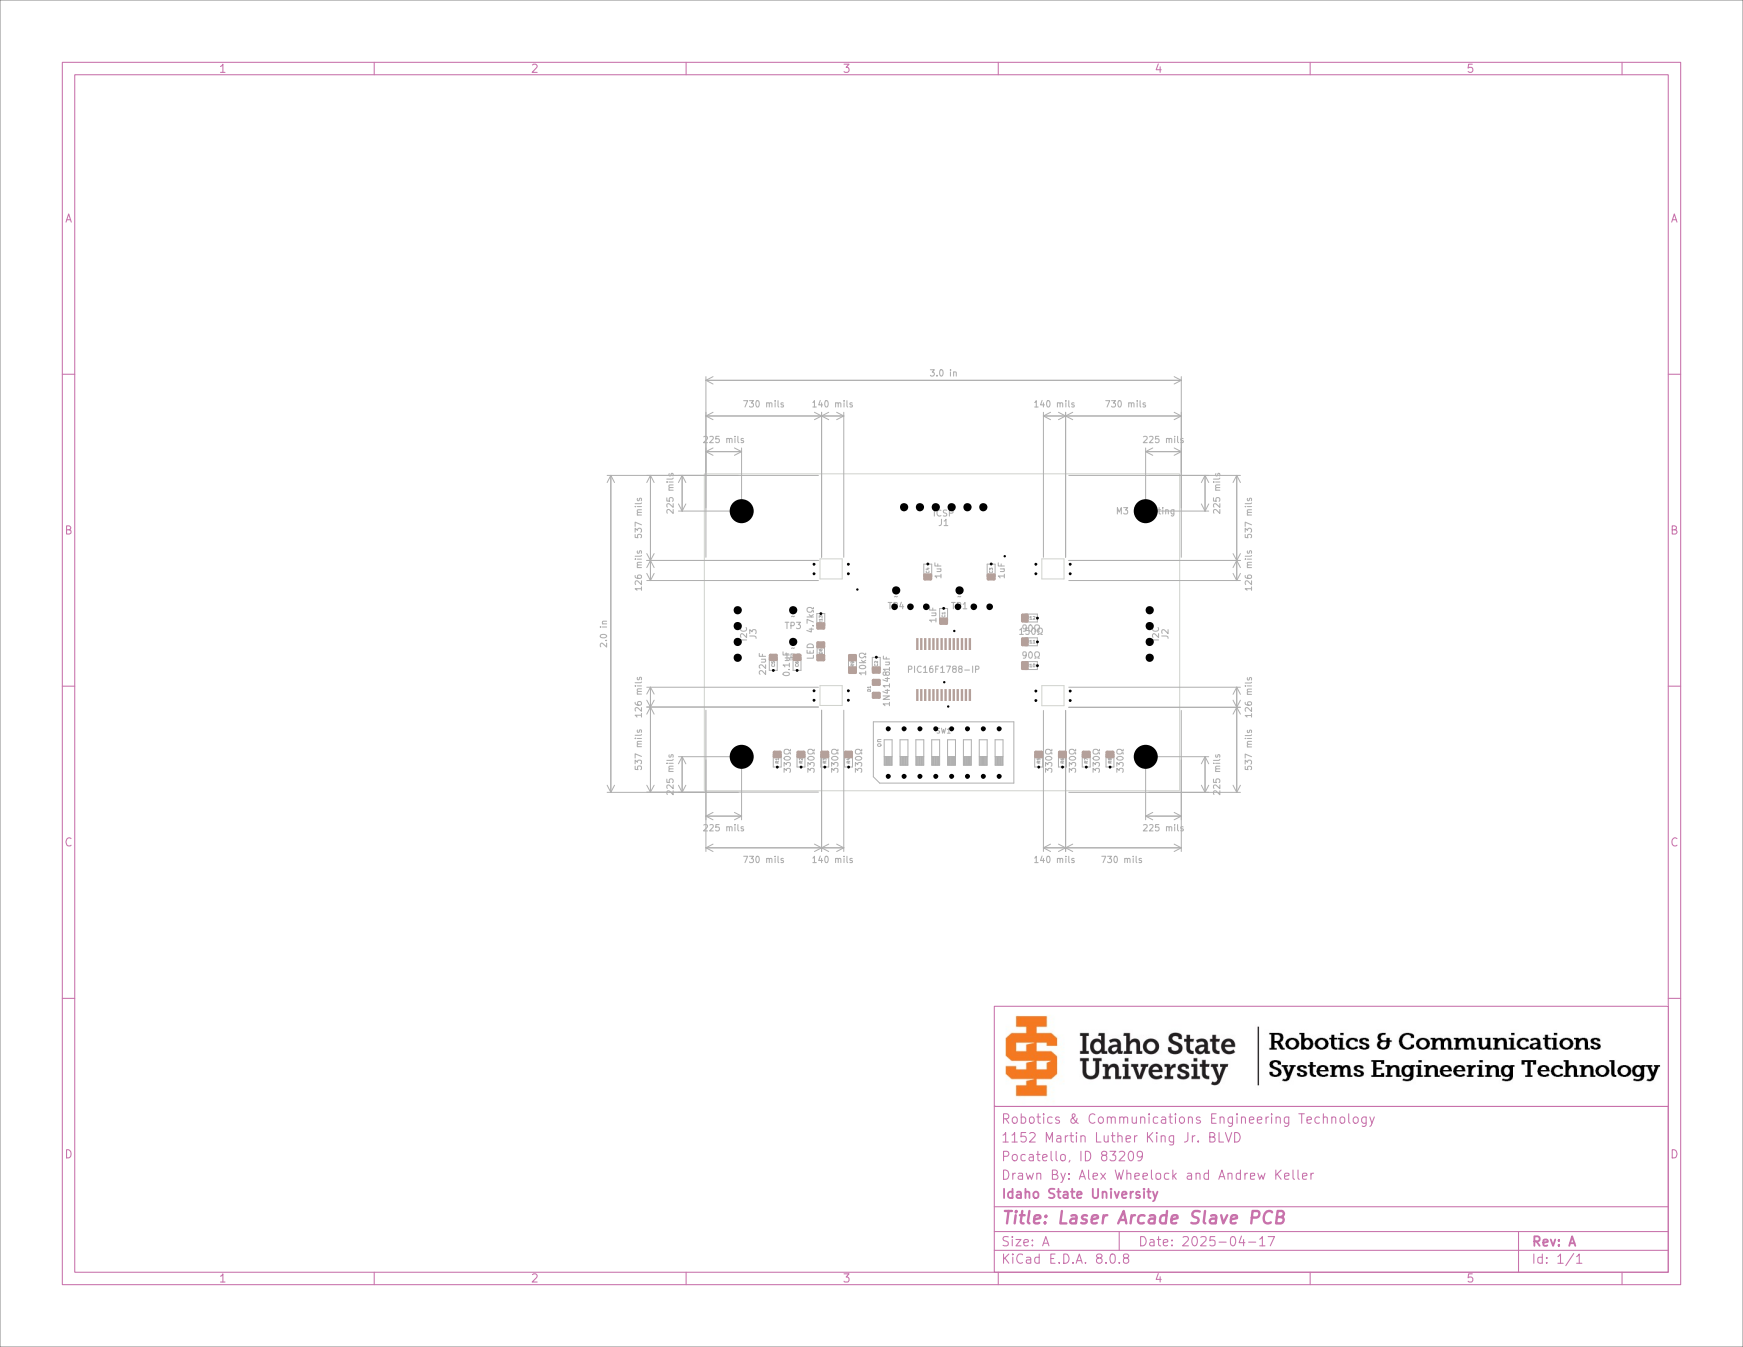
[picture p37: page 1]
