andrew1593571/RCETLaserArcade/KiCad/Blaster/Project.kicad_pcb

## KiCad design KiCad/Blaster/Project.kicad_pcb (2025-04-21)

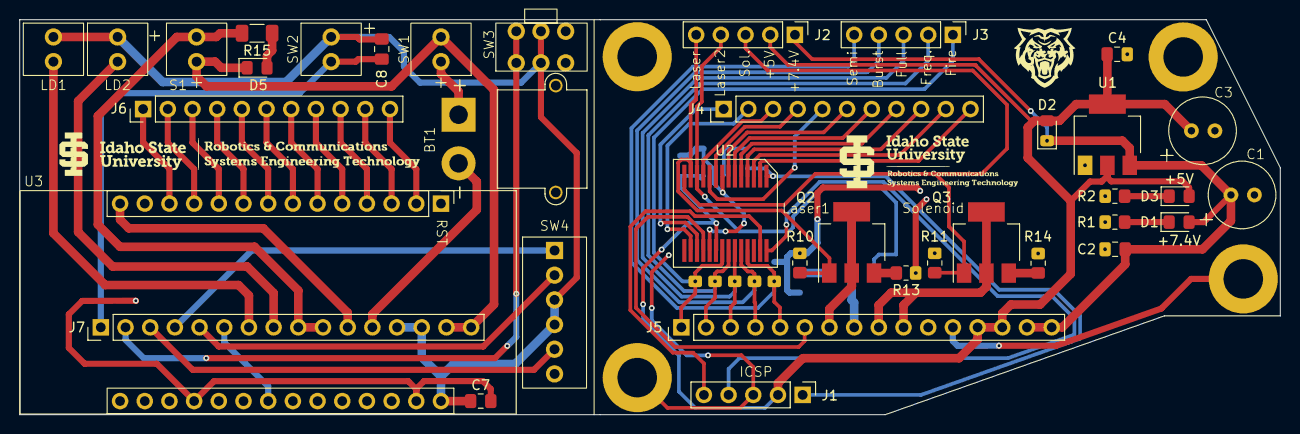
[picture p38: board Project.kicad_pcb from above]

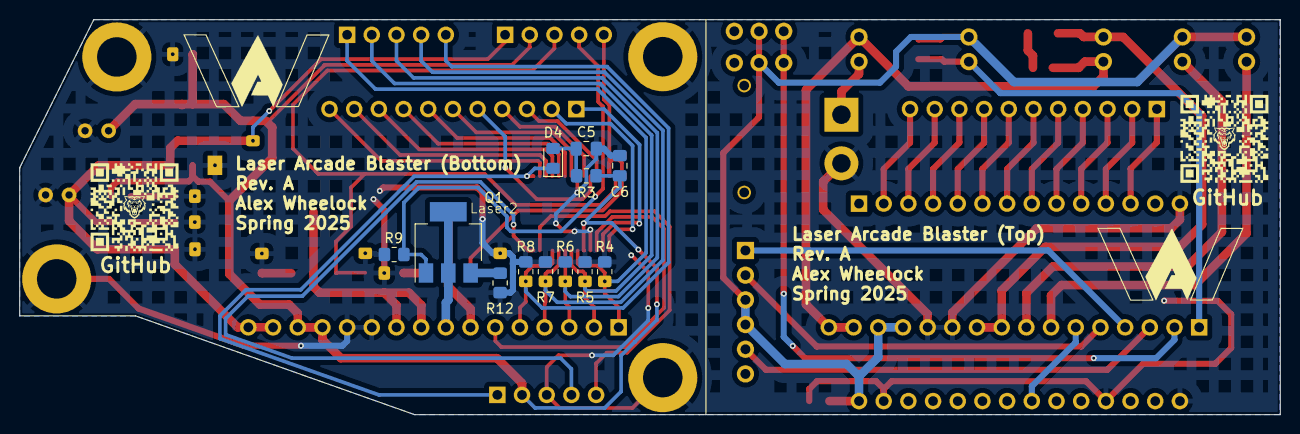
[picture p39: board Project.kicad_pcb from below]

Board: 2 copper layers, 129.7 x 40.6 mm, 49 parts (12 on the bottom side), 59 nets.

Parts:
BT1: 7.4V; Project_Battery_Connector
C1, C3: 220uF; Project_16V_220uF_Capacitor
C2, C4: 0.1uF; C_0805_2012Metric_Pad1.18x1.45mm_HandSolder
C5, C6, C7: 1uF; C_0805_2012Metric_Pad1.18x1.45mm_HandSolder
C8: 50pF; C_0805_2012Metric_Pad1.18x1.45mm_HandSolder
D1: +7.4V; LED_0805_2012Metric_Pad1.15x1.40mm_HandSolder
D2, D4, D5: 1N4148; D_0805_2012Metric_Pad1.15x1.40mm_HandSolder
D3: +5V; LED_0805_2012Metric_Pad1.15x1.40mm_HandSolder
J1: PinHeader_1x05_P2.54mm_Vertical
J2: Power & Output Test Points; PinHeader_1x05_P2.54mm_Vertical
J3: Inputs Test Points; PinHeader_1x05_P2.54mm_Vertical
J4, J6: PinHeader_1x11_P2.54mm_Vertical
J5, J7: PinHeader_1x16_P2.54mm_Vertical
LD1, LD2: Laser Diode; Project_Locking_Output_Header
Q1, Q2, Q3: BUK9832-55A; SOT-223-3_TabPin2
R1: 8.2kΩ; R_0805_2012Metric_Pad1.20x1.40mm_HandSolder
R2: 4.7kΩ; R_0805_2012Metric_Pad1.20x1.40mm_HandSolder
R3: 10kΩ; R_0805_2012Metric_Pad1.20x1.40mm_HandSolder
R4, R5, R6, R7, R8: 330Ω; R_0805_2012Metric_Pad1.20x1.40mm_HandSolder
R9, R10, R11: 100kΩ; R_0805_2012Metric_Pad1.20x1.40mm_HandSolder
R12, R13, R14: 0Ω; R_0805_2012Metric_Pad1.20x1.40mm_HandSolder
R15: 1kΩ; R_1206_3216Metric_Pad1.30x1.75mm_HandSolder
S1: Solenoid; Project_Locking_Output_Header
SW1: Power; Project_Locking_Output_Header
SW2: Fire; Project_Locking_Output_Header
SW3: Freq Select; Project_Blaster_Freq_Switch
SW4: Fire Select; Project_Locking_Header_1x06
U1: TLV1117-50; SOT-223-3_TabPin2
U2: PIC16F1788-IP; SSOP-28
U3: Audio Board; Project_Audio_Board

Connections:
+5V: C3.1, C4.1, C6.2, D2.2 (A), D3.2 (A), J1.2, J2.2, J5.13, J5.14, R3.2, U1.2 (VO), U2.20 (VDD)
+5V_Top: C7.2, C8.1, J7.13, J7.14, LD1.1 (A), LD2.1 (A), SW2.1, SW3.2 (B), SW4.3, SW4.4, U3.28 (VIN)
+7.4V: C1.1, C2.1, D1.2 (A), D2.1 (K), J2.1, J5.15, J5.16, U1.3 (VI)
+7.4V_Top: D5.1 (K), J7.15, J7.16, S1.1 (+), SW1.2 (B)
Burst: J3.4, J5.4, R7.1, U2.24 (PGM/C12IN2-/AN8/RB3)
Burst_Top: J7.4, SW4.1
Fire: J3.1, J5.1, R4.1, U2.21 (INT/AN12/RB0)
Fire_Top: C8.2, J7.1, SW2.2
Frequency Select: J3.2, J5.2, R5.1, U2.22 (P1C/AN10/RB1)
Frequency Select_Top: J7.2, SW3.1 (A)
Full-Auto: J3.3, J5.3, R6.1, U2.23 (P1B/AN8/RB2)
Full-Auto_Top: J7.3, SW4.5
GND: BT1.2 (-), C1.2, C2.2, C3.2, C4.2, C5.2, C6.1, C7.1, J1.3, J5.11, J5.12, J7.11, J7.12, R1.1, R2.1, R4.2, R5.2, R6.2, R7.2, R8.2, R9.2, R10.2, R11.2, R12.2, R13.2, R14.2, U1.1 (GND), U2.8 (VSS), U2.19 (VSS), U3.14 (GND), U3.15 (GND), U3.18 (GND), U3.27 (GND)
Laser/PWM: J5.7, Q2.2 (D)
Laser/PWM2: J5.8, Q1.2 (D)
Laser/PWM2_Top: J7.8, LD2.2 (K)
Laser/PWM_Top: J7.7, LD1.2 (K)
unnamed: BT1.1 (+), SW1.1 (A)
unnamed: D1.1 (K), R1.2
unnamed: D3.1 (K), R2.2
unnamed: C5.1, D4.2 (A), R3.1
unnamed: D4.1 (K), J1.1, U2.1 (RE3/~MCLR/Vpp)
unnamed: D5.2 (A), R15.2
unnamed: J2.4, Q1.1 (G), R9.1, U2.12 (RC1/T1OSI/CCP2)
unnamed: Q1.3 (S), R12.1
unnamed: J2.5, Q2.1 (G), R10.1, U2.13 (RC2/P1A/CCP1)
unnamed: Q2.3 (S), R13.1
unnamed: J2.3, Q3.1 (G), R11.1, U2.14 (RC3/SCK/SCL)
unnamed: Q3.3 (S), R14.1
RB6: J1.5, U2.27 (ICSPCLK/RB6)
RB7: J1.4, U2.28 (ICSPDAT/RB7)
Semi-Auto: J3.5, J5.5, R8.1, U2.25 (P1D/AN11/RB4)
Semi-Auto_Top: J7.5, SW4.2
Solenoid: J5.9, J5.10, Q3.2 (D)
Solenoid_Top: J7.9, J7.10, R15.1, S1.2 (-)
TRIG0: J4.11, U2.2 (ULPWU/C12IN0-/AN0/RA0)
TRIG0_Top: J6.11, U3.2 (TRIG0)
TRIG1: J4.10, U2.3 (C12IN1-/AN1/RA1)
TRIG1_Top: J6.10, U3.3 (TRIG1)
TRIG2: J4.9, U2.4 (CVref/C2IN1+/Vref-/AN2/RA2)
TRIG2_Top: J6.9, U3.4 (TRIG2)
TRIG3: J4.8, U2.5 (C1IN+/Vref+/AN3/RA3)
TRIG3_Top: J6.8, U3.5 (TRIG3)
TRIG4: J4.7, U2.6 (T0CKI/C1OUT/RA4)
TRIG4_Top: J6.7, U3.6 (TRIG4)
TRIG5: J4.6, U2.7 (~SS/C2OUT/AN4/RA5)
TRIG5_Top: J6.6, U3.7 (TRIG5)
TRIG6: J4.5, U2.10 (CLKOUT/OSC2/RA6)
TRIG6_Top: J6.5, U3.8 (TRIG6)
TRIG7: J4.4, U2.9 (CLKIN/OSC1/RA7)
TRIG7_Top: J6.4, U3.9 (TRIG7)
TRIG8: J4.3, U2.11 (RC0/T1OSO/T1CK1)
TRIG8_Top: J6.3, U3.10 (TRIG8)
TRIG9: J4.2, U2.16 (RC5/SDO)
TRIG9_Top: J6.2, U3.11 (TRIG9)
TRIG10: J4.1, U2.17 (RC6/TX/CK)
TRIG10_Top: J6.1, U3.12 (TRIG10)
VOL+: J5.6, U2.18 (RC7/RX/DT)
VOL+_Top: J7.6, U3.21 (VOL+)
