andrew1593571/RCETLaserArcade/KiCad/Target_Slave/Target_Slave.kicad_pcb

## KiCad design KiCad/Target_Slave/Target_Slave.kicad_pcb (2025-05-08)

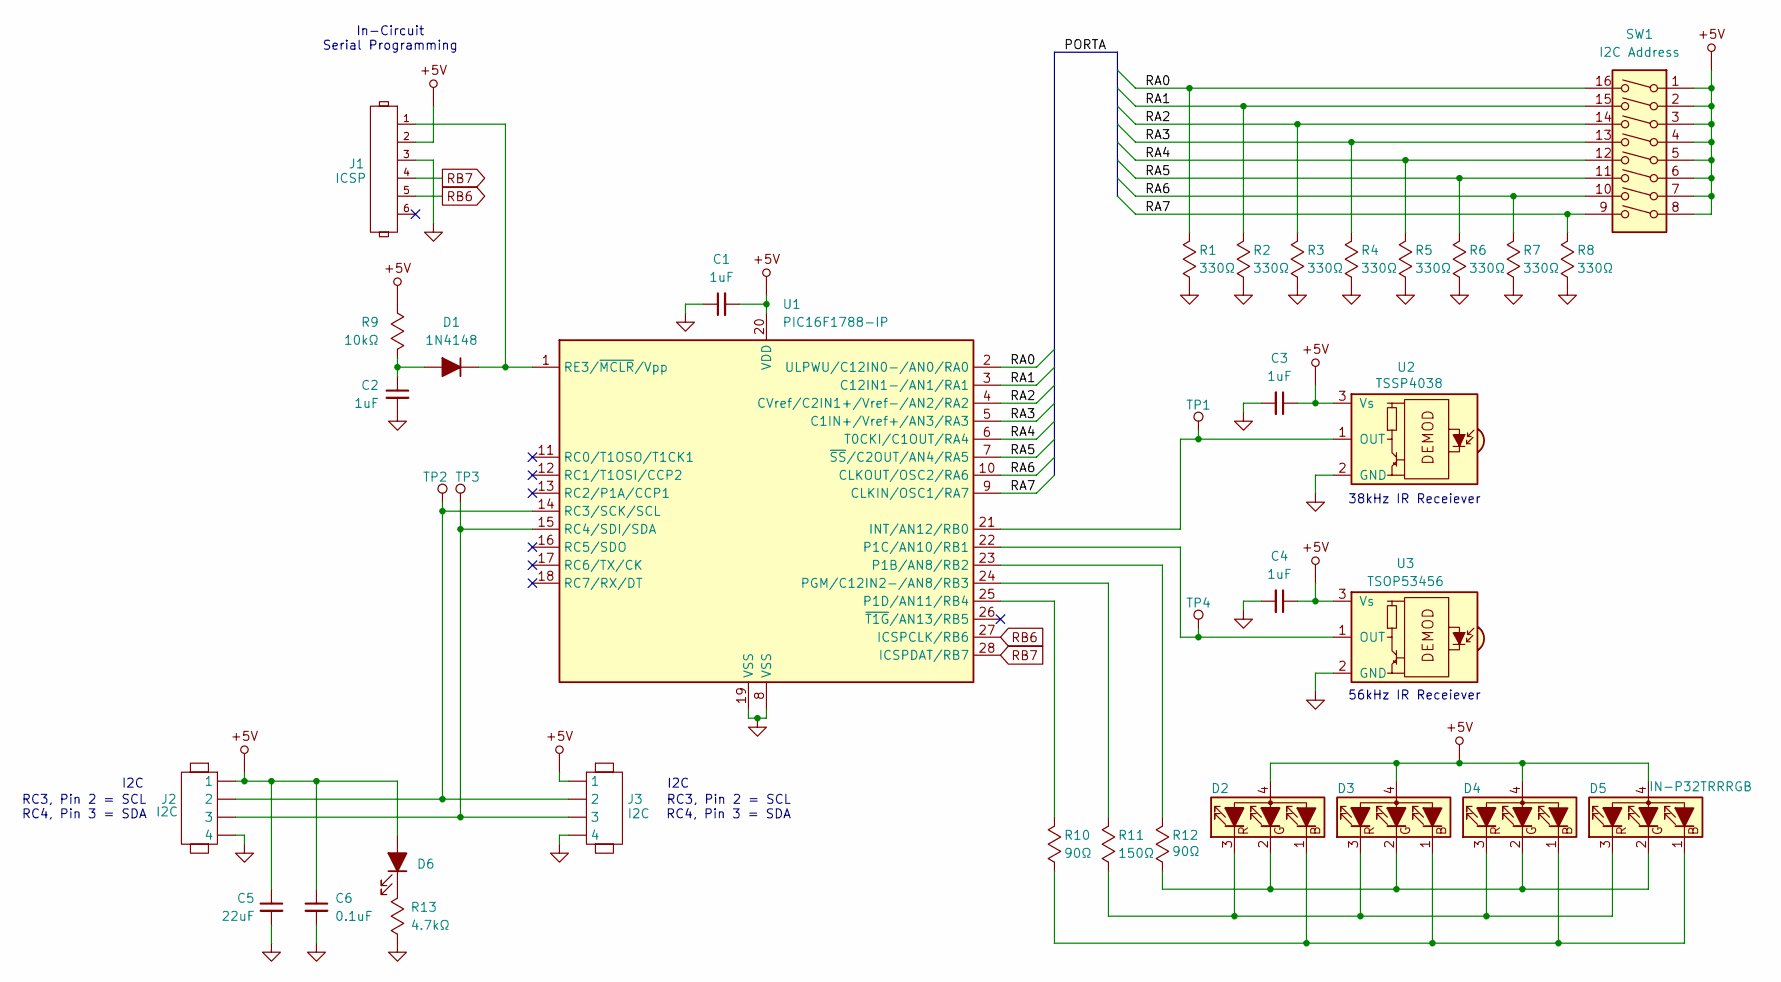
[picture p40: schematic Target_Slave.kicad_sch, Laser Arcade Slave]

Parts:
C1, C2, C3, C4: 1uF; C_0805_2012Metric_Pad1.18x1.45mm_HandSolder
C5: 22uF; C_0805_2012Metric_Pad1.18x1.45mm_HandSolder
C6: 0.1uF; C_0805_2012Metric_Pad1.18x1.45mm_HandSolder
D1: 1N4148; Diode_0805
D2, D3, D4, D5: IN-P32TRRRGB
D6: LED; LED_0805_2012Metric_Pad1.15x1.40mm_HandSolder
J1: ICSP; 1x6_100mil_Header
J2, J3: I2C; 1x4_100mil_Header
R1, R2, R3, R4, R5, R6, R7, R8: 330Ω; R_0805_2012Metric_Pad1.20x1.40mm_HandSolder
R9: 10kΩ; R_0805_2012Metric_Pad1.20x1.40mm_HandSolder
R10, R12: 90Ω; R_0805_2012Metric_Pad1.20x1.40mm_HandSolder
R11: 150Ω; R_0805_2012Metric_Pad1.20x1.40mm_HandSolder
R13: 4.7kΩ; R_0805_2012Metric_Pad1.20x1.40mm_HandSolder
SW1: I2C Address; SW_DIP_SPSTx08_Slide_9.78x22.5mm_W7.62mm_P2.54mm
TP1, TP2, TP3, TP4: 1x1_100mil_Header
U1: PIC16F1788-IP; SSOP-28
U2: TSSP4038; IR Receiver
U3: TSOP53456; IR Receiver

Connections:
+5V: C1.2, C3.1, C4.1, C5.1, C6.1, D2.4 (A), D3.4 (A), D4.4 (A), D5.4 (A), D6.2 (A), J1.2, J2.1, J3.1, R9.2, SW1.1, SW1.2, SW1.3, SW1.4, SW1.5, SW1.6, SW1.7, SW1.8, U1.20 (VDD), U2.3 (Vs), U3.3 (Vs)
/RA0: R1.2, SW1.16, U1.2 (ULPWU/C12IN0-/AN0/RA0)
/RA1: R2.2, SW1.15, U1.3 (C12IN1-/AN1/RA1)
/RA2: R3.2, SW1.14, U1.4 (CVref/C2IN1+/Vref-/AN2/RA2)
/RA3: R4.2, SW1.13, U1.5 (C1IN+/Vref+/AN3/RA3)
/RA4: R5.2, SW1.12, U1.6 (T0CKI/C1OUT/RA4)
/RA5: R6.2, SW1.11, U1.7 (~SS/C2OUT/AN4/RA5)
/RA6: R7.2, SW1.10, U1.10 (CLKOUT/OSC2/RA6)
/RA7: R8.2, SW1.9, U1.9 (CLKIN/OSC1/RA7)
GND: C1.1, C2.2, C3.2, C4.2, C5.2, C6.2, J1.3, J2.4, J3.4, R1.1, R2.1, R3.1, R4.1, R5.1, R6.1, R7.1, R8.1, R13.1, U1.8 (VSS), U1.19 (VSS), U2.2 (GND), U3.2 (GND)
unnamed: C2.1, D1.2 (A), R9.1
unnamed: D1.1 (K), J1.1, U1.1 (RE3/~MCLR/Vpp)
unnamed: D2.1 (BK), D3.1 (BK), D4.1 (BK), D5.1 (BK), R10.1
unnamed: D2.2 (GK), D3.2 (GK), D4.2 (GK), D5.2 (GK), R12.2
unnamed: D2.3 (RK), D3.3 (RK), D4.3 (RK), D5.3 (RK), R11.1
unnamed: D6.1 (K), R13.2
unnamed: TP1.1, U1.21 (INT/AN12/RB0), U2.1 (OUT)
unnamed: R12.1, U1.23 (P1B/AN8/RB2)
unnamed: TP4.1, U1.22 (P1C/AN10/RB1), U3.1 (OUT)
unnamed: R10.2, U1.25 (P1D/AN11/RB4)
unnamed: R11.2, U1.24 (PGM/C12IN2-/AN8/RB3)
unnamed: J2.2, J3.2, TP2.1, U1.14 (RC3/SCK/SCL)
unnamed: J2.3, J3.3, TP3.1, U1.15 (RC4/SDI/SDA)
RB6: J1.5, U1.27 (ICSPCLK/RB6)
RB7: J1.4, U1.28 (ICSPDAT/RB7)

Notes on the sheet:
I2C
RC3, Pin 2 = SCL RC4, Pin 3 = SDA
In-Circuit Serial Programming
56kHz IR Receiever
38kHz IR Receiever

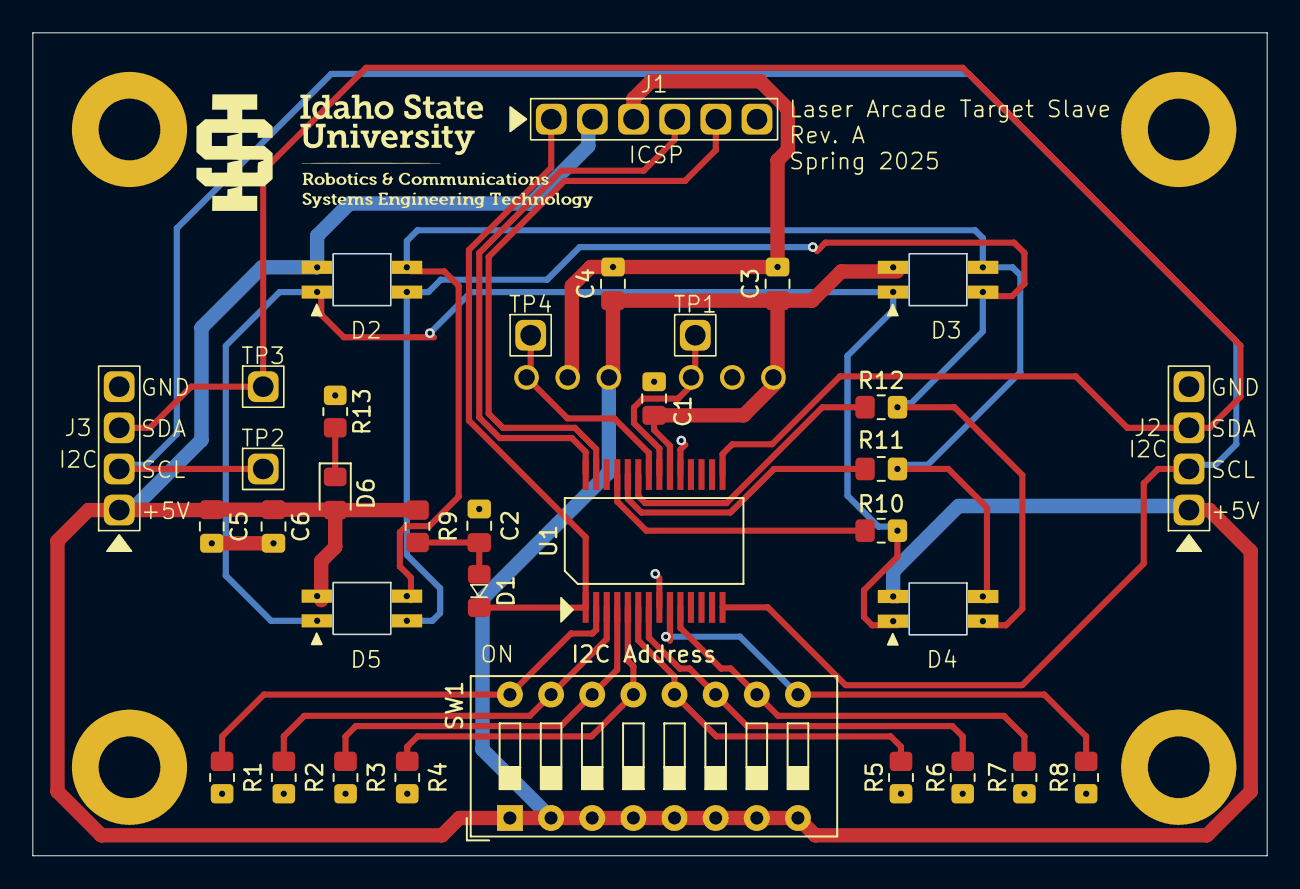
[picture p41: board Target_Slave.kicad_pcb from above]

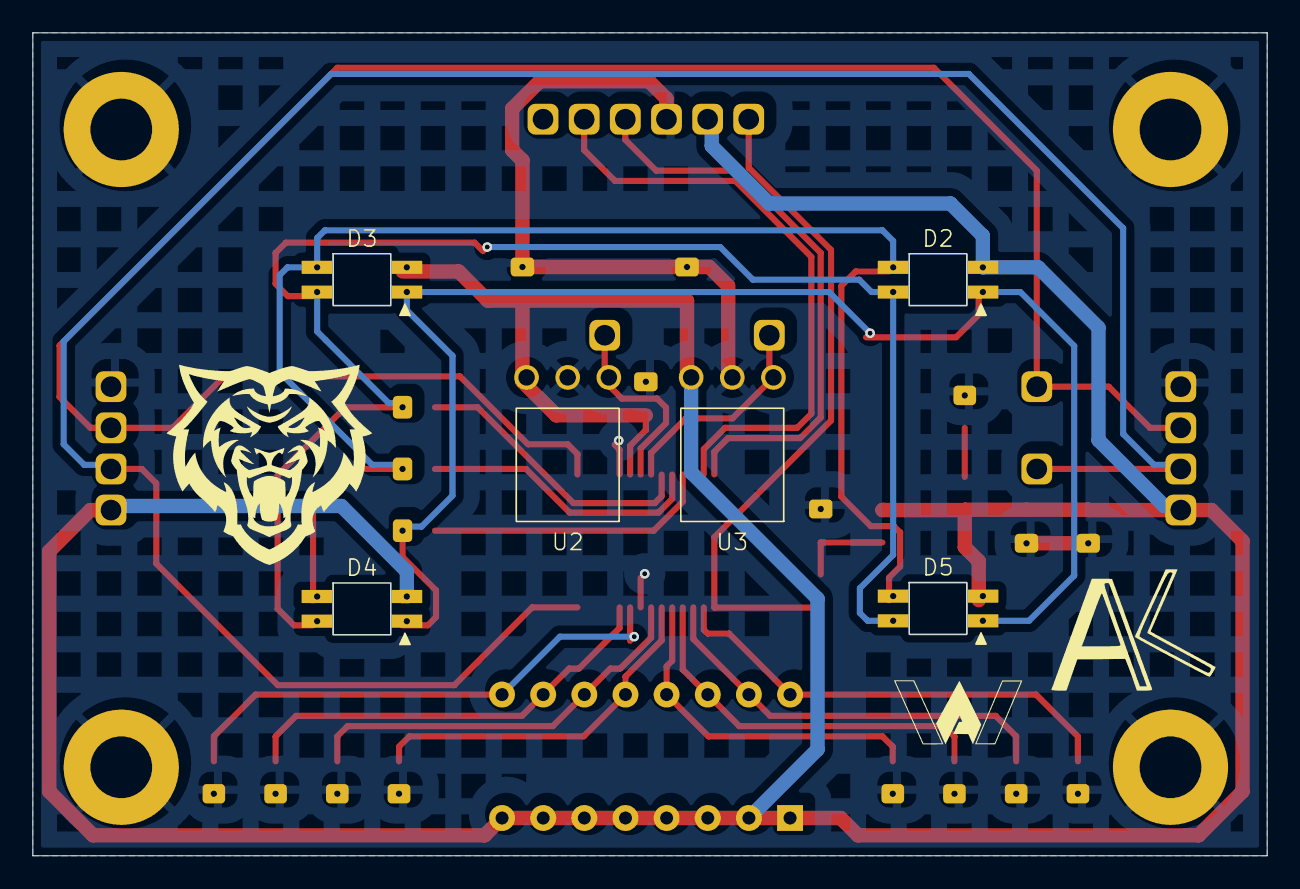
[picture p42: board Target_Slave.kicad_pcb from below]

Board: 2 copper layers, 76.2 x 50.8 mm, 36 parts (6 on the bottom side), 25 nets.
