andrew1593571/RCETLaserArcade/(commit log)

2025-04-04 Initialize repo with current project materials
    [Blaster.kicad_sch, Blaster_Power.kicad_sch, Project BOMs.xlsx, Project.kicad_pcb, Project.kicad_sch, Project.xlsx, Slave_LEDs.kicad_sch, Slave_Microcontroller.kicad_sch]
2025-04-04 adding/fixing UART in master schematic.
    [Target.kicad_sch, Target_Master.kicad_sch, Target_Power.kicad_sch, UART.kicad_sch]
2025-04-10 Remove .X Folders
    [Blaster.kicad_sch, Blaster_Power.kicad_sch, Project.kicad_sch, Slave_LEDs.kicad_sch, Slave_Microcontroller.kicad_sch, Target.kicad_sch, Target_Master.kicad_sch, Target_Power.kicad_sch]
2025-04-10 Add Serial Port, Connect and Disconnect from Serial, send device verification command
2025-04-11 Add UART setup for 9600 baud, enable UART receive interrupt
2025-04-11 UART RX/TX setup, Device verification command response
2025-04-11 Updated blaster schematic
    [Blaster.kicad_sch, Blaster_Power.kicad_sch]
2025-04-11 Interpret UART commands to set flags for I2C to handle, Add UARTSENDSCORE subroutine
2025-04-11 receive device verification command
2025-04-14 Finalized schematics
    [Blaster.kicad_sch, Blaster_Power.kicad_sch, Project.kicad_pcb, Project.kicad_sch, Target_Master.kicad_sch, Target_Power.kicad_sch, Target_Slave.kicad_sch, UART.kicad_sch]
2025-04-14 Init LaserArcade and ArcadeTarget classes, Move serial communications into LaserArcade class, enable specific targets, enable random targets
2025-04-15 started working on blaster PCB
    [Project.kicad_pcb]
2025-04-15 working on the PCB for the blaster
    [Blaster.kicad_sch, Project.kicad_pcb]
2025-04-15 Control form GUI, track player scores
2025-04-16 got a lot done on the blaster PCB
    [Blaster.kicad_sch, Blaster_Power.kicad_sch, Project.kicad_pcb, Project.kicad_sch]
2025-04-16 blaster PCB is nearly finished
    [Project.kicad_pcb]
2025-04-16 Target Slave PCB
    [Target_Slave.kicad_pcb, Target_Slave.kicad_sch]
2025-04-17 Add Silkscreen text, Add logos
    [Target_Slave.kicad_pcb]
2025-04-17 added title block and logo
    [Blaster.kicad_sch, Blaster_Power.kicad_sch, Project.kicad_pcb, Project.kicad_sch]
2025-04-17 Master PCB design, Slave board logos
    [Target.kicad_pcb, Target.kicad_sch, Target_Master.kicad_sch, Target_Power.kicad_sch, Target_Slave.kicad_pcb, Target_Slave.kicad_sch, UART.kicad_sch]
2025-04-17 Master board silkscreen and gerber files
    [Target.kicad_pcb, Target.kicad_sch, Target_Master.kicad_sch, Target_Power.kicad_sch, Target_Slave.kicad_sch, UART.kicad_sch]
2025-04-17 kiCad backup files
2025-04-17 recovered some lost parts of the schematic, still needs a bit of work to get back
    [Blaster.kicad_sch, Blaster_Bottom.kicad_sch, Blaster_Power.kicad_sch, Blaster_Top.kicad_sch, Project.kicad_pcb]
2025-04-18 fixed the schematics, and got the new components added into the PCB, need to rerun a lot of traces.
    [Blaster_Bottom.kicad_sch, Blaster_Power.kicad_sch, Blaster_Top.kicad_sch, Project.kicad_pcb, Project.kicad_sch]
2025-04-18 Target Master Gerbers
    [Master BOM.csv, Target.kicad_pcb]
2025-04-18 Slave Gerbers
    [Slave BOM.csv, Target_Slave.kicad_pcb]
2025-04-18 PCB nearly done for the blaster
    [Blaster_Bottom.kicad_sch, Blaster_Power.kicad_sch, Blaster_Top.kicad_sch, Project.kicad_pcb, Project.kicad_sch]
2025-04-21 finished blaster PCB
    [Blaster_Bottom.kicad_sch, Blaster_Power.kicad_sch, Blaster_Top.kicad_sch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]
2025-04-22 Slave I2C protocol, enabling and disabling target, i2c read response, interrupt on change ISR
2025-04-22 Single Target I2C, interpret scores, send scores back via UART
2025-04-22 Change Slave I2C address using dipswitches
2025-04-22 Add Two I2C targets communications protocol
2025-04-22 Add target slots three through eight to master
2025-04-22 Fix crash when score received through UART
2025-04-23 Update which LEDs are on and when
2025-04-23 Move updating player scores on GUI from GameTimer tick to separate timer
2025-04-23 Prevent changes in connection during a game, require device verification again after disconnect
2025-04-24 blaster solenoid mount, speaker box, and barrel designed
    [Laser_Arcade_Blaster_Barrel.3mf, Laser_Arcade_Blaster_Solenoid_Mount.3mf, Laser_Arcade_Blaster_Speaker_Box.3mf]
2025-04-29 Got all of the 3D modeling for the blaster completed
    [Laser_Arcade_Blaster_Barrel.3mf, Laser_Arcade_Blaster_Barrel_v2.3mf, Laser_Arcade_Blaster_Rear_Hook_v2.3mf, Laser_Arcade_Blaster_Solenoid_Mount.3mf, Laser_Arcade_Blaster_Solenoid_Mount_v2.3mf, Laser_Arcade_Blaster_Solenoid_Mount_v3.3mf, Laser_Arcade_Blaster_Speaker_Box_v2.3mf]
2025-05-04 updated the blaster code to work with the PCB correctly
2025-05-05 fixed the blaster code in GitHub
    [LA_BLASTER.asm]
2025-05-07 comments, add LaserArcade event for unexpected COM disconnects, start COM port refresh timer at load
2025-05-07 Correct schematic graphic issues on Slave
    [Target_Slave.kicad_pcb, Target_Slave.kicad_sch]
2025-05-07 Add titleblock to target PCBs
    [Target.kicad_pcb, Target_Slave.kicad_pcb]
2025-05-07 pushing final changes to the project
    [Blaster_Bottom.kicad_sch, Blaster_Power.kicad_sch, Blaster_Top.kicad_sch, Project.kicad_sch]
2025-05-08 Add target 3D Models
    [LA_4inTarget.stl, LA_DIN Rail Mount.stl, LA_Master DIN Rail Mount.stl]
2025-05-08 Add Spring 2025 Project Report and Presentation
2025-05-08 Random KiCad files
2025-10-21 Add Kicad backup and lock files to gitignore
2025-10-21 Apply new gitignore to remove KiCad backup and lock files
    [Blaster.kicad_sch, Blaster_Power.kicad_sch]
2025-10-22 Move I2C notes to References
2025-10-22 Moved Blaster KiCad files into separate folder
    [Blaster.kicad_sch, Blaster_Bottom.kicad_sch, Blaster_Power.kicad_sch, Blaster_Top.kicad_sch, Project.kicad_pcb, Project.kicad_sch]
2025-10-22 Split Target and Blaster 3D files into folders
    [LA_4inTarget.stl, LA_DIN Rail Mount.stl, LA_Master DIN Rail Mount.stl, Laser_Arcade_Blaster_Barrel_v2.3mf, Laser_Arcade_Blaster_Rear_Hook_v2.3mf, Laser_Arcade_Blaster_Solenoid_Mount_v2.3mf, Laser_Arcade_Blaster_Solenoid_Mount_v3.3mf, Laser_Arcade_Blaster_Speaker_Box_v2.3mf]
2025-10-22 Move Fall 2024 and Spring 2025 into Documentation
    [Project BOMs.xlsx, Project.xlsx, Target_Slave.xlsx, master.xlsx]
2025-10-22 Archive Target Slave as Revision A
    [Slave BOM.csv, Target_Slave.csv]
2025-10-22 Archive Blaster KiCad files as Revision A
    [Project-B_Cu.gbr, Project-B_Mask.gbr, Project-B_Paste.gbr, Project-B_Silkscreen.gbr, Project-Edge_Cuts.gbr, Project-F_Cu.gbr, Project-F_Mask.gbr, Project-F_Paste.gbr]
2025-10-22 Update KiCad Titleblock
2025-10-22 Target Slave Revision B schematic update
    [Target_Slave.kicad_sch]
2025-10-22 Add Target Slave Revision B Schematic PDF
